meganetaaan/microduck-stackchan/design/arms/Chunky_Flap_Arm_Concepts_v1/MODEL-LICENSE.md

# MicroDuck model license and attribution

Source author: Pollen Robotics

Source: https://github.com/pollen-robotics/microduck_rl

Pinned source revision: `8d0db74916a4f833d1d9b95d6a1d7f4d13b9d5ec`

The source README states:

> 3D model files are licensed under Creative Commons BY-SA-NC.

Exact source declaration:
https://github.com/pollen-robotics/microduck_rl/blob/8d0db74916a4f833d1d9b95d6a1d7f4d13b9d5ec/README.md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

The declaration identifies attribution, noncommercial use, and share-alike conditions. It does not specify a Creative Commons version or link a separate legal-code text. This release preserves that declaration rather than inventing a version such as 4.0. Please obtain clarification from the upstream rights holder if your use depends on a particular version, commercial permission, or another unresolved legal detail. Nothing here expands the rights the original author granted.

## Scope and modifications

This attribution applies to the retained MicroDuck leg/pelvis/battery and other inherited model content, and to derivative geometric content incorporated into the Tab5/Stack-chan prototype generations and arm concepts. It remains relevant after conversion, combining parts, mesh processing, MuJoCo compilation, compression, or rendering.

Project modifications include removal of the articulated head/neck, addition of fixed Tab5 body and enclosure variants, rounded and portrait printable concepts, UART/electronics/wiring proxies, arm-design concepts, collision decomposition, and browser visualization/compiled model packaging. Per-variant README files and generation/validation records describe the changes. These are independent experimental adaptations, not original manufacturer CAD or endorsed products.

When sharing original or modified geometry-bearing material, retain Pollen Robotics attribution, the source link, this license declaration, and a description of changes. Preserve the upstream noncommercial and share-alike conditions. Do not add a blanket Apache or MIT label to these assets. This file is a record of the upstream declaration, not a replacement license or a legal assurance.

## Other mechanical references

Tab5, Radxa ZERO 3W, screws, connectors, and controller/electronics objects modeled by this project are simplified dimensional or keepout proxies unless expressly documented otherwise. Manufacturer documents and CAD were consulted for dimensions; that does not grant rights to redistribute manufacturer source files. The release does not include the original Radxa STEP/DXF, the direct coarse conversion of that STEP, or M5Stack reference photographs/drawings. If such files are added later, check their own redistribution terms separately.
