meganetaaan/microduck-stackchan/design/arms/Chunky_Flap_Arm_Concepts_v1/assets/base_1687_stackchan_microduck_screen_720x1280.png

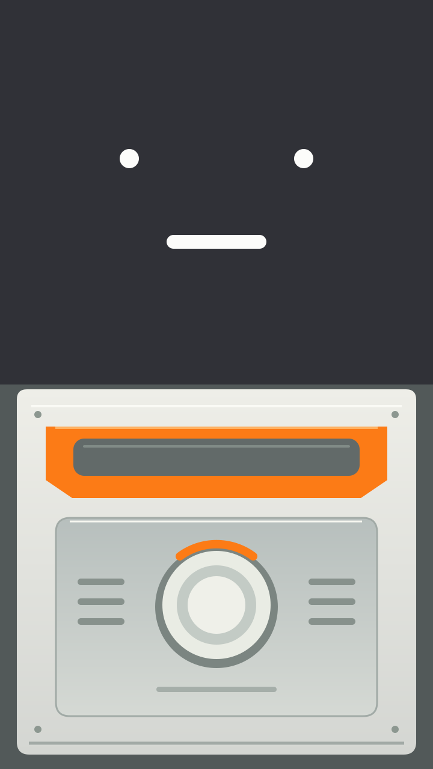
design/arms/Chunky_Flap_Arm_Concepts_v1/assets/base_1687_stackchan_microduck_screen_720x1280.png
