meganetaaan/microduck-stackchan/design/arms/Chunky_Flap_Arm_Concepts_v1/chunky_flaps_front.png

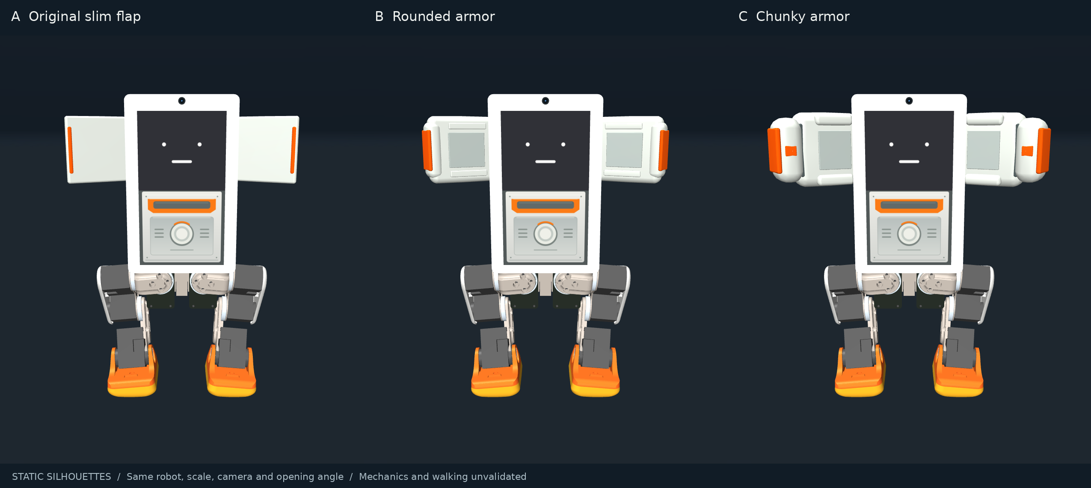
design/arms/Chunky_Flap_Arm_Concepts_v1/chunky_flaps_front.png
