meganetaaan/microduck-stackchan/design/arms/MicroDuck_Stackchan_Arm_Concepts_v1/arm_concepts_comparison.png

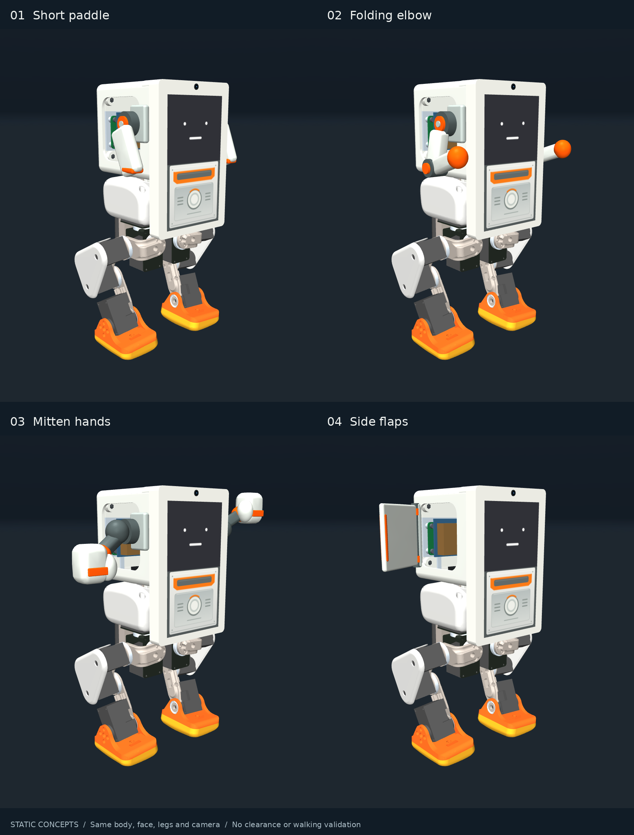
design/arms/MicroDuck_Stackchan_Arm_Concepts_v1/arm_concepts_comparison.png
