meganetaaan/microduck-stackchan/prototype/diagnostics/cutout_candidate_comparison.png

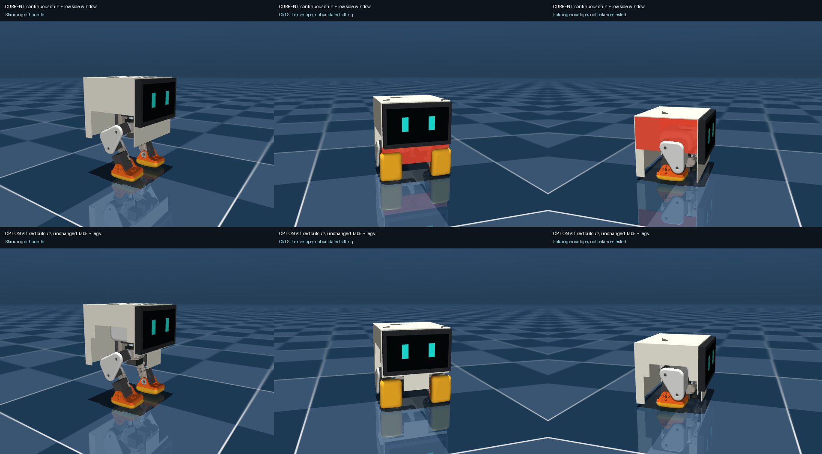
prototype/diagnostics/cutout_candidate_comparison.png
