meganetaaan/microduck-stackchan/prototype/diagnostics/feet_flat_crouch_comparison.png

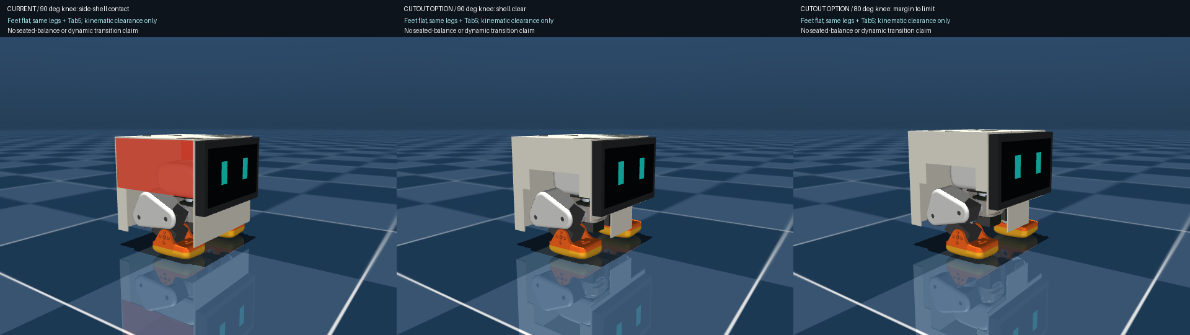
prototype/diagnostics/feet_flat_crouch_comparison.png
