meganetaaan/microduck-stackchan/prototype/portrait/front.png

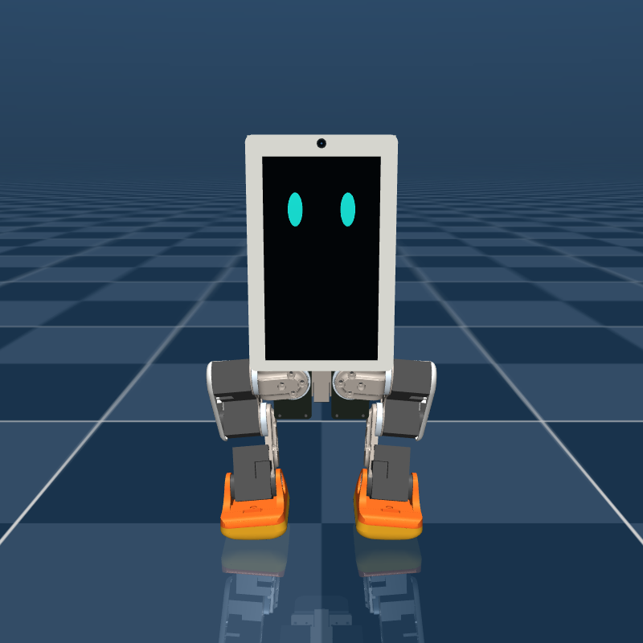
prototype/portrait/front.png
