meganetaaan/microduck-stackchan/prototype/portrait/portrait_clearance_poses.png

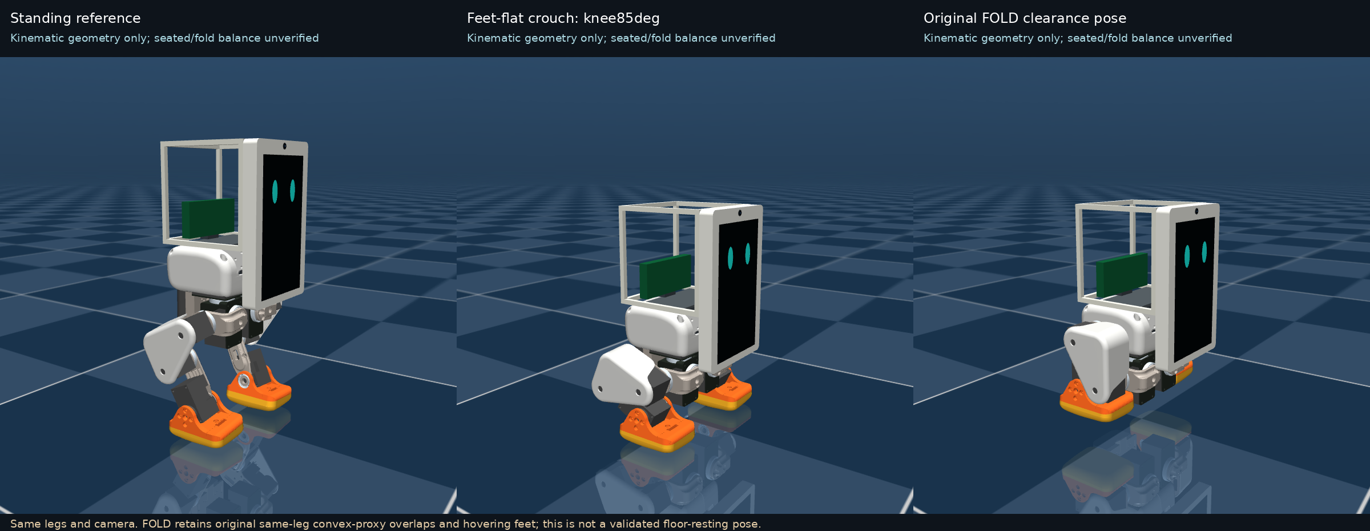
prototype/portrait/portrait_clearance_poses.png
