meganetaaan/microduck-stackchan/prototype/portrait/portrait_comparison.png

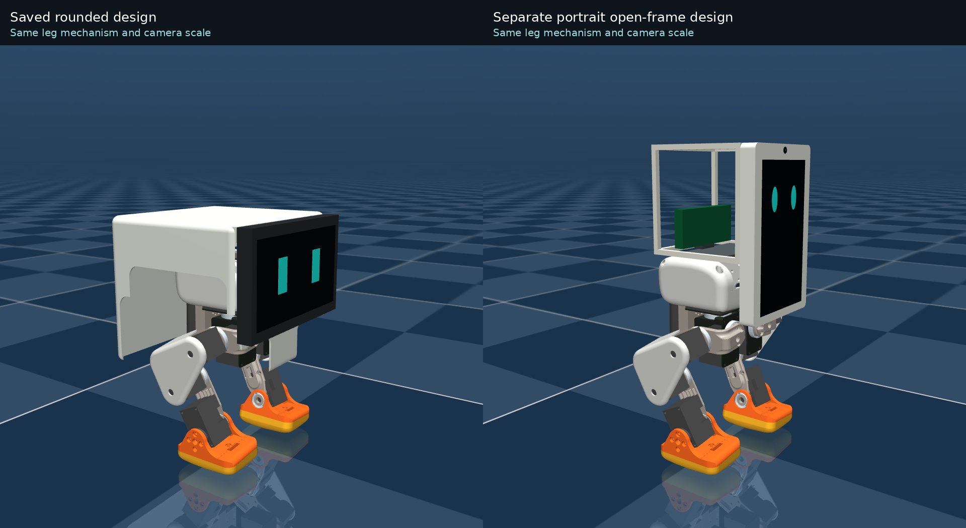
prototype/portrait/portrait_comparison.png
