meganetaaan/microduck-stackchan/prototype/portrait/portrait_face_closeup.png

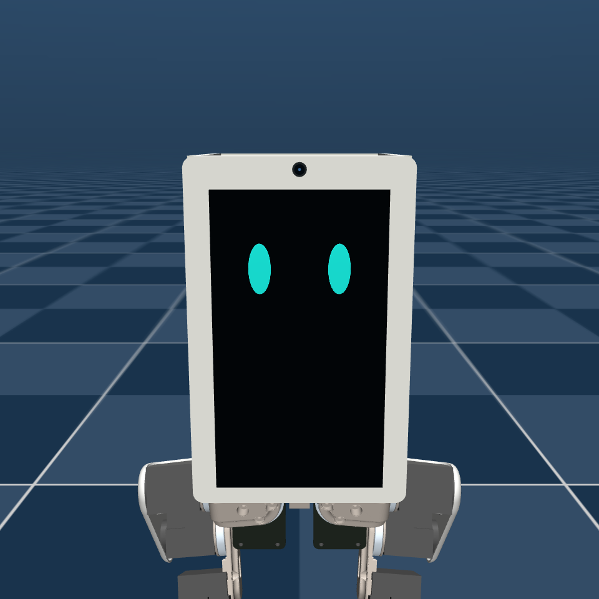
prototype/portrait/portrait_face_closeup.png
