meganetaaan/microduck-stackchan/prototype/portrait/portrait_views.png

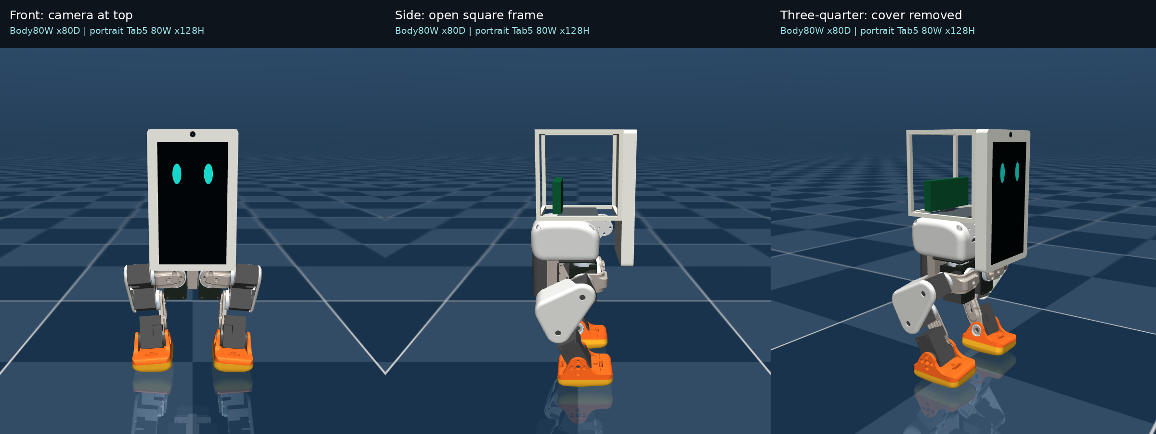
prototype/portrait/portrait_views.png
