meganetaaan/microduck-stackchan/prototype/portrait/side.png

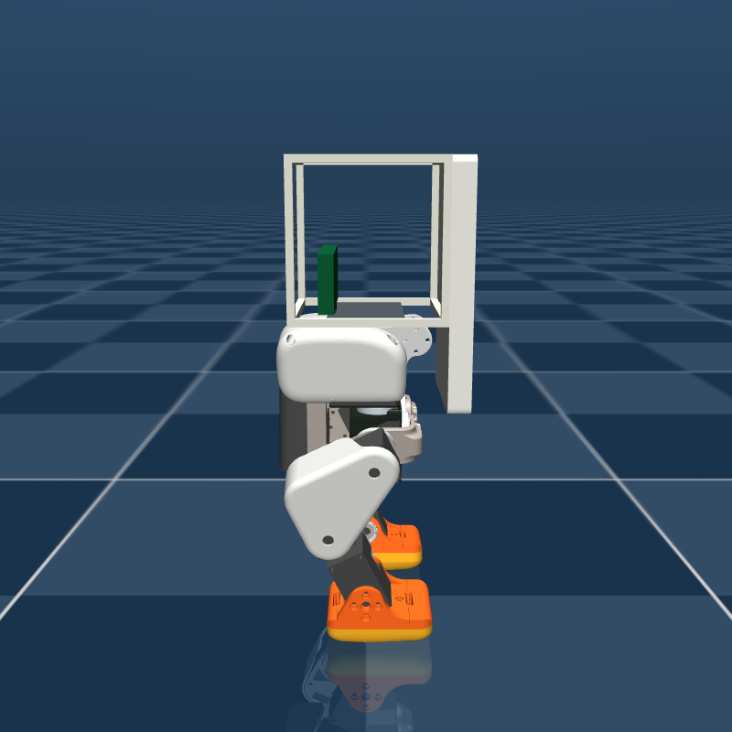
prototype/portrait/side.png
