meganetaaan/microduck-stackchan/prototype/portrait/three-quarter.png

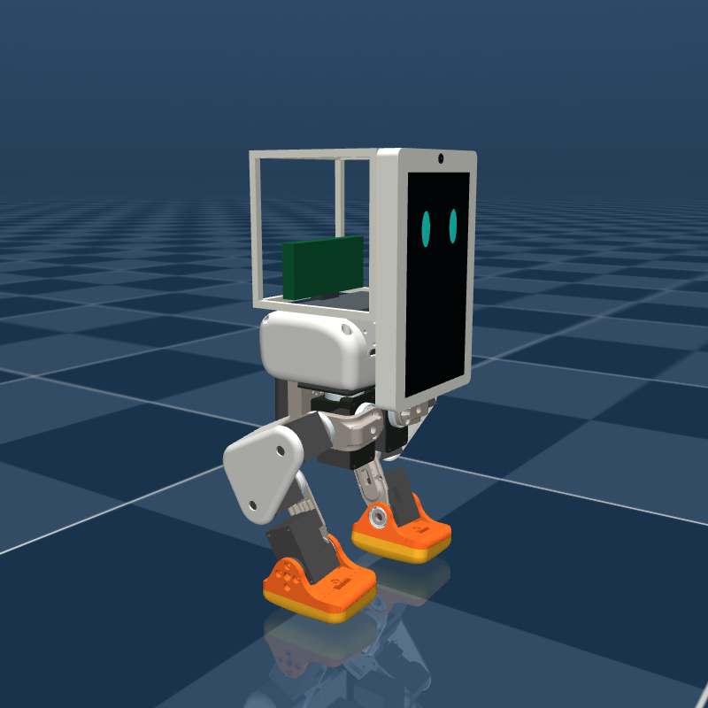
prototype/portrait/three-quarter.png
