meganetaaan/microduck-stackchan/prototype/portrait/walking_demo_initial.png

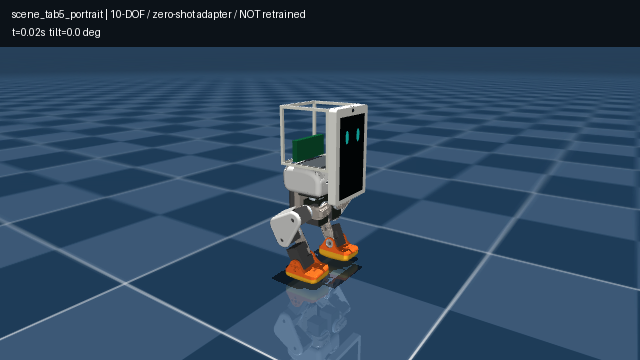
prototype/portrait/walking_demo_initial.png
