meganetaaan/microduck-stackchan/prototype/portrait/walking_frame3s.png

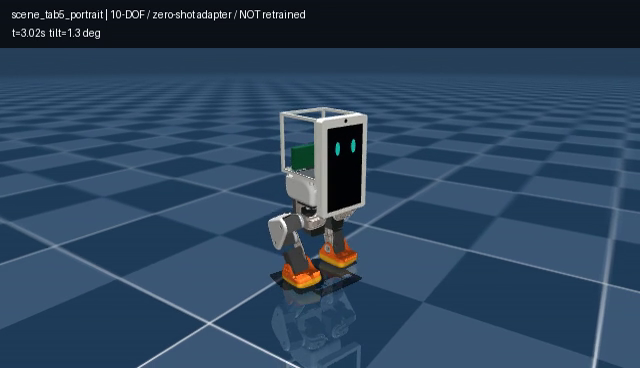
prototype/portrait/walking_frame3s.png
