meganetaaan/microduck-stackchan/prototype/rounded/0_front.png

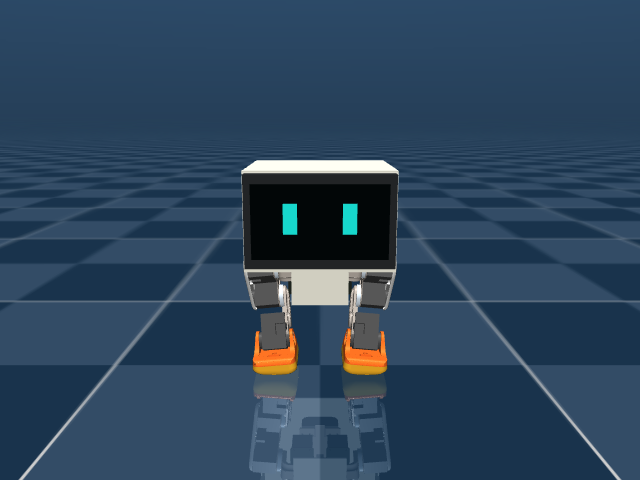
prototype/rounded/0_front.png
