meganetaaan/microduck-stackchan/prototype/rounded/0_side.png

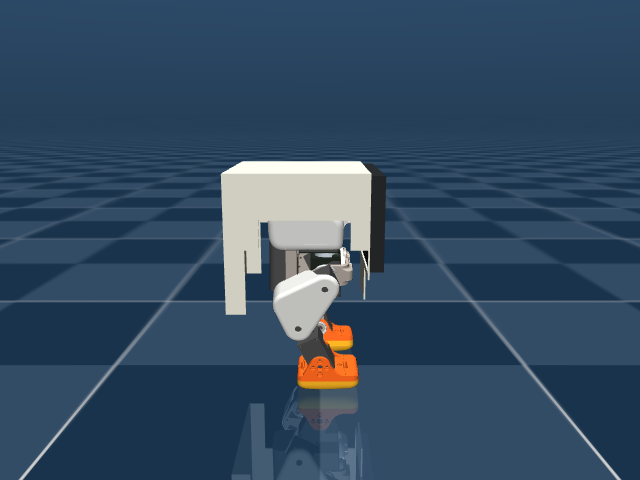
prototype/rounded/0_side.png
