meganetaaan/microduck-stackchan/prototype/rounded/0_three-quarter.png

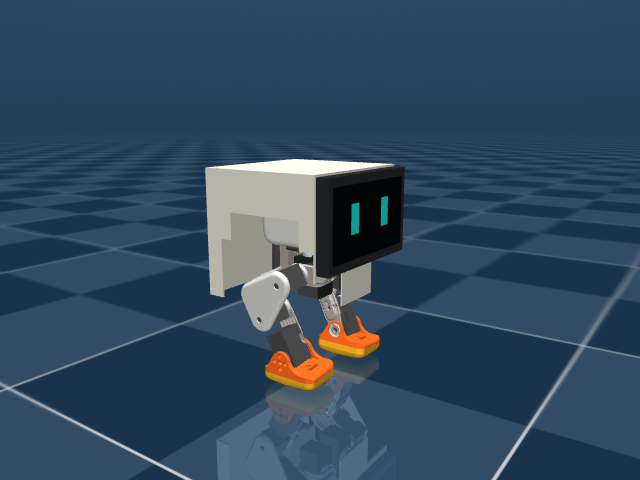
prototype/rounded/0_three-quarter.png
