meganetaaan/microduck-stackchan/prototype/rounded/preview_threequarter.png

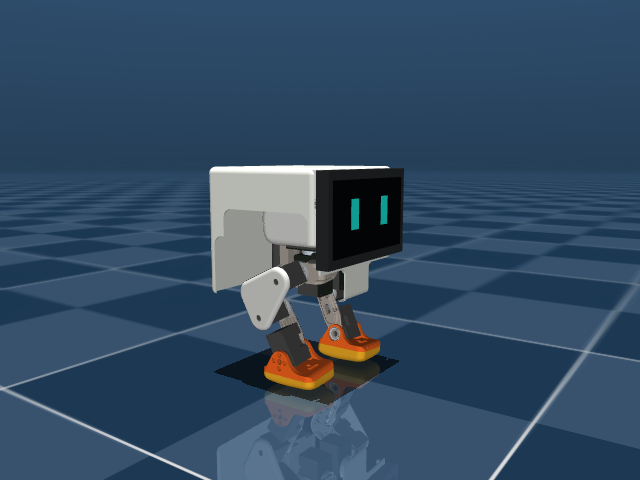
prototype/rounded/preview_threequarter.png
