meganetaaan/microduck-stackchan/prototype/rounded/rounded_before_after.png

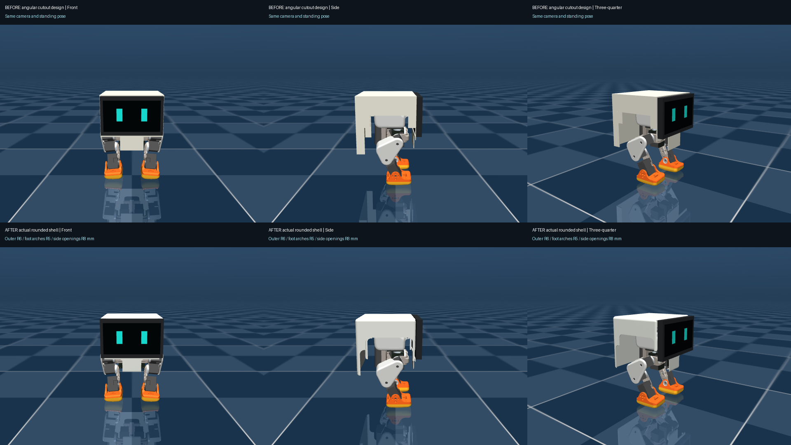
prototype/rounded/rounded_before_after.png
