meganetaaan/microduck-stackchan/prototype/rounded/rounded_closeup.png

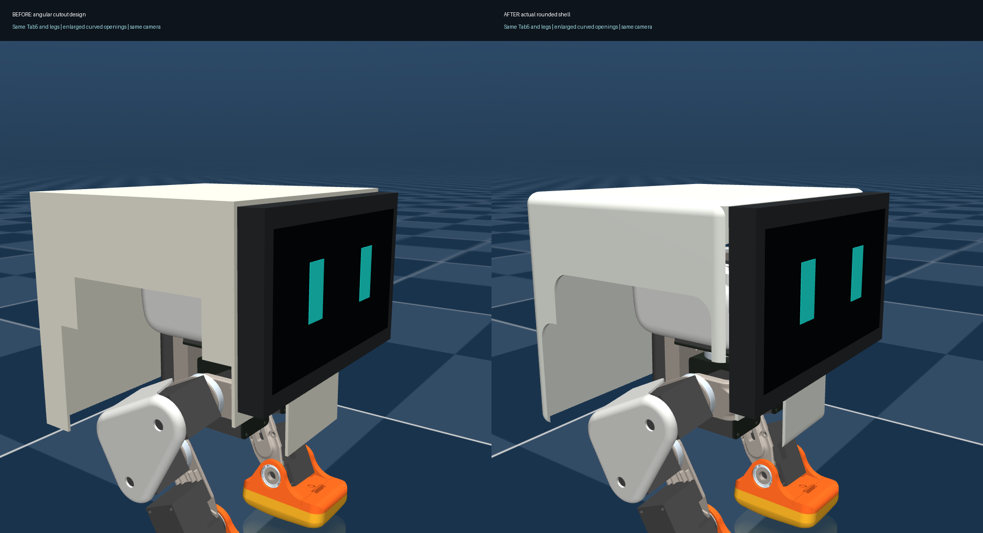
prototype/rounded/rounded_closeup.png
