meganetaaan/microduck-stackchan/prototype/rounded/walking_demo_initial.png

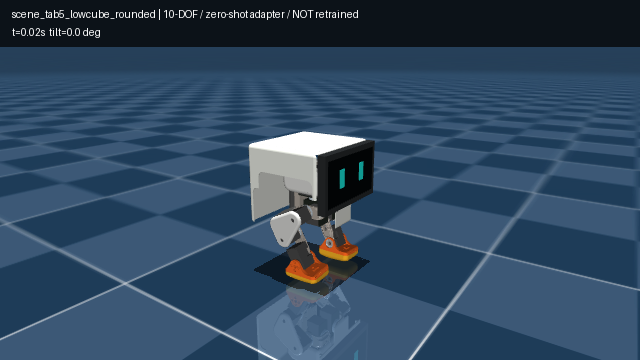
prototype/rounded/walking_demo_initial.png
