meganetaaan/microduck-stackchan/prototype/rounded/walking_frame3s.png

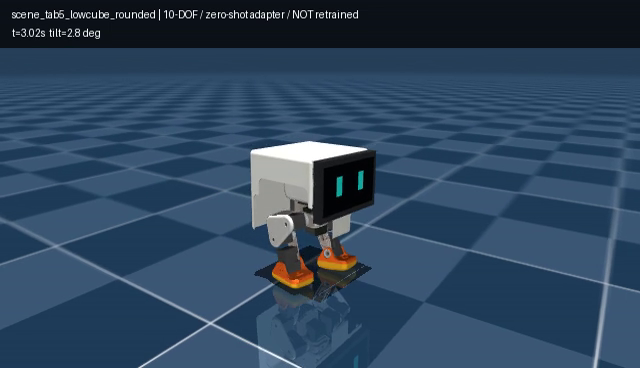
prototype/rounded/walking_frame3s.png
