meganetaaan/microduck-stackchan/docs/BOM-ja.md

# MicroDuck Stack chan UARTアセンブリの暫定部品表

更新日 2026年10月2日

主案は、Tab5をUIとして使い、MicroDuckのSoCへ3.3 V UARTで指示を送る構成です。Tab5は機体の保護・主スイッチ後の2S系統からHVINへ給電します。USB-UARTは直結できない場合の代替案であり、両方を常設する部品表ではありません。

実機がないため、購入・配線仕様を確定していない部品は明記しています。以下の形状・重量は`prototype/assembly_uart/`のモデルに対応します。

## 主な機器と電装

| ID | 部品 | 数量 | モデルでの扱い | 残る確認 |
| --- | --- | ---: | --- | --- |
| E01 | MicroDuckの脚・サーボ・元の胴体・2S系統 | 1式 | 既存機構を維持 | 入手する機体の版、主スイッチ・保護回路・電源取出口 |
| E02 | Tab5本体 | 1 | 80 ×128 ×12 mm、118.4 g、縦向き、カメラ上 | 実機版、裏面細部、HVIN起動・停止、ピーク電流 |
| E03 | Radxa ZERO 3W | 1 | PCB 65 ×30 ×1.6 mm、4穴直径2.8 mmは公式CAD由来。部品群込み12 gを仮定 | 実重量、端子の版差、実際の装着基板 |
| E04 | MicroDuck Robot HAT／制御部 | 1式 | 維持する前提で66 ×34 mmの仮基板と部品空間、計19 g | 実寸・積層高さ・接続方式・重量。公式CADの正確な形状ではない |
| E05 | Radxa GPIO引出し／中継部 | 1式 | 物理pin 16/18とGNDを取り出す仮の空間を確保 | HATで塞がれた端子へのアクセス、必要な中継基板やハーネス |
| E06 | Tab5 M5-Bus差込・引出し部 | 1 | 2×15ピン側の仮差込外形。GPIO6/7とGNDを使用 | 嵌合部、差込深さ、端子・ピン向き |
| E07 | 3.3 V UART線 | 3芯1組 | TX、RX、GND。青い直径約2 mmの束で配置 | 線径、端子、長さ、引張保持、ノイズ・通信確認 |
| E08 | Tab5付属1.25 mmピッチ6Pケーブル | 1 | J7 pin 1 GND、pin 2 HVIN。赤い電源線として配置 | 実物の極性・向き・許容電流。未使用4線は個別絶縁 |
| E09 | 交換可能なロボット側ピッグテール | 1式 | 機体側終端と内側の着脱部、分岐入力線を仮配置 | 取出口とコネクタ系列、極性、線径、長さ、接点容量 |
| E10 | 分岐保護モジュール | 1系統 | 20 ×30 mmの仮基板、保護素子・入出力コネクタの空間を配置 | ヒューズ等の方式、電流定格、回路、コネクタ、固定方法 |
| E11 | 保護部用絶縁・接着支持材 | 1式 | 仮の0.5 mmパッドとプリントトレー | 材質、保持力、温度、実モジュールの取付 |
| E12 | 電源貫通部グロメット | 1 | 名目直径7 mm穴、直径4 mm内側通路の仮形状 | 実品または材質・印刷方法、パネル厚と保持力 |
| E13 | 未使用線絶縁・追加配線固定材 | 1式 | 4線の個別絶縁と、ガイドに沿う固定を見込む | 現物に合う径・数量。ガイドだけで引張保持を保証しない |
| E14 | 外付け降圧器 | 0 | 主案はTab5内蔵降圧回路を使う | 入力・ノイズ・負荷測定で必要なら見直す |
| E15 | Tab5用追加バッテリー | 0 | 主案に含めない | 停止・瞬停・再起動要件を実機で確認 |
| E16 | USB-UART変換器とRadxa側USB接続部 | 0、代替時のみ1式 | 直結不可の場合の3.3 Vロジック用代替。現在のモデルに重ねて常設していない | USBホスト接続、ドライバー、論理レベル、配線。Tab5の主電源にはしない |

Radxaの総重量の公式値は見つかっておらず、12 gは設計上の仮定です。HAT、コネクタ、保護部、配線の重量も計測値ではありません。標準モデル736.537 gに対し、未確定部品の軽量・重量仮定は717.815〜767.712 gです。

## UART接続の選択

| Tab5側 | 接続 | MicroDuck SoC側 |
| --- | --- | --- |
| M5-Bus物理pin 16、GPIO6、UART TXとして設定 | → | Radxa 40ピン物理pin 16、UART4 RX_M1 |
| M5-Bus物理pin 15、GPIO7、UART RXとして設定 | ← | Radxa 40ピン物理pin 18、UART4 TX_M1 |
| GND | 共通 | GND |

物理ピン番号とGPIO番号を混同しません。使用するRadxaのGND端子は実物の接続しやすさと既存HATを確認して決めます。5 Vや3.3 Vの給電線を、この信号3本の代わりに接続しません。OSのUART有効化、Tab5のピン設定、HATとのピン共用は未確認です。

## 印刷部品

各1個。現在の5部品は`prototype/assembly_uart/stl/`にあり、単位はmmです。

| ID | 部品 | ファイル | 計算上の樹脂質量 |
| --- | --- | --- | ---: |
| P01 | ボディケージ、M5-Bus逃げ・電源貫通穴・M3頭逃げ付き | `body_cage_mm.stl` | 約64.58 g |
| P02 | 中央マウント、M2ナット逃げ付き | `central_mount_mm.stl` | 約7.04 g |
| P03 | 電子部品キャリア、基板支持・配線ガイド付き | `electronics_carrier_mm.stl` | 約17.40 g |
| P04 | 電源保護部の仮トレー | `protection_tray_mm.stl` | 約2.35 g |
| P05 | 背面カバー、前版と同一 | `rear_cover_mm.stl` | 約10.99 g |

合計約102.36 gはPLA密度1,240 kg/m³と実体積からの計算値です。実際の材料、スライス設定、支持材、実測重量ではありません。グロメットや基板をこれらと同じ樹脂で印刷する想定ではありません。

## ねじと取付部

| ID | 用途 | 数量 | 現モデルの名目形状 | 取扱い |
| --- | --- | ---: | --- | --- |
| F01 | 背面カバー用M2ねじ | 4 | 軸長8 mm、頭径3.9 × 厚さ0.7 mm | 薄頭の仮形状。通常のM2なべねじの適合は未確認 |
| F02 | 同M2六角ナット | 4 | 二面幅4 × 厚さ1.6 mm | 印刷公差と実物寸法を確認 |
| F03 | 元の胴体スロット用M2クランプねじ | 1 | 軸長6.8 mm、頭径3.8 × 厚さ1.5 mm | 購入する長さ・形状、締付力、元プレートの変形は未確定 |
| F04 | 同M2六角ナット | 1 | 二面幅4 × 厚さ1.6 mm | 回り止め・ねじかかりを確認 |
| F05 | 金属製大径ワッシャー | 1 | 外径8、内径2.7、厚さ0.8 mm | M2.5用相当をM2クランプで使う仮案 |
| F06 | 中央マウント・ボディ・キャリア用M2ねじ | 2 | 軸長10 mm、頭径3.8 × 厚さ1.6 mm | 対応する穴とナット逃げをモデル化。実品・印刷強度は未検証 |
| F07 | 同M2六角ナット | 2 | 二面幅4 × 厚さ1.6 mm | 中央マウントの側面から入れる仮構造 |
| F08 | Radxa固定用M2.5ねじ | 4 | 軸長12 mm、頭径4.5 × 厚さ2.5 mm | 通し穴・支持部に対応。実基板の部品干渉と実品寸法を確認 |
| F09 | 同M2.5六角ナット | 4 | 二面幅5 × 厚さ2 mm | キャリア裏側に配置。締付トルクは未規定 |
| F10 | Tab5背面M3ねじ | 4 | モデルは頭径5.5 × 厚さ3 mmと外側9 mmの軸だけ | 内部へ入る長さを未確定のまま残す。完成ねじの全長を9 mmとは扱わない |
| F11 | 未確定のM3内部部分・小固定具 | 1式 | 質量1 gの追加見込み | 実物に合わせて置換。0〜2 gの感度条件も用意 |
| F12 | 熱圧入インサート | 0 | 現モデルでは使用しない | 将来方式を変える場合のみ追加 |

したがってモデル上の本数はM2ねじ7本とナット7個、M2.5ねじ4本とナット4個、M3の外側部分4本、大径ワッシャー1枚です。コネクタ、HAT、保護モジュール等の実製品に付属する固定具までは確定していません。

Tab5の図面表記`M3*10`を10 mmの挿入許容深さと読み替えません。M3の頭逃げや各プリント部の局所的な薄肉について、試し刷りと強度確認が必要です。

## 出典と追跡

- [Tab5公式資料](https://docs.m5stack.com/en/core/Tab5)、[ピン図](https://m5stack-doc.oss-cn-shenzhen.aliyuncs.com/1132/C145_Pinmap_Overview.png)、[回路図](https://m5stack-doc.oss-cn-shenzhen.aliyuncs.com/1132/Tab5_Schematics_PDF.pdf)
- [Radxa ZERO 3W公式ハードウェア資料](https://docs.radxa.com/en/zero/zero3/download)、[GPIO表](https://docs.radxa.com/en/zero/zero3/hardware-design/hardware-interface)
- [MicroDuckのHAT構成](https://github.com/pollen-robotics/microduck/blob/main/deploy/audio/i2c3-pihat.dts)
- [モデルの部品一覧と質量](../prototype/assembly_uart/assembly_report.json)、[公式寸法と仮定を分けた根拠](../prototype/assembly_uart/sources/component_envelopes_report.json)、[設計前提と確認表](DESIGN-ASSUMPTIONS-ja.md)
