meganetaaan/microduck-stackchan/docs/history/v3-wifi-plan/BOM-ja.md

# MicroDuck Stack chan 縦型Tab5案の暫定部品表

更新日 2026年10月2日

実機が手元にない段階で、選定済みの縦型Tab5・前面フラット接触部の設計を進めるための部品表です。外装形状は現在のモデルを維持し、電源・通信・取付部品は確認できた範囲と仮置きを分けています。この表だけで発注や実機への配線を確定しません。

## 今回の仮置き

- Tab5は画面・顔・操作UIを担当し、MicroDuckのSoCが歩行制御を担当する
- 電源はMicroDuckの保護・主電源スイッチ後の2S系統から分岐し、Tab5のExtPort2 J7へ供給する構成を第一案とする
- Tab5の内蔵降圧回路を使い、外付け降圧器とTab5用の別バッテリーは第一案に含めない
- 通信はWi-Fiで指示と状態を交換する。本試作のTab5連携API、接続方式、通信断時の挙動は未実装・未確定
- ロボット側の電源接続は交換可能な短い変換ハーネスにし、コネクタが判明するまで専用の外装穴を固定しない

詳細は[設計前提と確認項目](DESIGN-ASSUMPTIONS-ja.md)を参照してください。

## 機器と電装

| ID | 部品 | 暫定数量 | 現時点の扱い | 確定に必要なこと |
| --- | --- | ---: | --- | --- |
| E01 | MicroDuck本体、SoC、2S電源系 | 1式 | 元の脚・サーボ・制御基板・バッテリー系を使う設計前提 | 入手する機体の版、SoC、保護回路、主スイッチ、電源コネクタの確認 |
| E02 | M5Stack Tab5本体 | 1 | 縦向き、カメラ上、顔は画面上半分。別バッテリーなし | 実機版、背面形状、HVIN起動動作、最大消費電流の確認 |
| E03 | Tab5付属1.25 mmピッチ6ピンケーブル | 1 | ExtPort2 J7の電源入力用。正式なコネクタシリーズや線色は推定しない | ピン番号と向き、付属ケーブル実物、接点・線材の許容電流 |
| E04 | ロボット側交換用電源ピッグテール | 1式 | 保護・主スイッチ後の分岐とTab5側ケーブルを接続する短い交換部品 | ロボット側コネクタ、極性、線径、長さ、ロック方式、許容電流 |
| E05 | 分岐側ヒューズ等の保護部品 | 1系統分を仮置き | 定格・方式・取付場所はTBD。現時点で電流値を指定しない | Tab5の突入・ピーク電流、線材・接点定格、故障時の遮断条件 |
| E06 | 未使用線の端末絶縁材 | 4本分 | J7の未使用4線を1本ずつ絶縁する。まとめて導体同士を接触させない | 線径に合う絶縁材と処理方法 |
| E07 | ハーネス固定・ストレインリリーフ部材 | 1式 | 仮置き。外装への専用穴・固定座の寸法はまだ決めない | ケーブル径、コネクタ寸法、曲げ半径、着脱方向、脚との干渉 |
| E08 | 外付け降圧器 | 0 | 第一案ではTab5の6–24 V入力と内蔵降圧回路を使う | 実機の供給範囲・ノイズ・電流測定で必要なら再検討 |
| E09 | Tab5用追加バッテリー | 0 | 第一案には含めない | 終了処理・瞬停対策の要件が変わる場合だけ再検討 |
| E10 | USB接続ケーブル | 常設分は0 | 第一案の主電源・常時通信には使わない | 開発・保守で使う場合は給電経路と逆流を別途確認 |

J7はpin 1がGND、pin 2がSYS_VIN（製品表記HVIN、6–24 V）です。pin 3/4のRS485 A/B、pin 5/6のSDA/SCLは第一案では使用しません。配線の向きは公式ピン図と実物を照合し、ケーブルの色だけで判断しません。これは結線方針であり、実機に適用する確定配線図や通電手順ではありません。[S1][S2][S3]

Radxa ZERO 3WのUSBホスト出力は資料上500 mAです。Tab5を十分に給電できるとは仮定しません。また、普通のUSBケーブルを「データ専用」とは扱いません。外部電源とUSBを併用する場合は、双方の電源経路を確認する必要があります。[S4]

## 3Dプリント部品

以下は各1個です。STLは`prototype/portrait_print/stl/`、推奨向きのSTLは`stl_print_oriented/`にあります。座標単位はmmです。

| ID | 部品 | ファイル | 外形の最大寸法 | モデル上の樹脂質量 |
| --- | --- | --- | --- | ---: |
| P01 | ボディケージ | `body_cage_mm.stl` | 奥行80 × 幅80 × 高さ80 mm | 約65.49 g |
| P02 | 背面カバー | `rear_cover_mm.stl` | 幅59.5 × 高さ63.5 × 厚さ2.4 mm | 約10.99 g |
| P03 | 中央マウント | `central_mount_mm.stl` | 奥行24 × 幅12 × 高さ46 mm | 約7.18 g |
| P04 | SoC仮置き用支持台 | `compute_pedestal_mm.stl` | 奥行8 × 幅16 × 高さ5.6 mm | 約0.86 g |

計約84.52 gはPLA密度1,240 kg/m³による実体積からの計算値です。実際のスライス設定、支持材、材料や実測重量ではありません。P04は実基板の取付穴を備えた確定マウントではありません。

## ねじ類と取付部

「モデルにある寸法」と「購入できる確定仕様」を区別します。ねじの長さ・頭形状・かかり代は、印刷部品と機器の実測後に選びます。

| ID | 用途 | 数量 | 現モデルの寸法・構成 | 未確定事項 |
| --- | --- | ---: | --- | --- |
| F01 | 背面カバー用M2ねじ | 4 | 軸長8 mm、頭径3.9 mm、頭厚0.7 mmの仮形状 | 市販品の規格・頭形状。通常のM2なべねじが適合するとは限らない |
| F02 | 背面カバー用M2六角ナット | 4 | 二面幅4 mm、厚さ1.6 mmの仮形状 | 実ナット公差と印刷収縮。ナット穴は二面幅4.3 mm、生成形状の深さ2.0 mm |
| F03 | 元の胴体スロットを挟むM2ねじ | 1 | 軸長6.8 mm、頭径3.8 mm、頭厚1.5 mmの仮形状 | 市販のねじ長さ、締付力、約1 mmの元プレートの変形、緩み止め |
| F04 | 上記クランプ用M2六角ナット | 1 | 二面幅4 mm、厚さ1.6 mm | 接触・かかり代・回り止め |
| F05 | 金属製大径ワッシャー | 1 | 外径8、内径2.7、厚さ0.8 mm。M2.5用相当をM2クランプで使う仮案 | 実品の寸法・材質・当たり。樹脂ワッシャーには置換しない前提 |
| F06 | Tab5背面用M3ねじ | 4か所分を想定 | 外装側は直径3.4 mmの通し穴、名目9 mmの取付ランド | ねじ自体は未モデル化。Tab5の許容かかり代と適切な全長を実測する |
| F07 | ボディと中央マウントの上側固定具 | 2か所分、部品数TBD | 直径2.2 mmのパイロット／通し穴 | ねじ、ナット、インサート等の方式そのものが未選定 |
| F08 | SoC基板の固定具 | TBD | 基板固有の穴、ねじ、スペーサーは未設計 | 実基板の寸法・穴・端子・絶縁・放熱を確認 |
| F09 | 熱圧入インサート | 0（現モデル） | 現モデルにインサート座はない | 今後方式を選ぶ場合にのみ追加検討 |

明示的な金属形状はM2ねじ5本、M2ナット5個、ワッシャー1枚です。F06〜F08を含む完成品の総ねじ数ではありません。Tab5の図面表記`M3*10`を、ねじを10 mm挿入できるという意味には読み替えません。[S3]

背面カバーの頭逃げは直径4.2 × 深さ1.0 mmです。F01の薄い仮頭形状を理由に、未確認の標準ねじを発注しません。ソースの`rear_nut_pocket_depth_mm=1.9`は現生成処理で使われておらず、実際のナット穴深さは2.0 mmです。今回は形状を変更していません。

## 出典

- [S1 Tab5公式製品資料](https://docs.m5stack.com/en/core/Tab5)
- [S2 Tab5公式回路図](https://m5stack-doc.oss-cn-shenzhen.aliyuncs.com/1132/Tab5_Schematics_PDF.pdf) J7と電源経路、4〜5ページ
- [S3 Tab5公式ピン図](https://m5stack-doc.oss-cn-shenzhen.aliyuncs.com/1132/C145_Pinmap_Overview.png)／[公式寸法図](https://m5stack-doc.oss-cn-shenzhen.aliyuncs.com/1132/C145_Model_Size_page_01.png)
- [S4 Radxa ZERO 3W製品資料](https://dl.radxa.com/zero3/docs/hw/3w/radxa_zero_3w_product_brief.pdf) 第6.2節
- [現在のパラメータ](../prototype/portrait_print/parameters.json)、[形状生成ソース](../prototype/portrait_print/build_print_design.py)、[形状と質量の報告](../prototype/portrait_print/geometry_report.json)
