meganetaaan/microduck-stackchan/prototype/portrait_print/print_parts_orientation.png

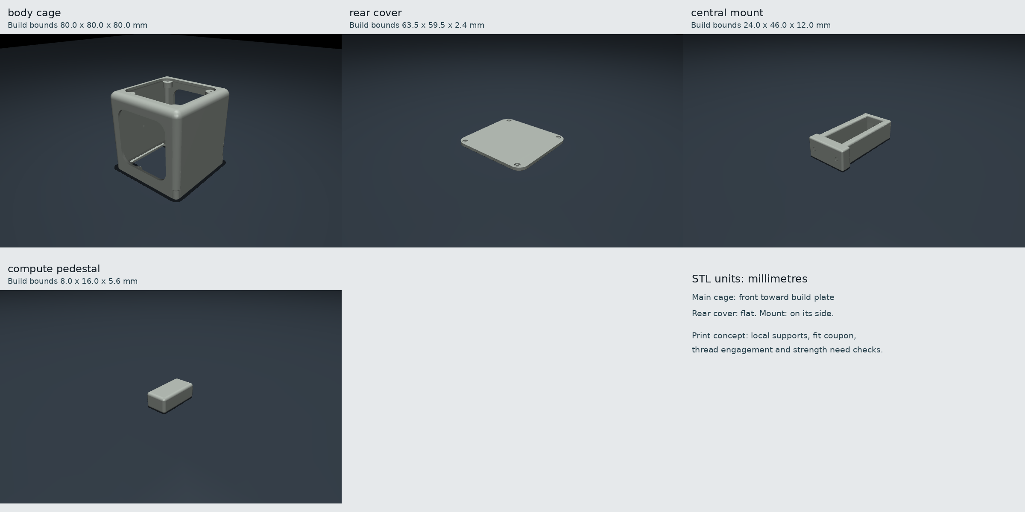
prototype/portrait_print/print_parts_orientation.png
