meganetaaan/microduck-stackchan/design/arms/Chunky_Flap_Arm_Concepts_v1/assets/C_chunky_armor_stowed_R_main_armor.obj

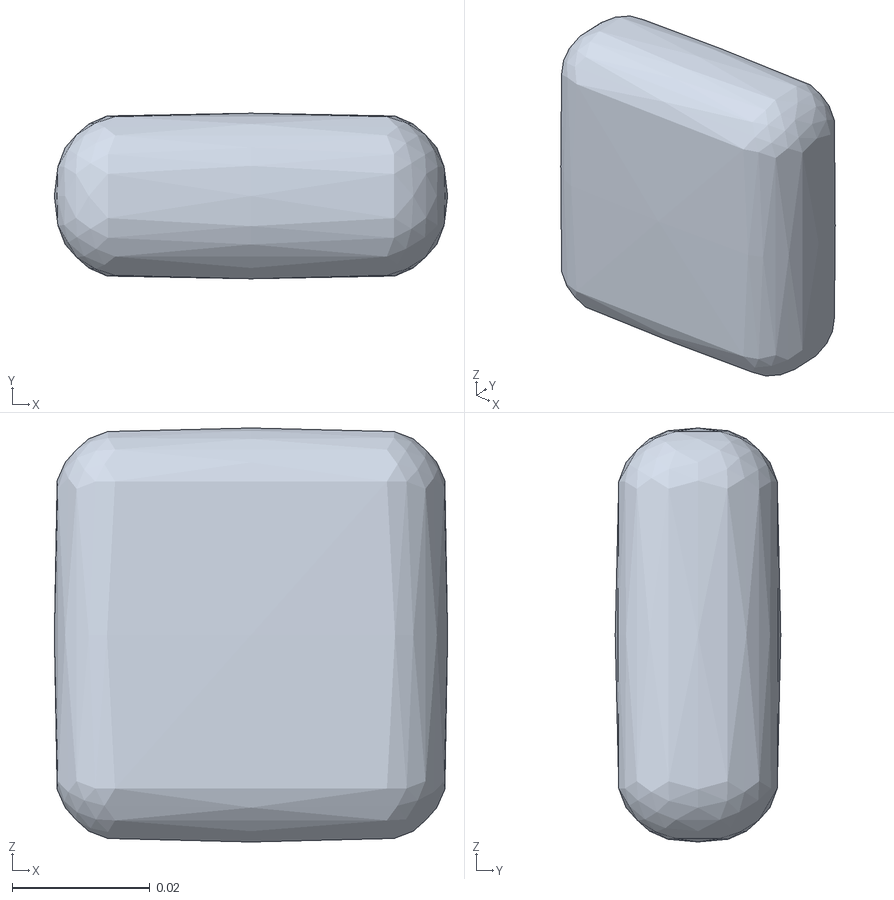
[picture p29: CAD file, 2026-10-03]
design/arms/Chunky_Flap_Arm_Concepts_v1/assets/C_chunky_armor_stowed_R_main_armor.obj
0.057 x 0.024 x 0.06
