meganetaaan/microduck-stackchan/design/arms/Chunky_Flap_Arm_Concepts_v1/assets/C_chunky_armor_display_R_main_armor.obj

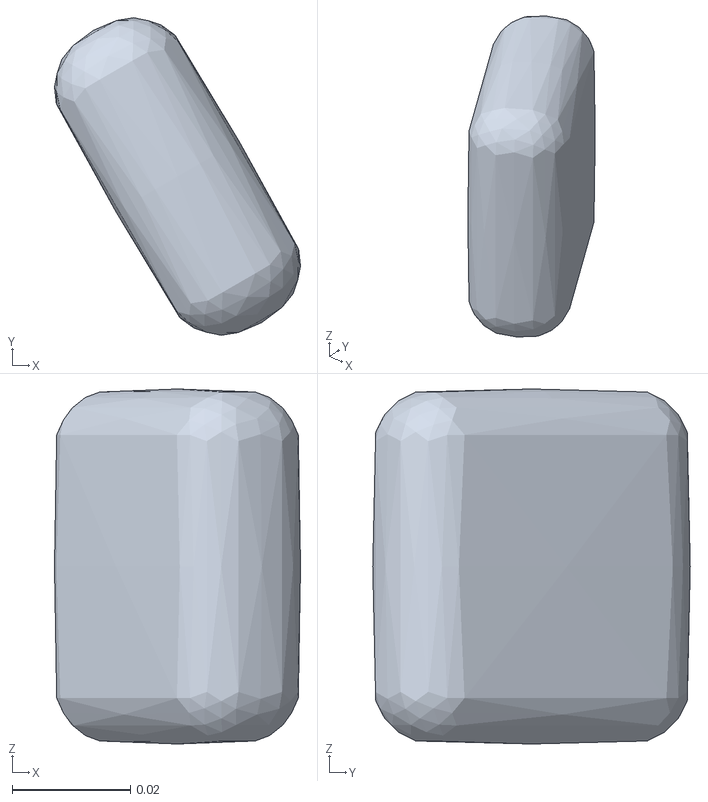
[picture p30: CAD file, 2026-10-03]
design/arms/Chunky_Flap_Arm_Concepts_v1/assets/C_chunky_armor_display_R_main_armor.obj
0.0416 x 0.0537 x 0.06
