meganetaaan/microduck-stackchan/design/arms/Chunky_Flap_Arm_Concepts_v1/assets/B_rounded_armor_stowed_R_lower_rib_-1.obj

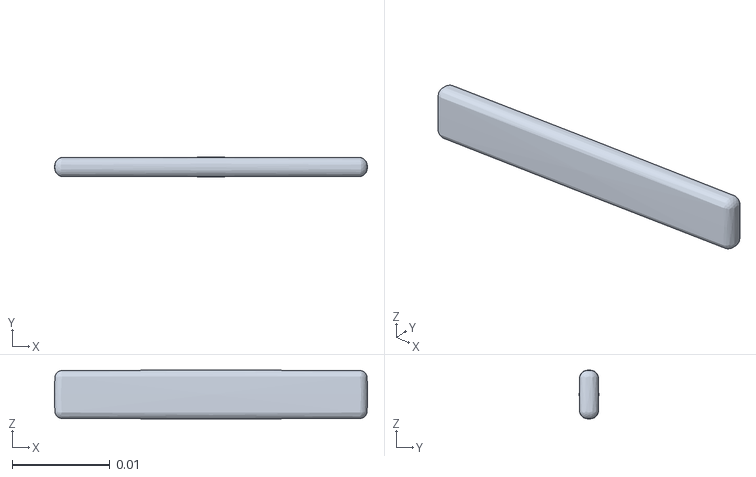
[picture p31: CAD file, 2026-10-03]
design/arms/Chunky_Flap_Arm_Concepts_v1/assets/B_rounded_armor_stowed_R_lower_rib_-1.obj
0.032 x 0.002 x 0.005
