meganetaaan/microduck-stackchan/design/arms/MicroDuck_Stackchan_Arm_Concepts_v1/assets/02_elbow_display_L_orange_cap.obj

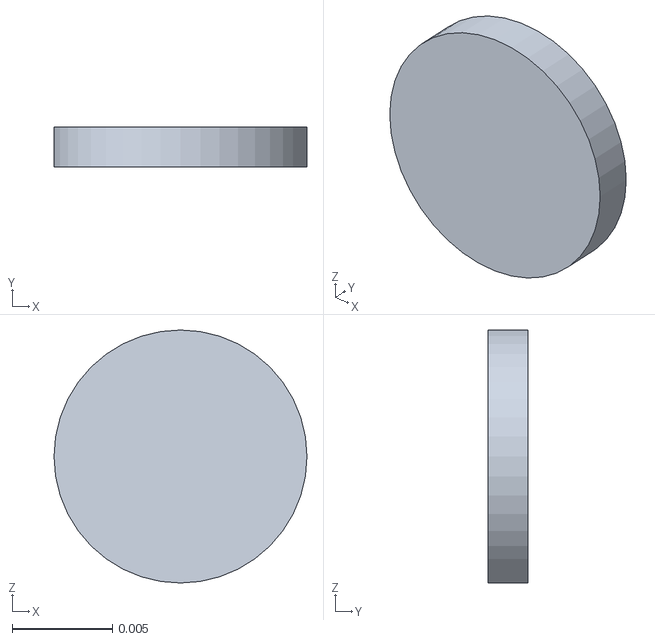
[picture p32: CAD file, 2026-10-03]
design/arms/MicroDuck_Stackchan_Arm_Concepts_v1/assets/02_elbow_display_L_orange_cap.obj
0.0126 x 0.002 x 0.0126
