meganetaaan/microduck-stackchan/prototype/assembly_uart/assets/cube_uart_body_cage_0397.obj

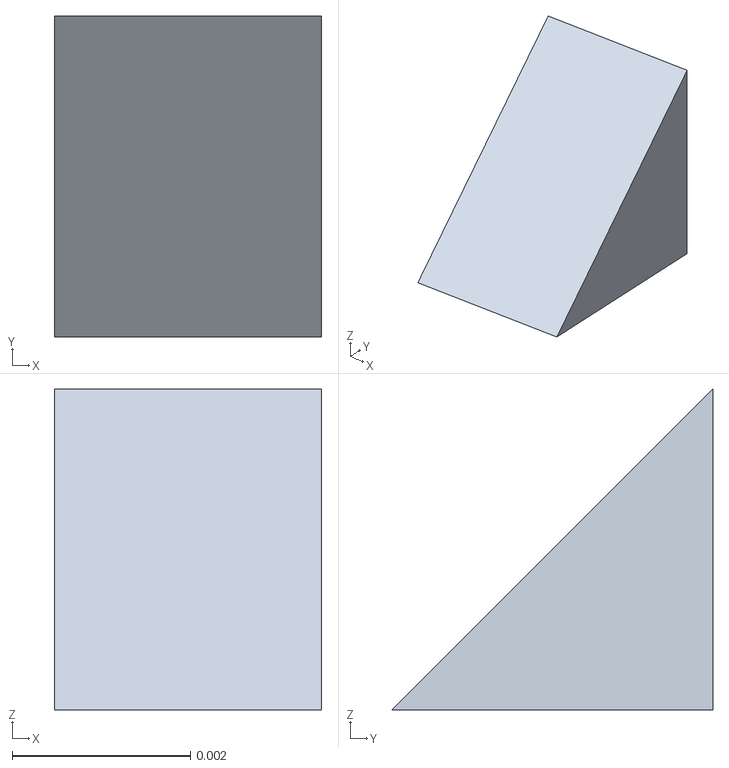
[picture p33: CAD file, 2026-10-03]
prototype/assembly_uart/assets/cube_uart_body_cage_0397.obj
0.003 x 0.0036 x 0.0036
