meganetaaan/microduck-stackchan/prototype/assembly_uart/screen_visual/assets/screen_surface.obj

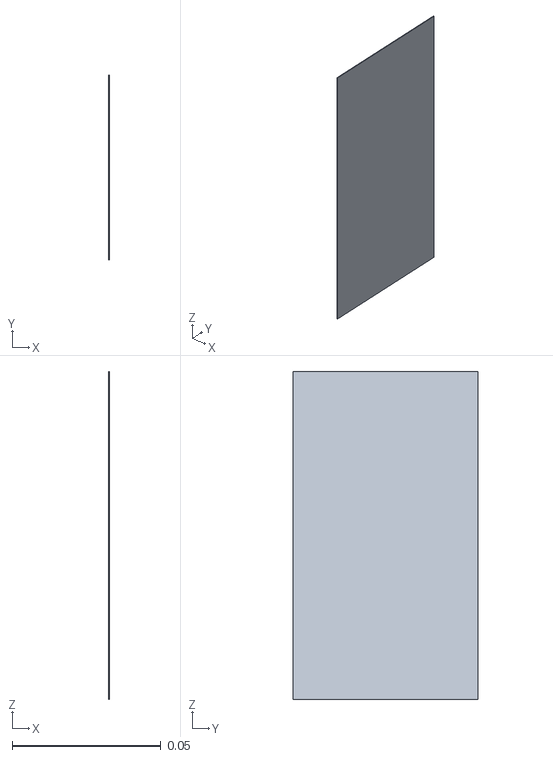
[picture p34: CAD file, 2026-10-03]
prototype/assembly_uart/screen_visual/assets/screen_surface.obj
0.0003 x 0.0622 x 0.11
