meganetaaan/microduck-stackchan/prototype/assembly_uart/stl/protection_tray_mm.stl

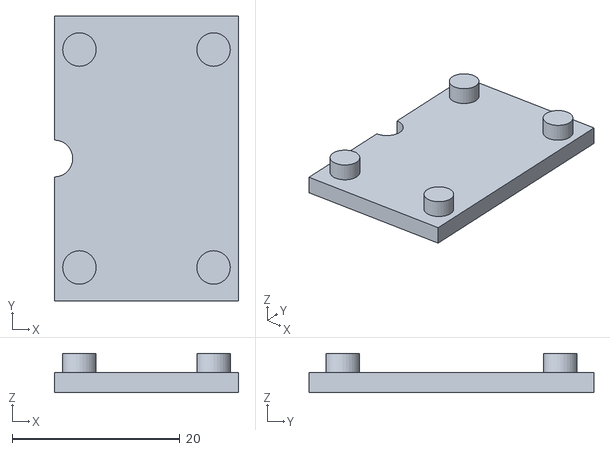
[picture p35: CAD file, 2026-10-03]
prototype/assembly_uart/stl/protection_tray_mm.stl
22.0 x 34.0 x 4.70
