meganetaaan/microduck-stackchan/prototype/portrait/assets/tab5_rounded.obj

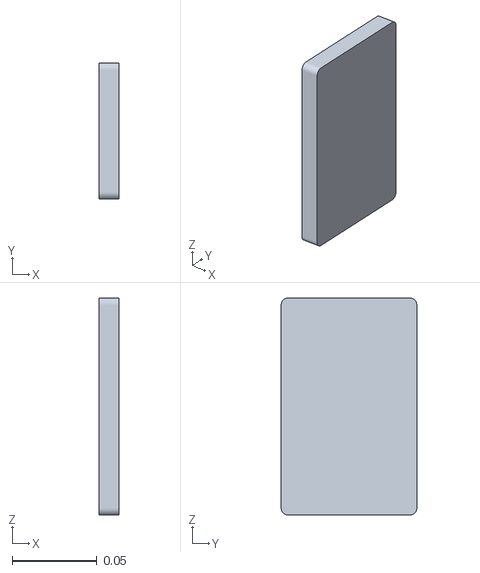
[picture p36: CAD file, 2026-10-03]
prototype/portrait/assets/tab5_rounded.obj
0.012 x 0.08 x 0.128
