meganetaaan/microduck-stackchan/prototype/portrait_print/assets/collision_0998.obj

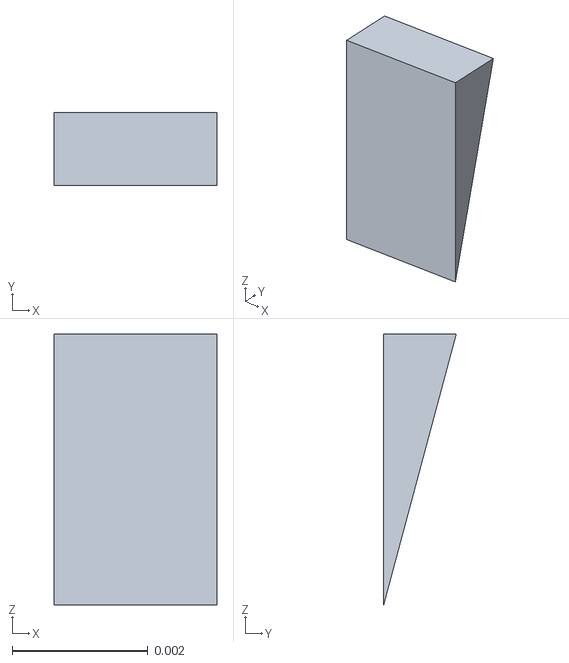
[picture p37: CAD file, 2026-10-03]
prototype/portrait_print/assets/collision_0998.obj
0.0024 x 0.00107 x 0.004
