meganetaaan/microduck-stackchan/prototype/portrait_print/stl/rear_cover_mm.stl

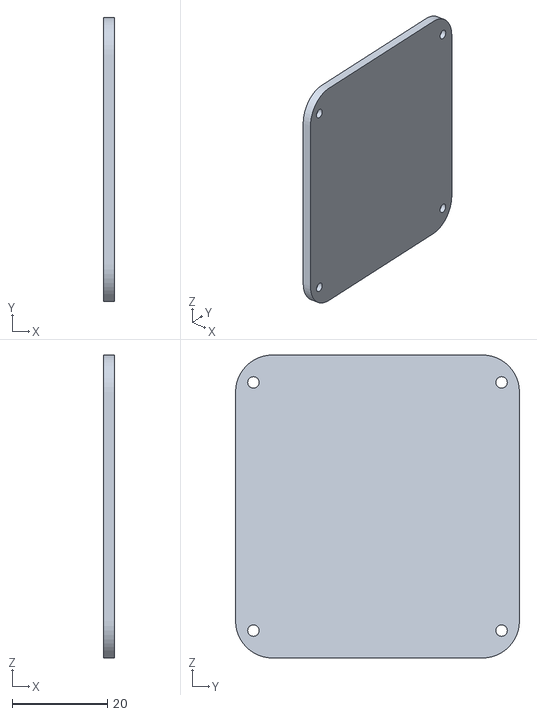
[picture p38: CAD file, 2026-10-03]
prototype/portrait_print/stl/rear_cover_mm.stl
2.40 x 59.5 x 63.5
