meganetaaan/microduck-stackchan/prototype/portrait_print/stl_print_oriented/compute_pedestal_print_mm.stl

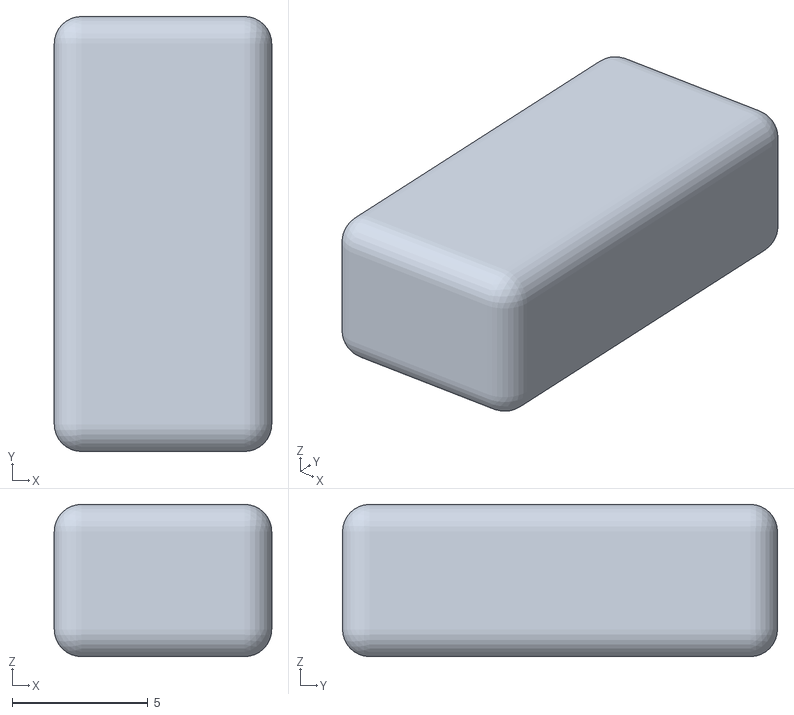
[picture p39: CAD file, 2026-10-03]
prototype/portrait_print/stl_print_oriented/compute_pedestal_print_mm.stl
8.00 x 16.0 x 5.60
