meganetaaan/microduck-stackchan/prototype/portrait_print_v1/assets/collision_0971.obj

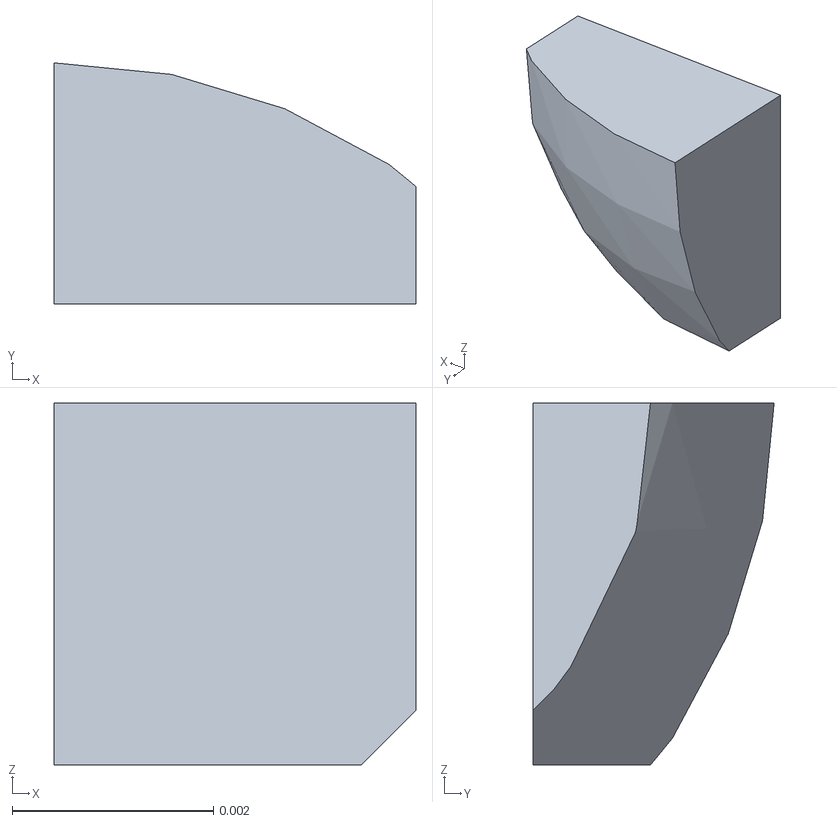
[picture p40: CAD file, 2026-10-03]
prototype/portrait_print_v1/assets/collision_0971.obj
0.0036 x 0.0024 x 0.0036
