meganetaaan/microduck-stackchan/prototype/portrait_print_v1/stl/body_cage_mm.stl

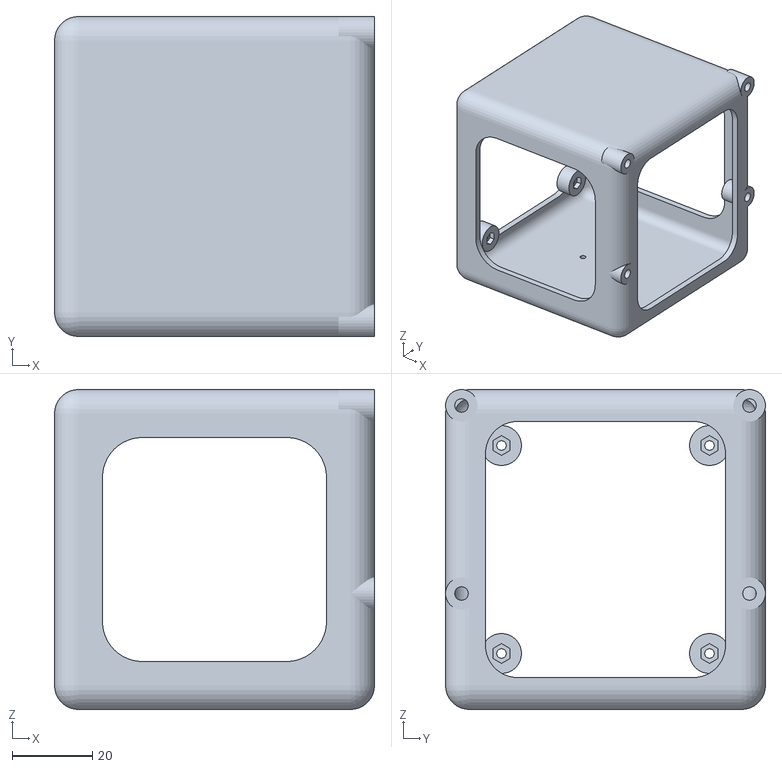
[picture p41: CAD file, 2026-10-03]
prototype/portrait_print_v1/stl/body_cage_mm.stl
80.0 x 80.0 x 80.0
