meganetaaan/microduck-stackchan/prototype/portrait_print_v1/stl_print_oriented/central_mount_print_mm.stl

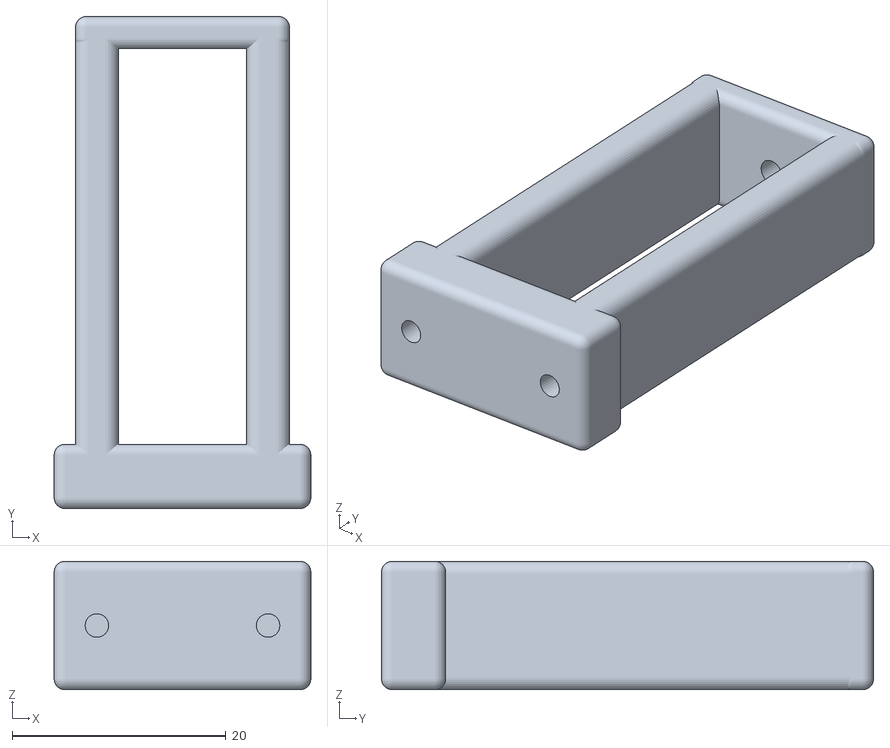
[picture p42: CAD file, 2026-10-03]
prototype/portrait_print_v1/stl_print_oriented/central_mount_print_mm.stl
24.0 x 46.0 x 12.0
