meganetaaan/microduck-stackchan/prototype/rounded/assets/collision_321.obj

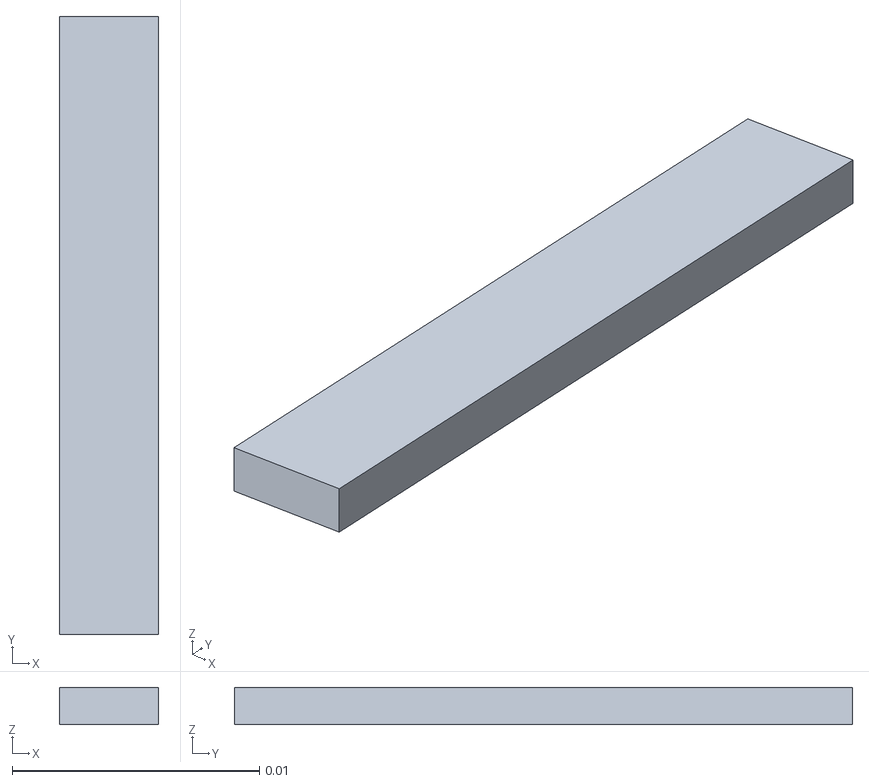
[picture p43: CAD file, 2026-10-03]
prototype/rounded/assets/collision_321.obj
0.004 x 0.025 x 0.0015
