meganetaaan/microduck-stackchan/design/arms/Chunky_Flap_Arm_Concepts_v1/assets/A_slim_flap_stowed_R_vertical_hinge.obj

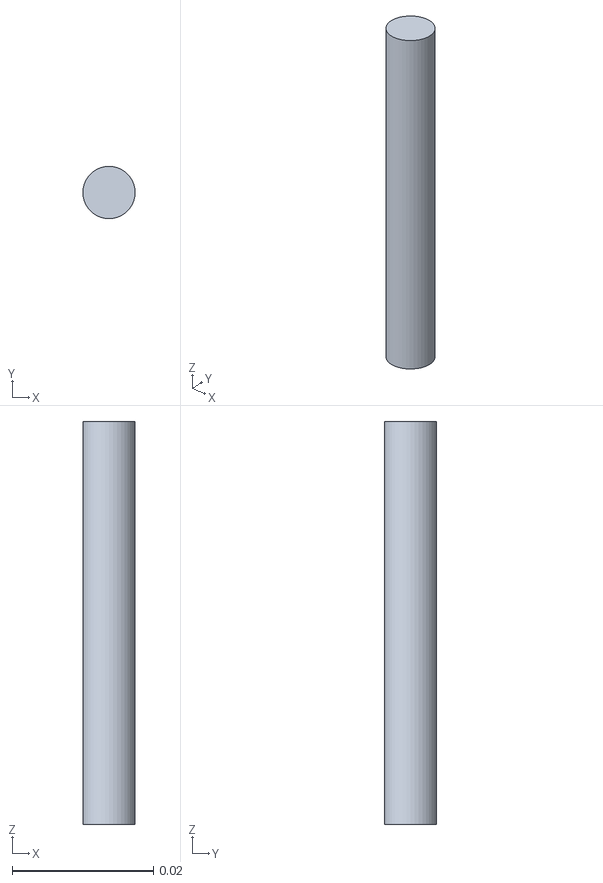
[picture p44: CAD file, 2026-10-03]
design/arms/Chunky_Flap_Arm_Concepts_v1/assets/A_slim_flap_stowed_R_vertical_hinge.obj
0.0074 x 0.0074 x 0.057
