meganetaaan/microduck-stackchan/design/arms/MicroDuck_Stackchan_Arm_Concepts_v1/assets/04_flap_display_R_orange_edge.obj

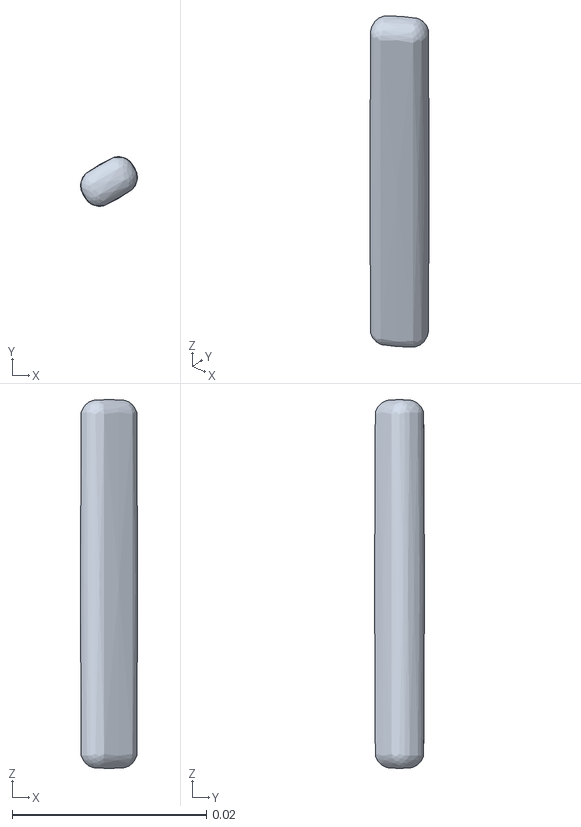
[picture p45: CAD file, 2026-10-03]
design/arms/MicroDuck_Stackchan_Arm_Concepts_v1/assets/04_flap_display_R_orange_edge.obj
0.00588 x 0.00514 x 0.038
