meganetaaan/microduck-stackchan/prototype/assembly_uart/assets/cube_uart_body_cage_0394.obj

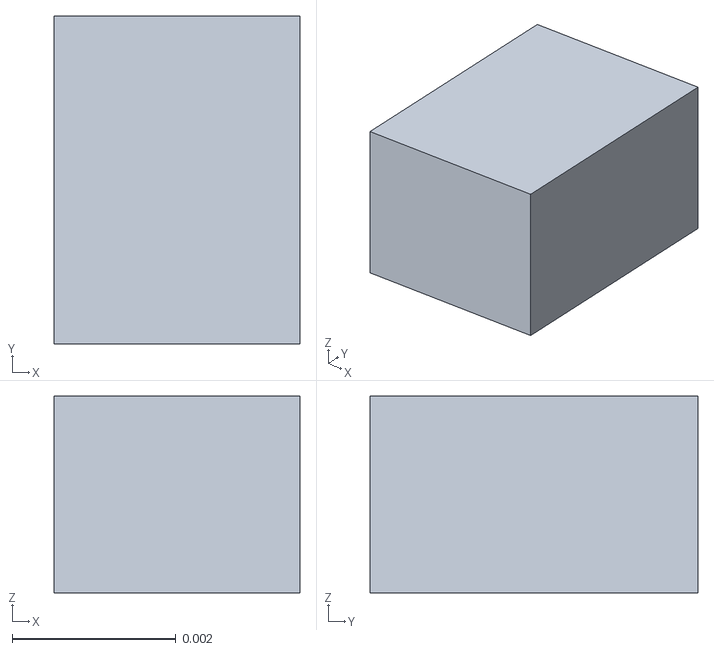
[picture p46: CAD file, 2026-10-03]
prototype/assembly_uart/assets/cube_uart_body_cage_0394.obj
0.003 x 0.004 x 0.0024
