meganetaaan/microduck-stackchan/prototype/assembly_uart/stl/central_mount_mm.stl

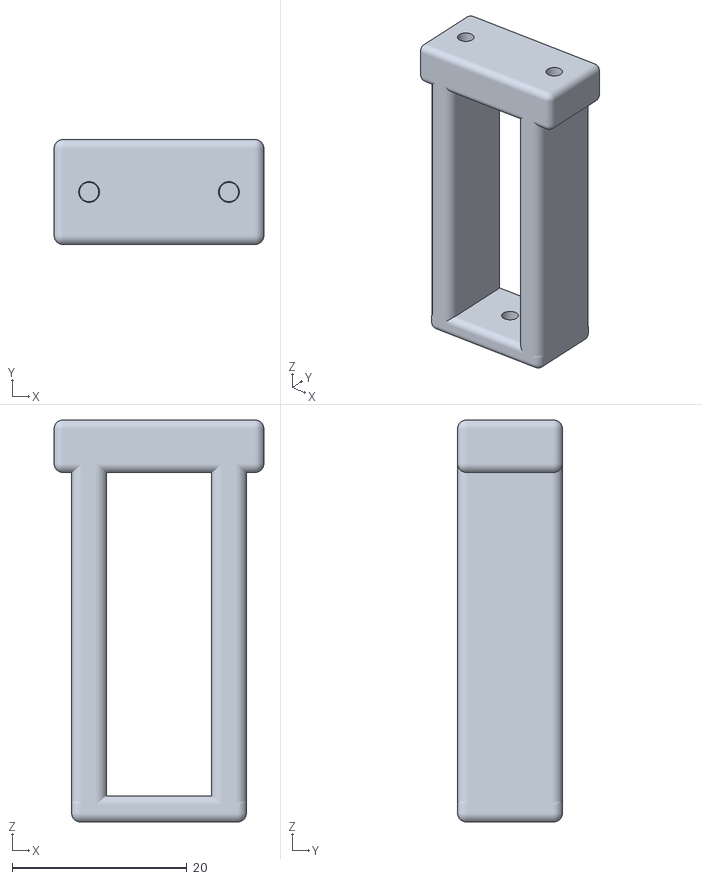
[picture p47: CAD file, 2026-10-03]
prototype/assembly_uart/stl/central_mount_mm.stl
24.0 x 12.0 x 46.0
