meganetaaan/microduck-stackchan/prototype/assembly_uart/stl_print_oriented/body_cage_print_mm.stl

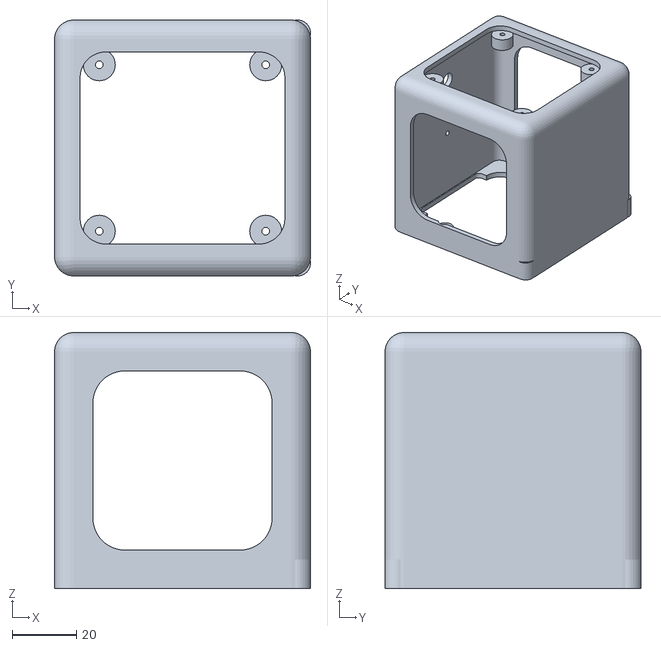
[picture p48: CAD file, 2026-10-03]
prototype/assembly_uart/stl_print_oriented/body_cage_print_mm.stl
80.0 x 80.0 x 80.0
