meganetaaan/microduck-stackchan/prototype/rounded/assets/collision_135.obj

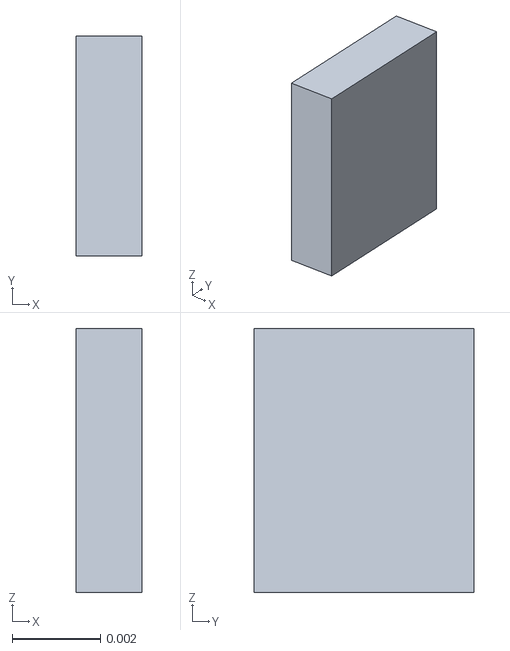
[picture p50: CAD file, 2026-10-03]
prototype/rounded/assets/collision_135.obj
0.0015 x 0.005 x 0.006
