meganetaaan/microduck-stackchan/design/arms/Chunky_Flap_Arm_Concepts_v1/assets/B_rounded_armor_display_L_orange_tip.obj

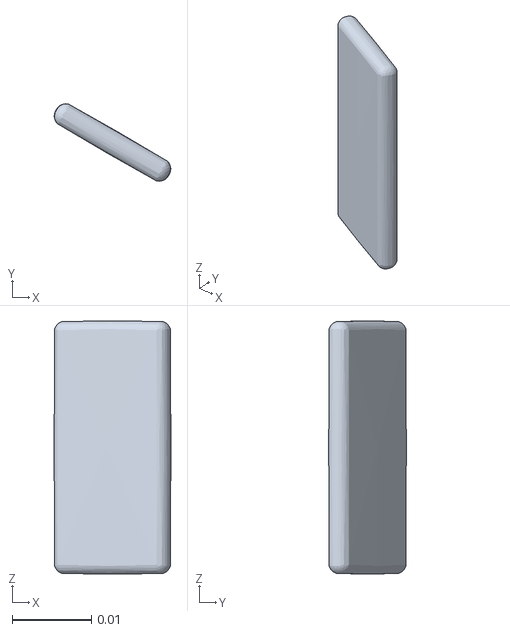
[picture p51: CAD file, 2026-10-03]
design/arms/Chunky_Flap_Arm_Concepts_v1/assets/B_rounded_armor_display_L_orange_tip.obj
0.0148 x 0.00982 x 0.032
