meganetaaan/microduck-stackchan/design/arms/MicroDuck_Stackchan_Arm_Concepts_v1/assets/base_013_ankle_right.stl

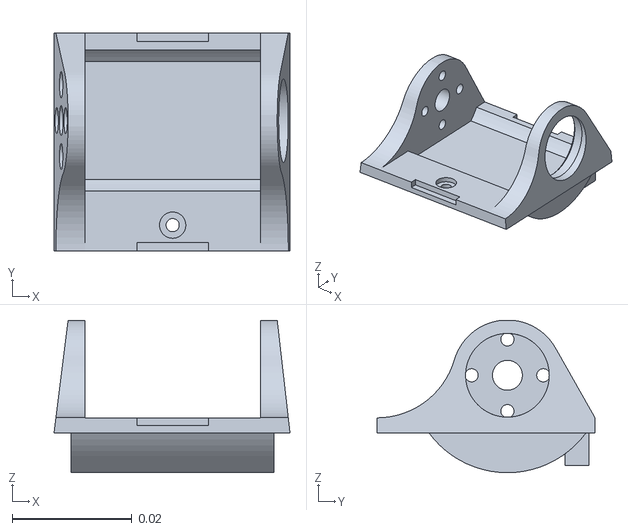
[picture p52: CAD file, 2026-10-03]
design/arms/MicroDuck_Stackchan_Arm_Concepts_v1/assets/base_013_ankle_right.stl
0.0395 x 0.0365 x 0.0255
