meganetaaan/microduck-stackchan/prototype/assembly_uart/assets/cube_uart_electronics_carrier_0073.obj

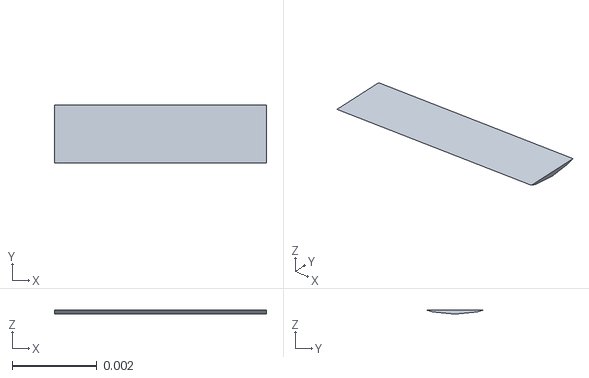
[picture p53: CAD file, 2026-10-03]
prototype/assembly_uart/assets/cube_uart_electronics_carrier_0073.obj
0.005 x 0.00137 x 0.0001
