meganetaaan/microduck-stackchan/prototype/portrait_print/assets/collision_0648.obj

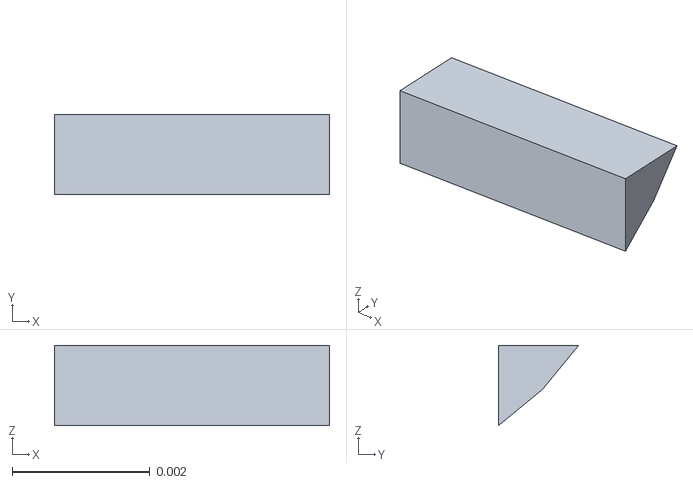
[picture p54: CAD file, 2026-10-03]
prototype/portrait_print/assets/collision_0648.obj
0.004 x 0.00117 x 0.00117
