meganetaaan/microduck-stackchan/prototype/portrait_print_v1/assets/collision_0412.obj

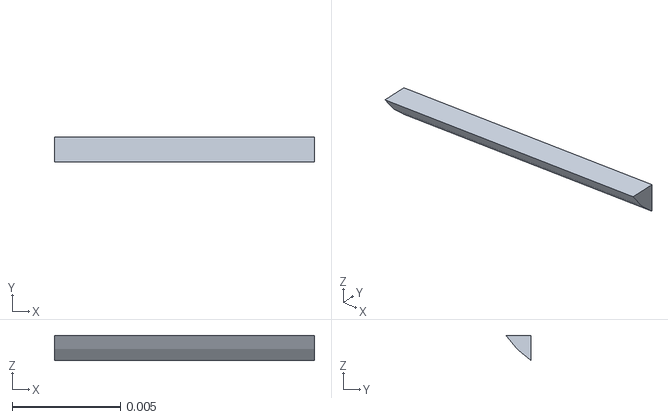
[picture p55: CAD file, 2026-10-03]
prototype/portrait_print_v1/assets/collision_0412.obj
0.012 x 0.00117 x 0.00117
