meganetaaan/microduck-stackchan/prototype/rounded/assets/collision_611.obj

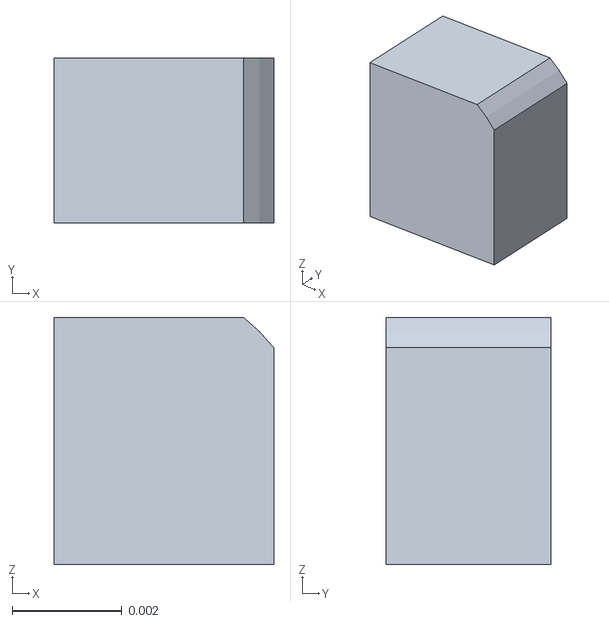
[picture p56: CAD file, 2026-10-03]
prototype/rounded/assets/collision_611.obj
0.004 x 0.003 x 0.0045
