meganetaaan/microduck-stackchan/design/arms/Chunky_Flap_Arm_Concepts_v1/assets/C_chunky_armor_stowed_L_orange_end_cap.obj

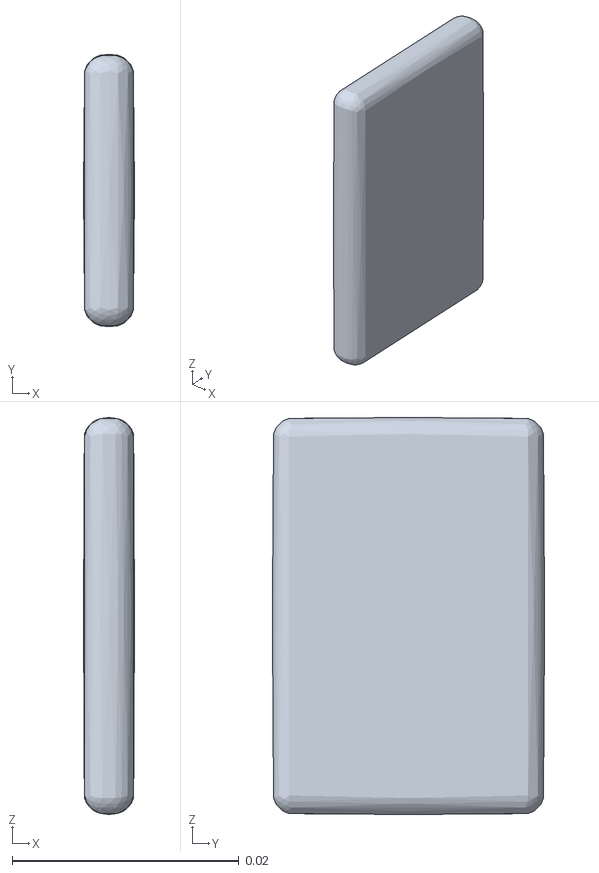
[picture p57: CAD file, 2026-10-03]
design/arms/Chunky_Flap_Arm_Concepts_v1/assets/C_chunky_armor_stowed_L_orange_end_cap.obj
0.0045 x 0.024 x 0.035
