meganetaaan/microduck-stackchan/design/arms/MicroDuck_Stackchan_Arm_Concepts_v1/assets/base_003_foot_right.stl

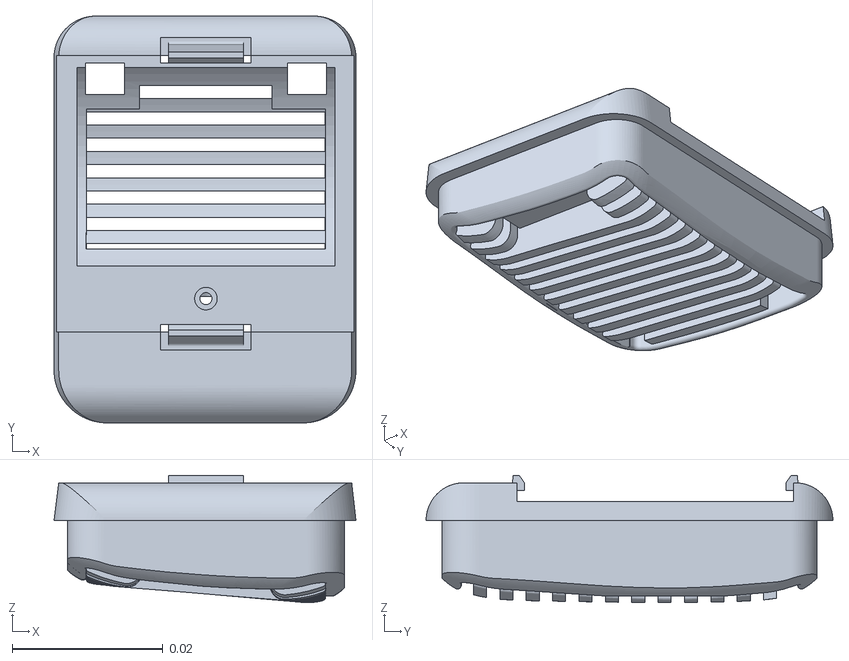
[picture p58: CAD file, 2026-10-03]
design/arms/MicroDuck_Stackchan_Arm_Concepts_v1/assets/base_003_foot_right.stl
0.0401 x 0.054 x 0.0169
