meganetaaan/microduck-stackchan/prototype/assembly_uart/assets/cube_uart_electronics_carrier_0219.obj

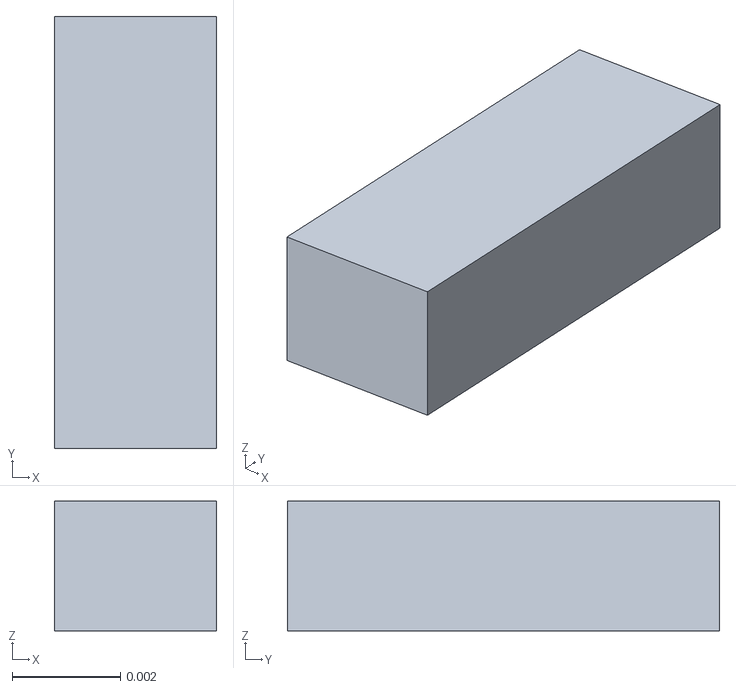
[picture p59: CAD file, 2026-10-03]
prototype/assembly_uart/assets/cube_uart_electronics_carrier_0219.obj
0.003 x 0.008 x 0.0024
