meganetaaan/microduck-stackchan/prototype/portrait_print/assets/collision_0727.obj

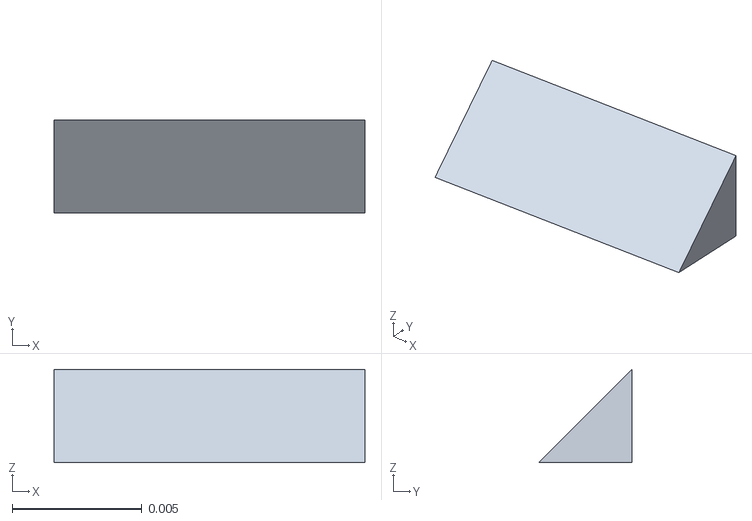
[picture p60: CAD file, 2026-10-03]
prototype/portrait_print/assets/collision_0727.obj
0.012 x 0.0036 x 0.0036
