meganetaaan/microduck-stackchan/prototype/portrait_print_v1/assets/collision_0460.obj

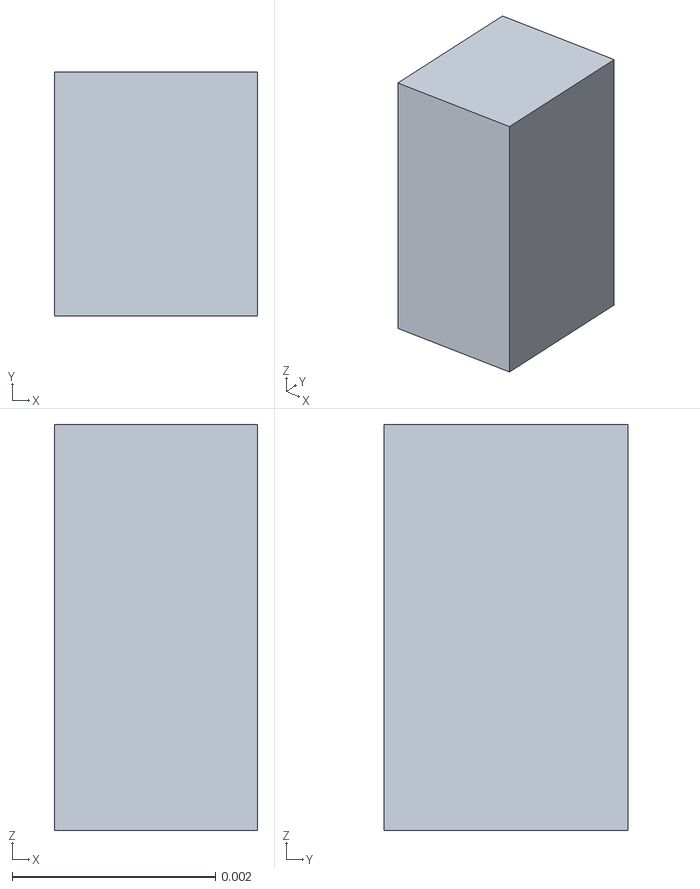
[picture p61: CAD file, 2026-10-03]
prototype/portrait_print_v1/assets/collision_0460.obj
0.002 x 0.0024 x 0.004
