meganetaaan/microduck-stackchan/prototype/rounded/assets/collision_302.obj

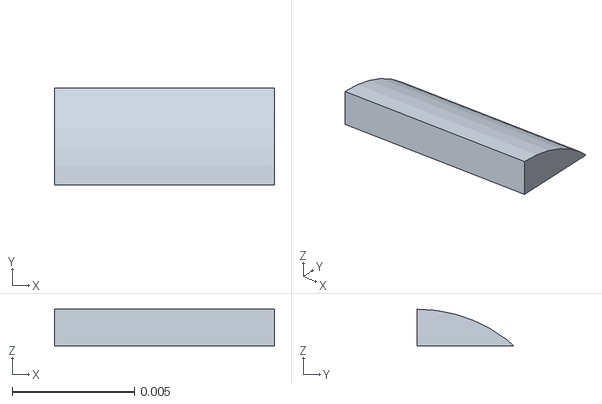
[picture p62: CAD file, 2026-10-03]
prototype/rounded/assets/collision_302.obj
0.009 x 0.00395 x 0.0015
