meganetaaan/microduck-stackchan/design/arms/Chunky_Flap_Arm_Concepts_v1/assets/base_1655_robot_power_pigtail.obj

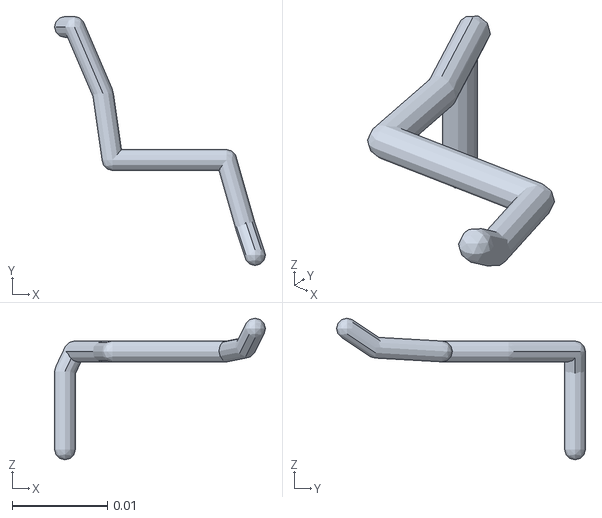
[picture p63: CAD file, 2026-10-03]
design/arms/Chunky_Flap_Arm_Concepts_v1/assets/base_1655_robot_power_pigtail.obj
0.0222 x 0.0262 x 0.0149
