meganetaaan/microduck-stackchan/prototype/assembly_uart/assets/cube_uart_central_mount_0034.obj

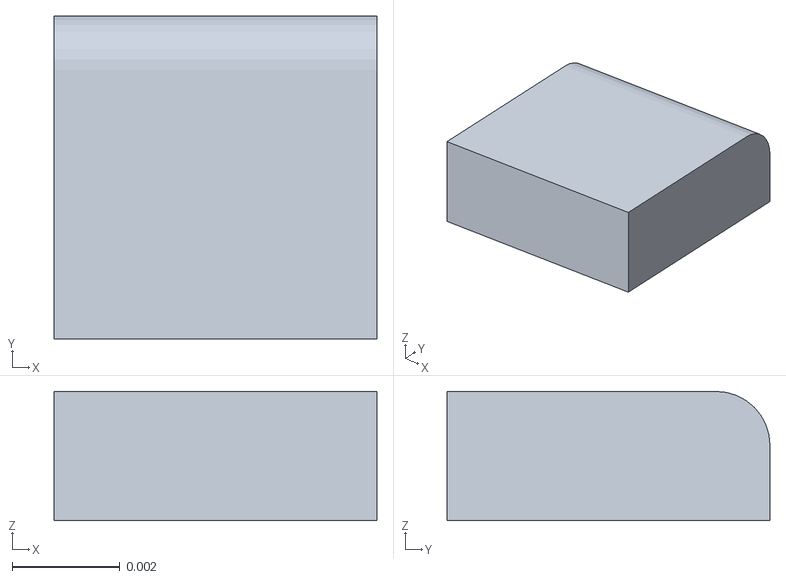
[picture p64: CAD file, 2026-10-03]
prototype/assembly_uart/assets/cube_uart_central_mount_0034.obj
0.006 x 0.006 x 0.0024
