meganetaaan/microduck-stackchan/prototype/assembly_uart/stl/electronics_carrier_mm.stl

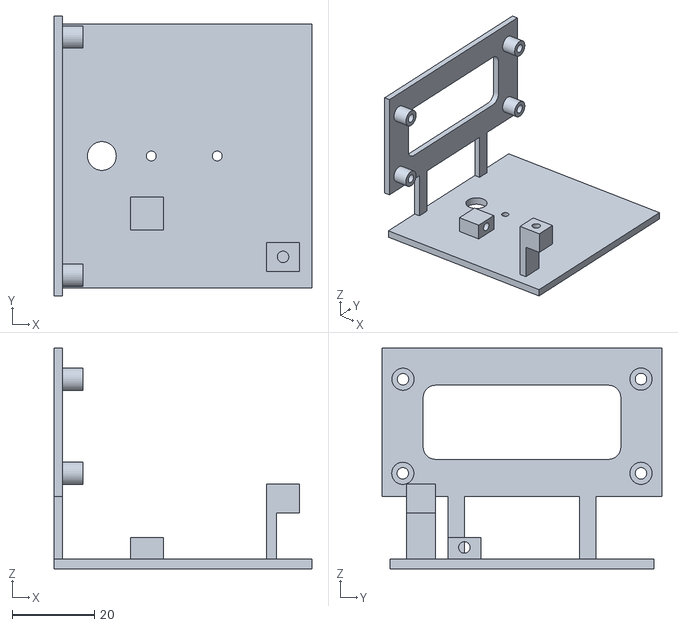
[picture p65: CAD file, 2026-10-03]
prototype/assembly_uart/stl/electronics_carrier_mm.stl
62.6 x 68.0 x 53.6
