meganetaaan/microduck-stackchan/prototype/portrait_print/assets/collision_0710.obj

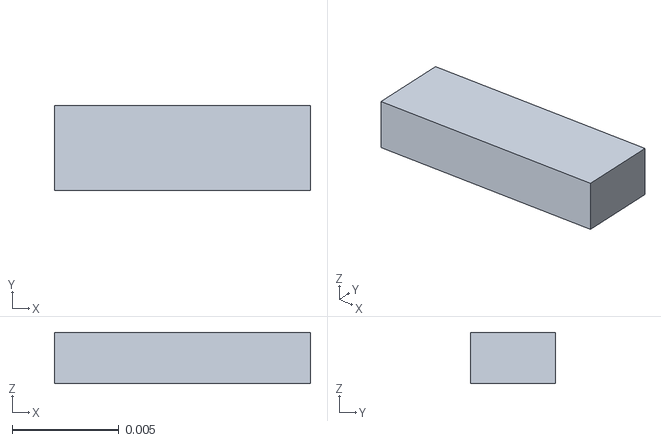
[picture p66: CAD file, 2026-10-03]
prototype/portrait_print/assets/collision_0710.obj
0.012 x 0.004 x 0.0024
