meganetaaan/microduck-stackchan/prototype/portrait_print_v1/assets/collision_0088.obj

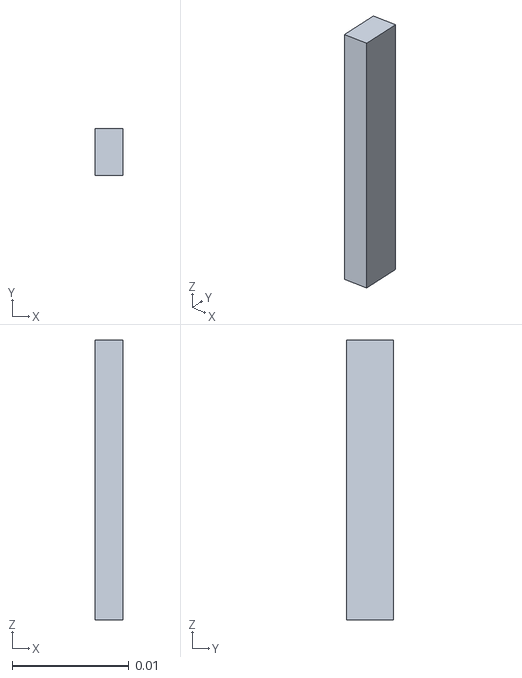
[picture p67: CAD file, 2026-10-03]
prototype/portrait_print_v1/assets/collision_0088.obj
0.0024 x 0.004 x 0.024
