meganetaaan/microduck-stackchan/prototype/rounded/assets/collision_149.obj

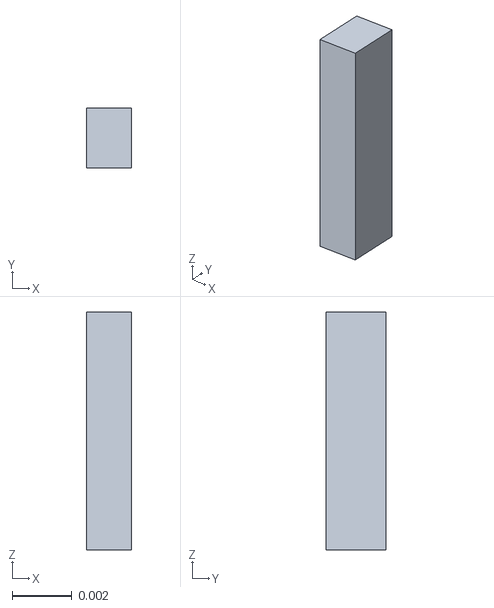
[picture p68: CAD file, 2026-10-03]
prototype/rounded/assets/collision_149.obj
0.0015 x 0.002 x 0.008
