meganetaaan/microduck-stackchan/design/arms/Chunky_Flap_Arm_Concepts_v1/assets/B_rounded_armor_stowed_R_orange_tip.obj

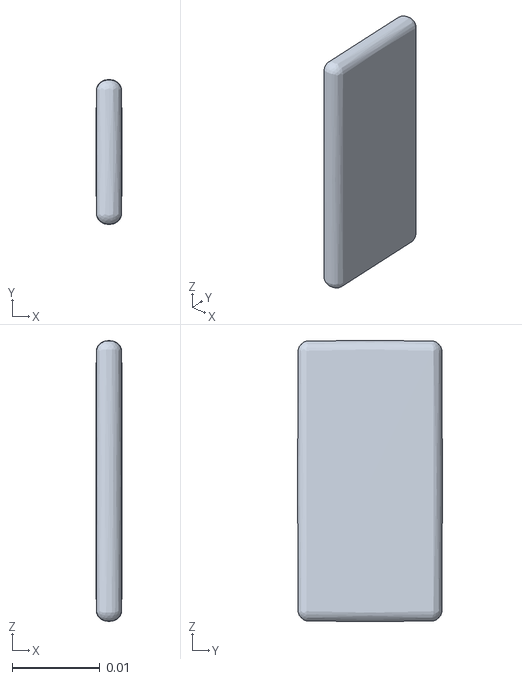
[picture p69: CAD file, 2026-10-03]
design/arms/Chunky_Flap_Arm_Concepts_v1/assets/B_rounded_armor_stowed_R_orange_tip.obj
0.003 x 0.0165 x 0.032
