meganetaaan/microduck-stackchan/design/arms/MicroDuck_Stackchan_Arm_Concepts_v1/assets/04_flap_stowed_R_side_flap.obj

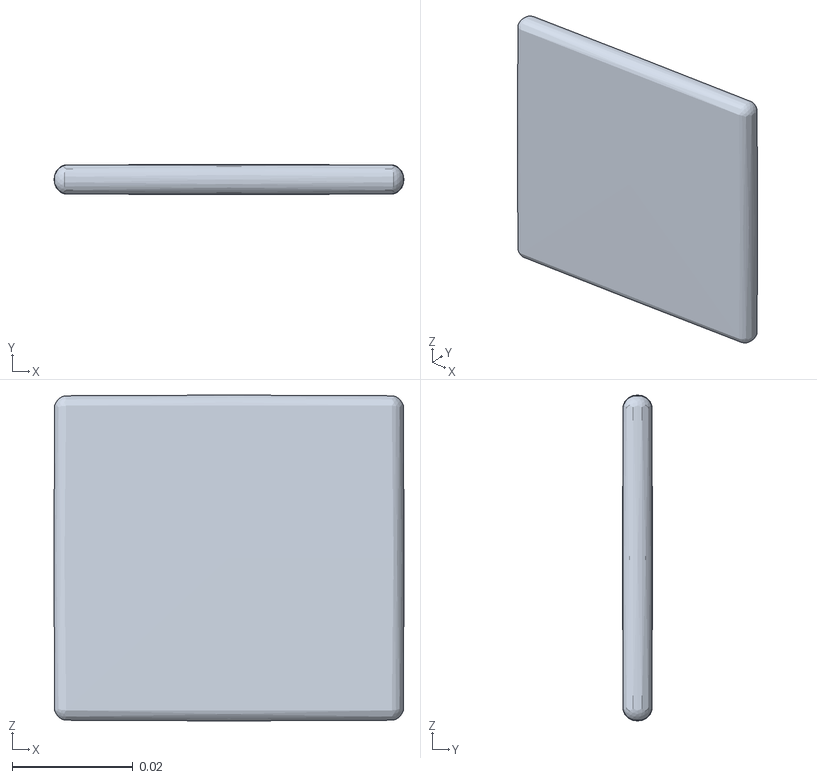
[picture p70: CAD file, 2026-10-03]
design/arms/MicroDuck_Stackchan_Arm_Concepts_v1/assets/04_flap_stowed_R_side_flap.obj
0.058 x 0.005 x 0.054
