meganetaaan/microduck-stackchan/prototype/assembly_uart/assets/cube_uart_body_cage_0690.obj

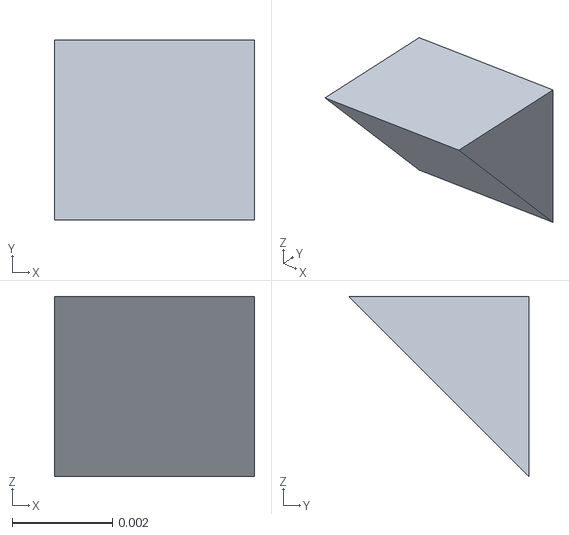
[picture p71: CAD file, 2026-10-03]
prototype/assembly_uart/assets/cube_uart_body_cage_0690.obj
0.004 x 0.0036 x 0.0036
