meganetaaan/microduck-stackchan/prototype/portrait_print/assets/collision_0758.obj

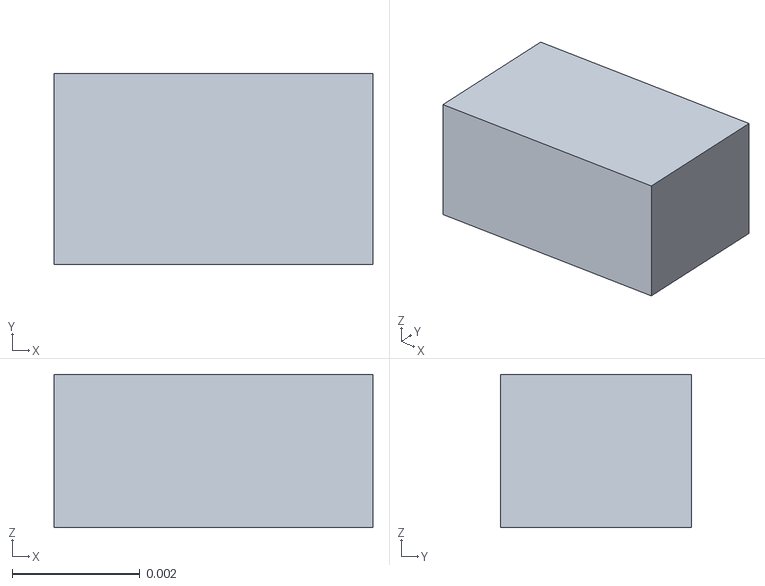
[picture p72: CAD file, 2026-10-03]
prototype/portrait_print/assets/collision_0758.obj
0.005 x 0.003 x 0.0024
