meganetaaan/microduck-stackchan/prototype/portrait_print_v1/assets/collision_0129.obj

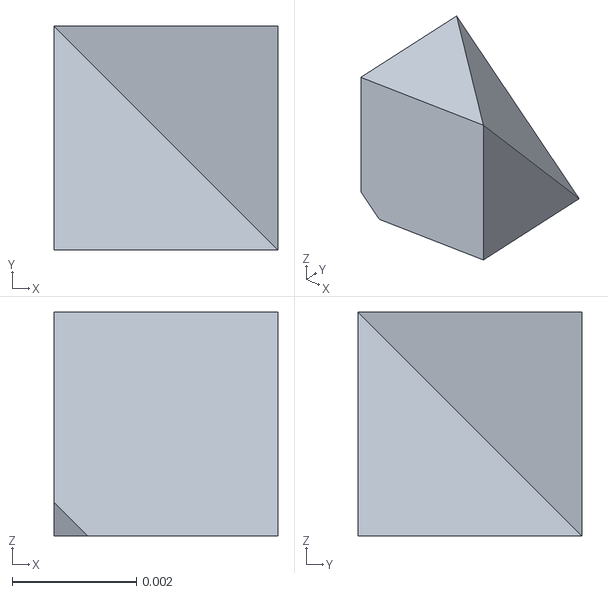
[picture p73: CAD file, 2026-10-03]
prototype/portrait_print_v1/assets/collision_0129.obj
0.0036 x 0.0036 x 0.0036
