meganetaaan/microduck-stackchan/prototype/rounded/assets/collision_561.obj

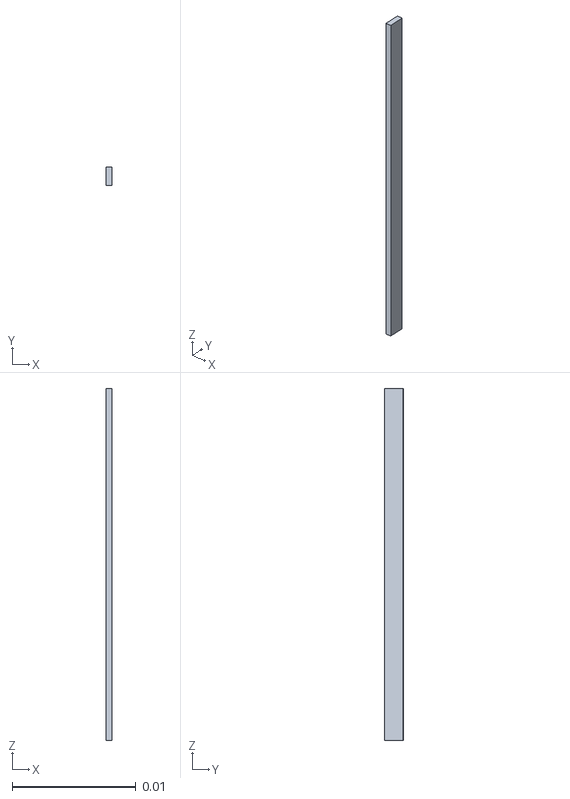
[picture p74: CAD file, 2026-10-03]
prototype/rounded/assets/collision_561.obj
0.0005 x 0.0015 x 0.0285
