meganetaaan/microduck-stackchan/design/arms/Chunky_Flap_Arm_Concepts_v1/assets/base_1651_tab5_J7_plug_proxy.obj

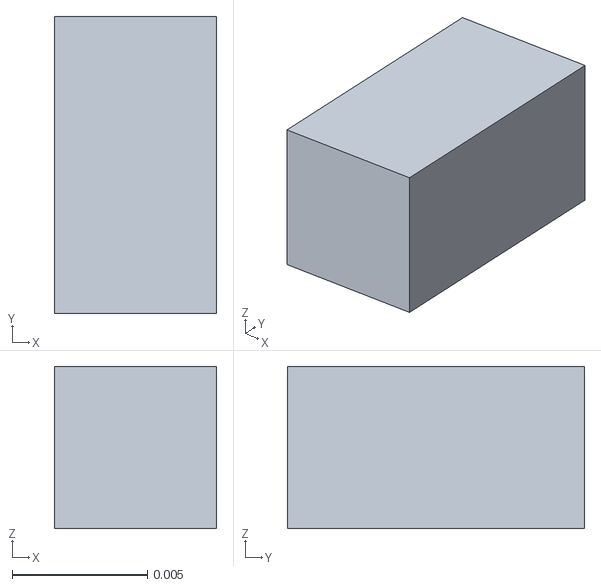
[picture p75: CAD file, 2026-10-03]
design/arms/Chunky_Flap_Arm_Concepts_v1/assets/base_1651_tab5_J7_plug_proxy.obj
0.006 x 0.011 x 0.006
