meganetaaan/microduck-stackchan/prototype/portrait_print/assets/collision_0578.obj

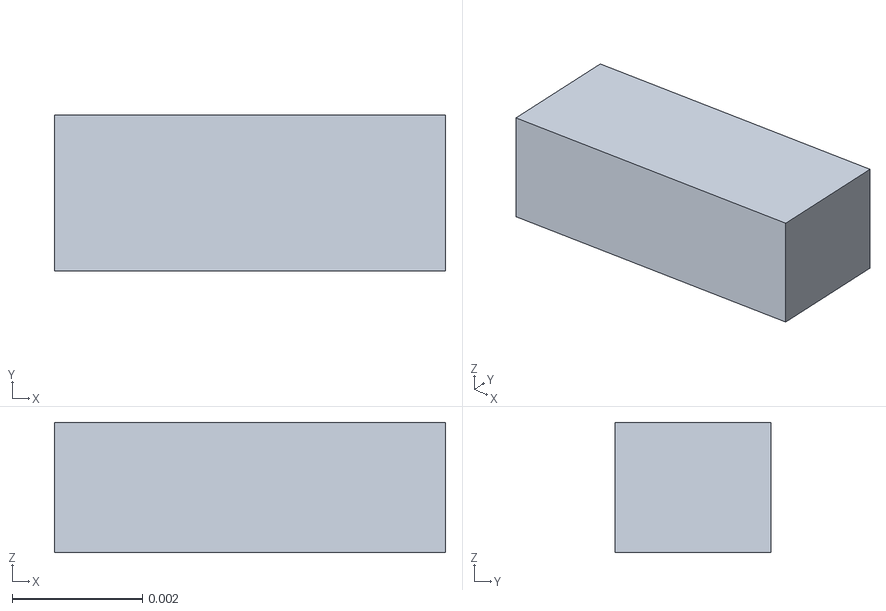
[picture p76: CAD file, 2026-10-03]
prototype/portrait_print/assets/collision_0578.obj
0.006 x 0.0024 x 0.002
