meganetaaan/microduck-stackchan/design/arms/Chunky_Flap_Arm_Concepts_v1/assets/base_1668_tab5_power_loom.obj

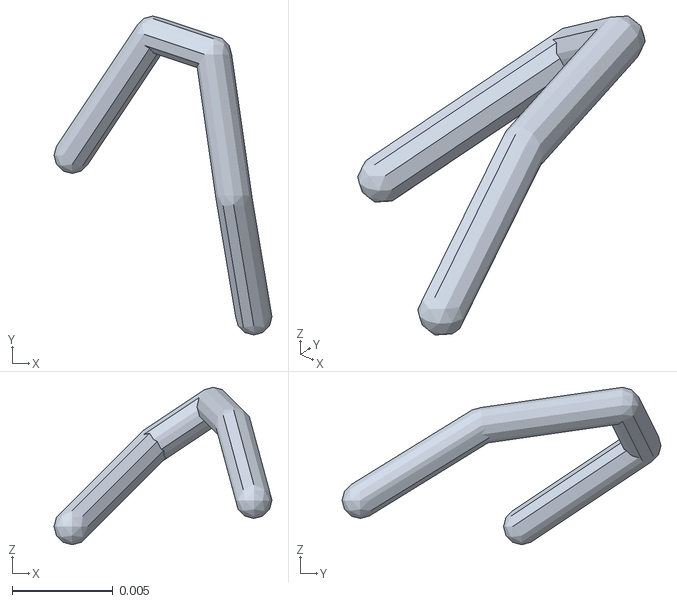
[picture p79: CAD file, 2026-10-03]
design/arms/Chunky_Flap_Arm_Concepts_v1/assets/base_1668_tab5_power_loom.obj
0.0108 x 0.0158 x 0.0078
