meganetaaan/microduck-stackchan/design/arms/MicroDuck_Stackchan_Arm_Concepts_v1/assets/03_mitten_stowed_L_cap_center.obj

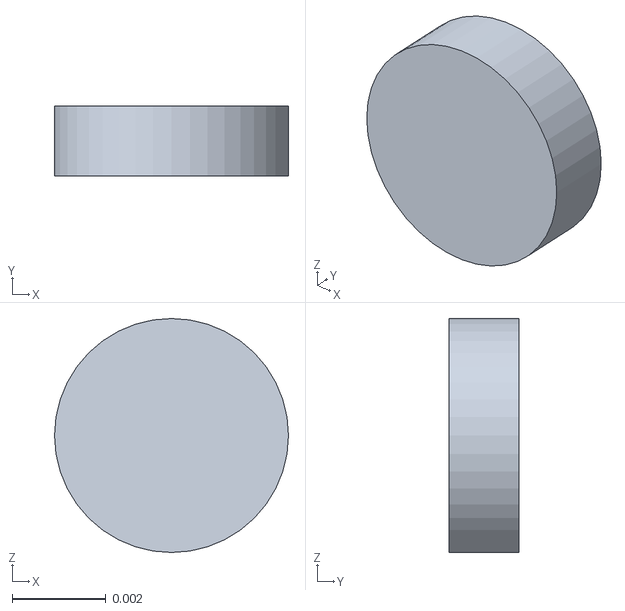
[picture p80: CAD file, 2026-10-03]
design/arms/MicroDuck_Stackchan_Arm_Concepts_v1/assets/03_mitten_stowed_L_cap_center.obj
0.005 x 0.0015 x 0.005
