meganetaaan/microduck-stackchan/prototype/assembly_uart/assets/cube_uart_body_cage_1020.obj

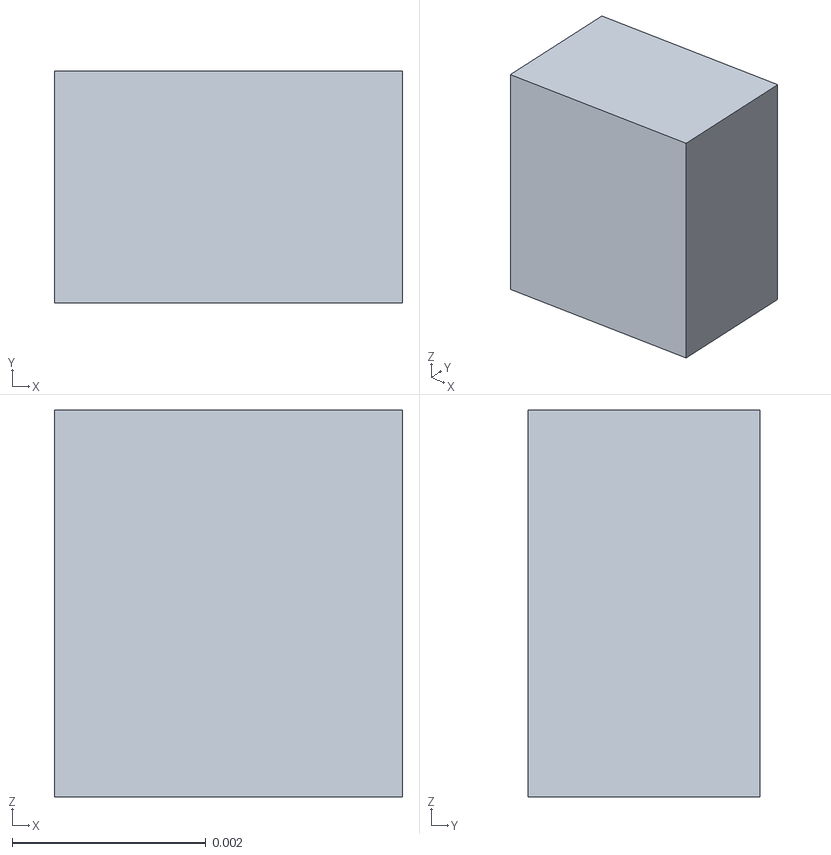
[picture p81: CAD file, 2026-10-03]
prototype/assembly_uart/assets/cube_uart_body_cage_1020.obj
0.0036 x 0.0024 x 0.004
