meganetaaan/microduck-stackchan/prototype/portrait_print/assets/collision_0161.obj

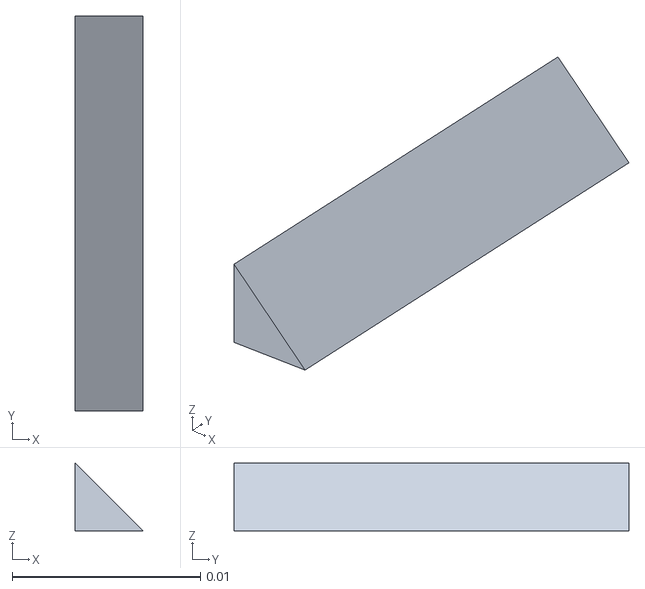
[picture p82: CAD file, 2026-10-03]
prototype/portrait_print/assets/collision_0161.obj
0.0036 x 0.021 x 0.0036
