meganetaaan/microduck-stackchan/prototype/portrait_print_v1/assets/collision_0983.obj

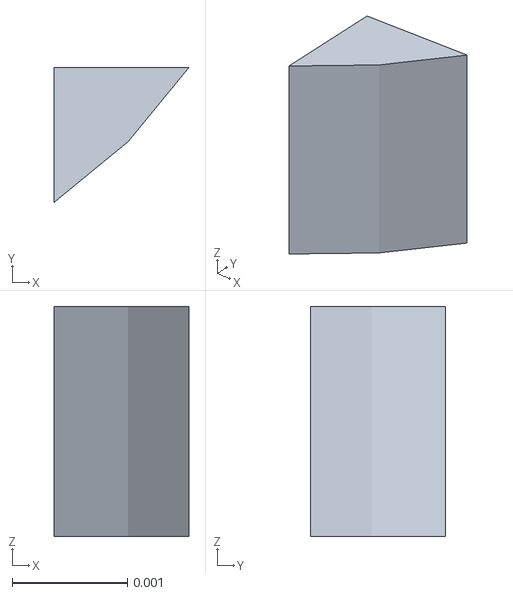
[picture p83: CAD file, 2026-10-03]
prototype/portrait_print_v1/assets/collision_0983.obj
0.00117 x 0.00117 x 0.002
