meganetaaan/microduck-stackchan/design/arms/Chunky_Flap_Arm_Concepts_v1/assets/C_chunky_armor_display_R_upper_armor_rail_-1.obj

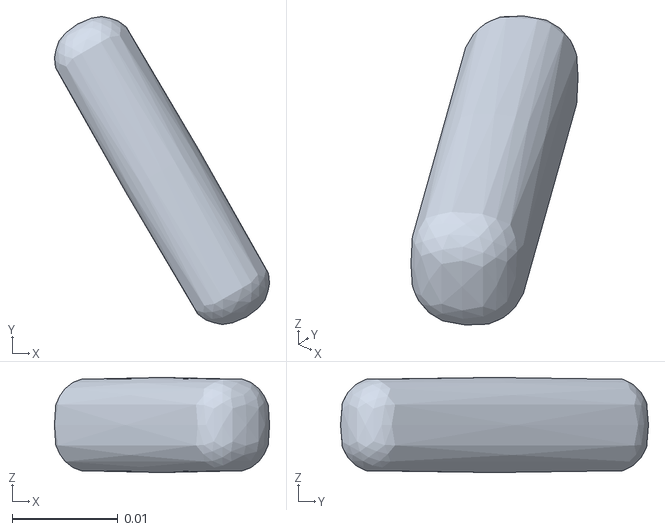
[picture p85: CAD file, 2026-10-03]
design/arms/Chunky_Flap_Arm_Concepts_v1/assets/C_chunky_armor_display_R_upper_armor_rail_-1.obj
0.0204 x 0.0291 x 0.009
