meganetaaan/microduck-stackchan/design/arms/MicroDuck_Stackchan_Arm_Concepts_v1/assets/02_elbow_stowed_L_forearm.obj

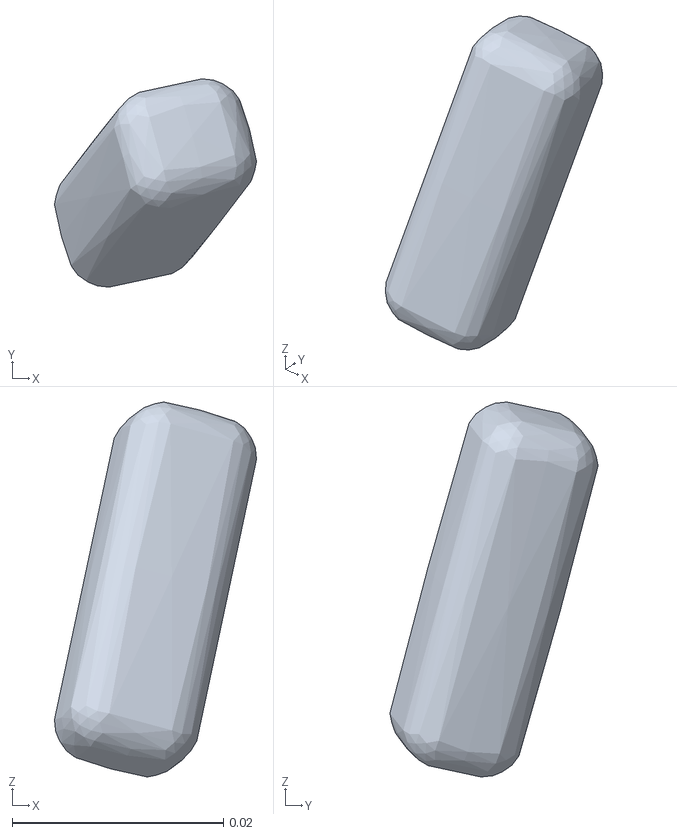
[picture p86: CAD file, 2026-10-03]
design/arms/MicroDuck_Stackchan_Arm_Concepts_v1/assets/02_elbow_stowed_L_forearm.obj
0.0191 x 0.0197 x 0.0355
