meganetaaan/microduck-stackchan/prototype/assembly_uart/assets/cube_uart_body_cage_1041.obj

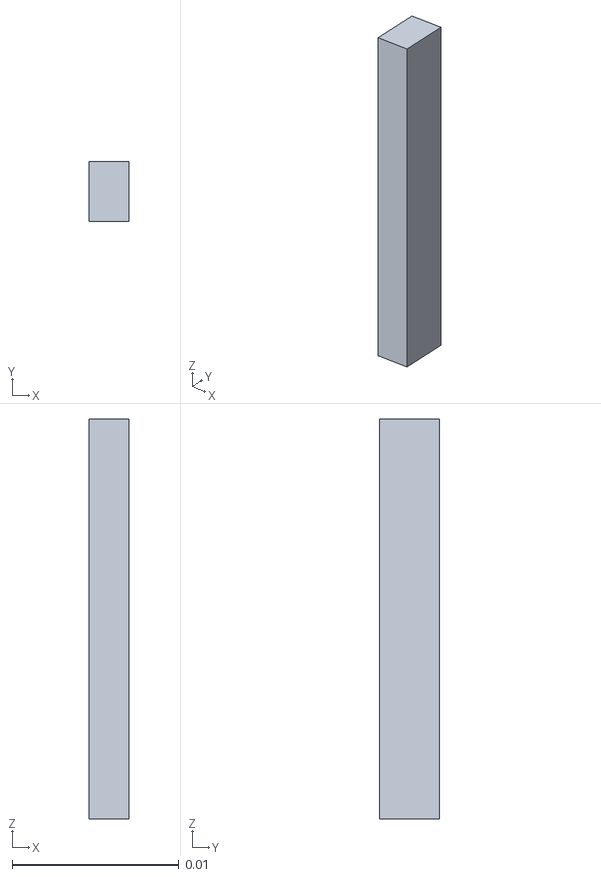
[picture p87: CAD file, 2026-10-03]
prototype/assembly_uart/assets/cube_uart_body_cage_1041.obj
0.0024 x 0.0036 x 0.024
