meganetaaan/microduck-stackchan/prototype/portrait_print_v1/assets/collision_0657.obj

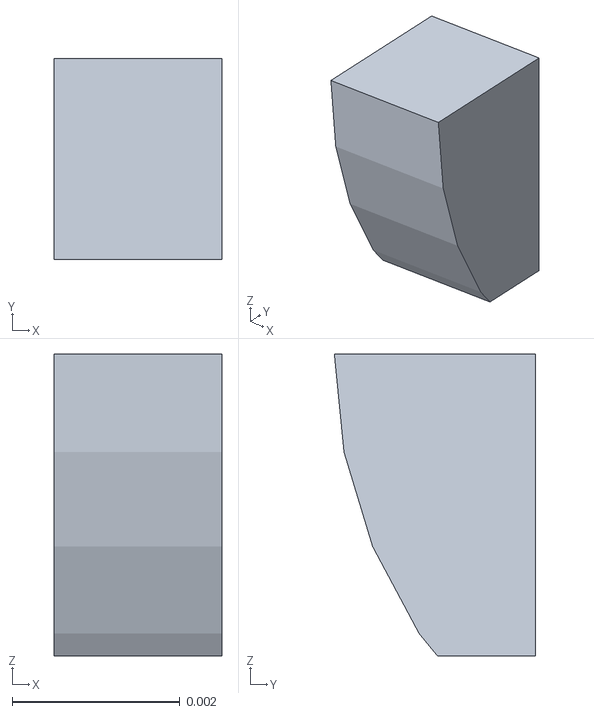
[picture p88: CAD file, 2026-10-03]
prototype/portrait_print_v1/assets/collision_0657.obj
0.002 x 0.0024 x 0.0036
