meganetaaan/microduck-stackchan/prototype/rounded/assets/collision_432.obj

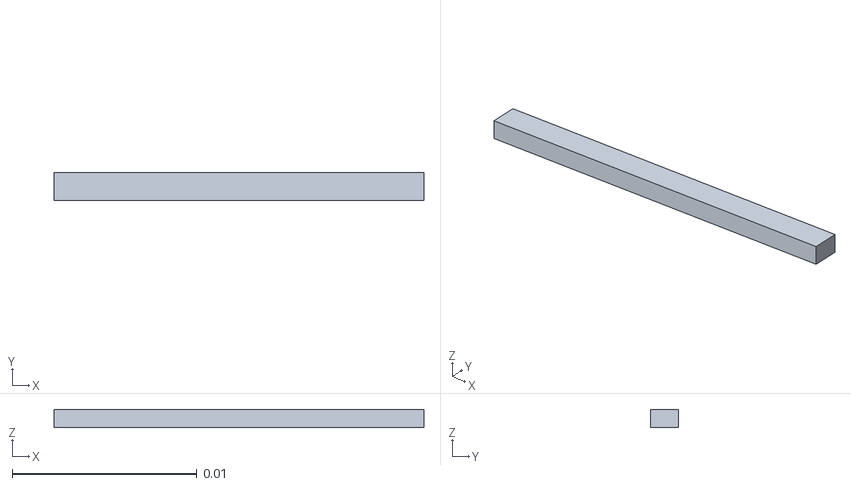
[picture p89: CAD file, 2026-10-03]
prototype/rounded/assets/collision_432.obj
0.02 x 0.0015 x 0.001
