meganetaaan/microduck-stackchan/design/arms/MicroDuck_Stackchan_Arm_Concepts_v1/assets/03_mitten_display_L_orange_cuff.obj

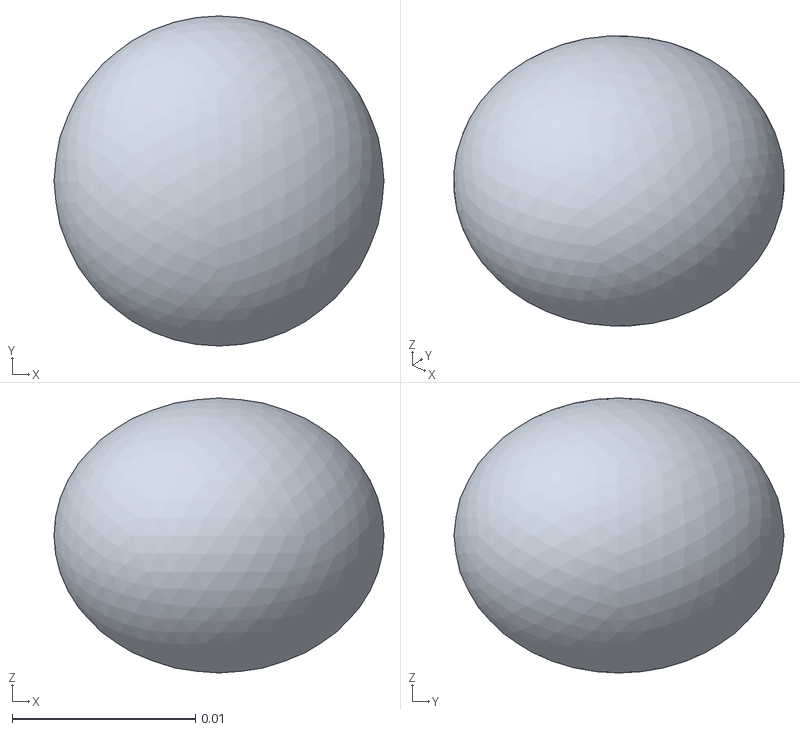
[picture p90: CAD file, 2026-10-03]
design/arms/MicroDuck_Stackchan_Arm_Concepts_v1/assets/03_mitten_display_L_orange_cuff.obj
0.018 x 0.018 x 0.015
