meganetaaan/microduck-stackchan/prototype/assembly_uart/assets/cube_uart_body_cage_0261.obj

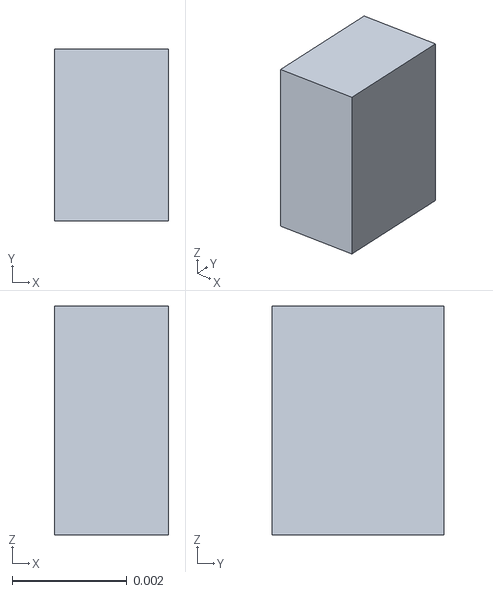
[picture p91: CAD file, 2026-10-03]
prototype/assembly_uart/assets/cube_uart_body_cage_0261.obj
0.002 x 0.003 x 0.004
