meganetaaan/microduck-stackchan/prototype/portrait_print/assets/collision_0712.obj

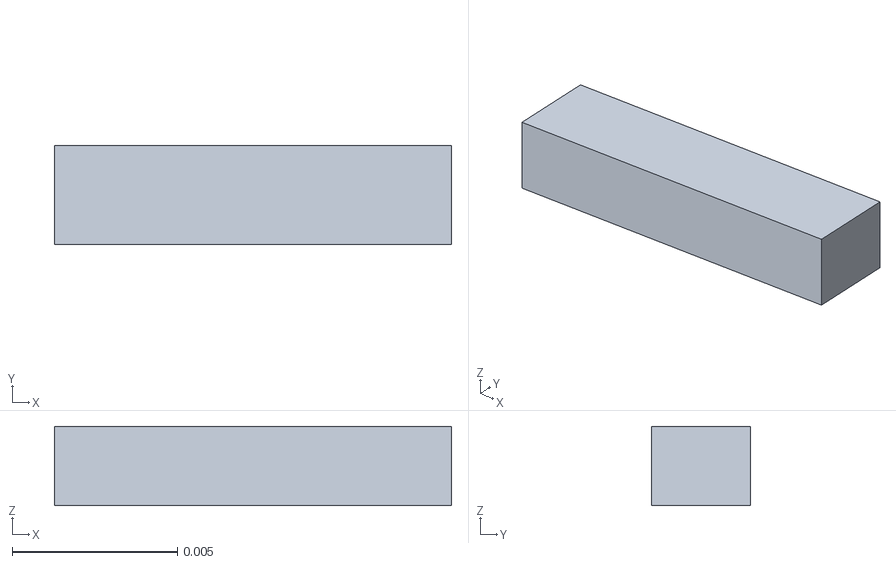
[picture p92: CAD file, 2026-10-03]
prototype/portrait_print/assets/collision_0712.obj
0.012 x 0.003 x 0.0024
