meganetaaan/microduck-stackchan/prototype/portrait_print_v1/assets/collision_1158.obj

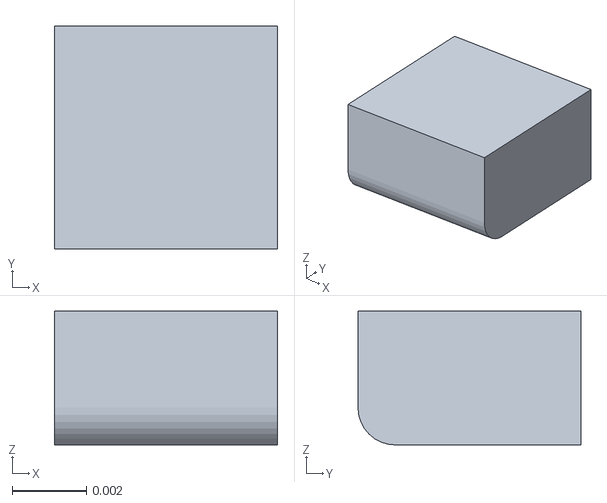
[picture p93: CAD file, 2026-10-03]
prototype/portrait_print_v1/assets/collision_1158.obj
0.006 x 0.006 x 0.0036
