meganetaaan/microduck-stackchan/prototype/rounded/assets/collision_628.obj

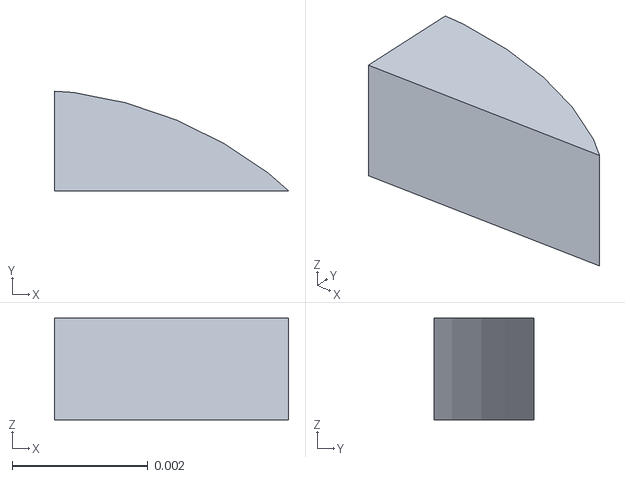
[picture p94: CAD file, 2026-10-03]
prototype/rounded/assets/collision_628.obj
0.00345 x 0.00147 x 0.0015
