meganetaaan/microduck-stackchan/design/arms/Chunky_Flap_Arm_Concepts_v1/assets/C_chunky_armor_display_L_orange_end_cap.obj

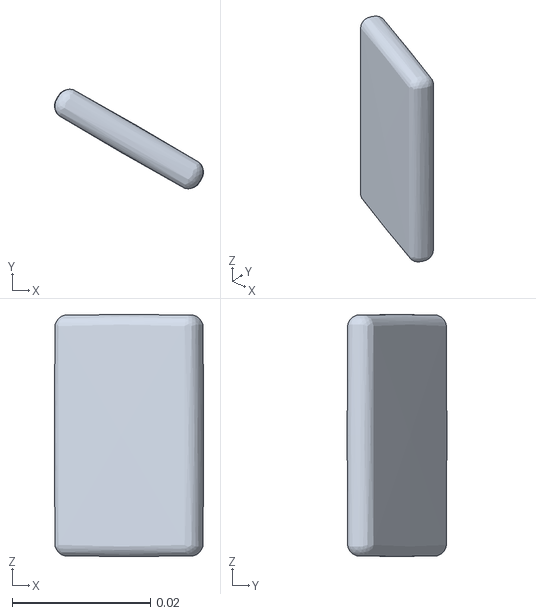
[picture p95: CAD file, 2026-10-03]
design/arms/Chunky_Flap_Arm_Concepts_v1/assets/C_chunky_armor_display_L_orange_end_cap.obj
0.0216 x 0.0144 x 0.035
