meganetaaan/microduck-stackchan/prototype/assembly_uart/assets/cube_uart_electronics_carrier_0112.obj

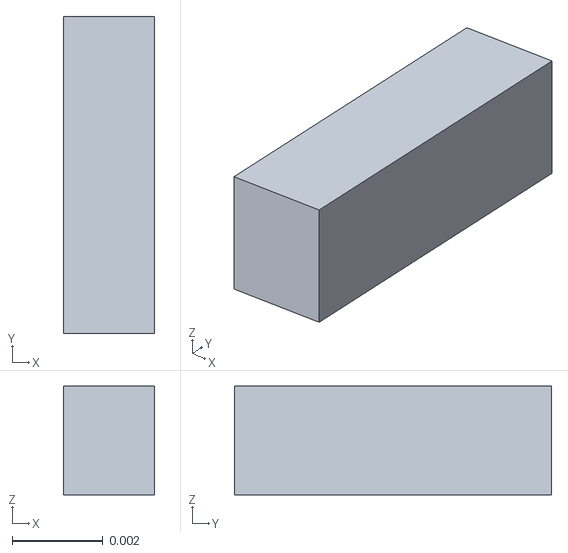
[picture p96: CAD file, 2026-10-03]
prototype/assembly_uart/assets/cube_uart_electronics_carrier_0112.obj
0.002 x 0.007 x 0.0024
