meganetaaan/microduck-stackchan/prototype/portrait_print/assets/collision_1034.obj

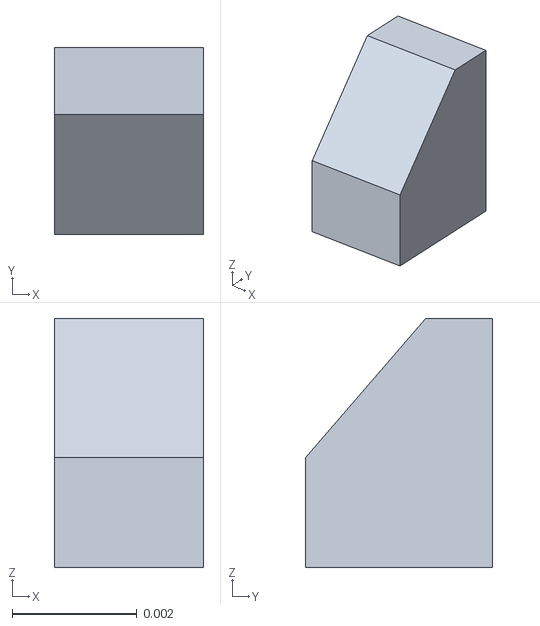
[picture p97: CAD file, 2026-10-03]
prototype/portrait_print/assets/collision_1034.obj
0.0024 x 0.003 x 0.004
