meganetaaan/microduck-stackchan/prototype/portrait_print_v1/assets/collision_0634.obj

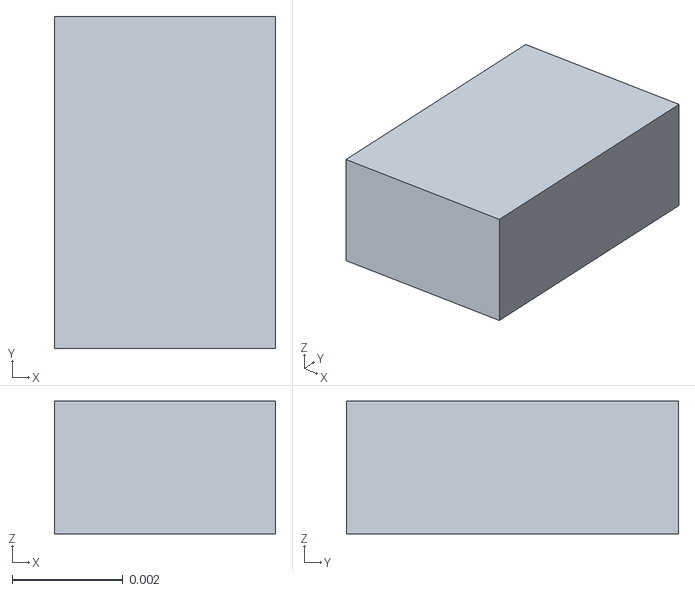
[picture p98: CAD file, 2026-10-03]
prototype/portrait_print_v1/assets/collision_0634.obj
0.004 x 0.006 x 0.0024
