meganetaaan/microduck-stackchan/prototype/rounded/assets/collision_172.obj

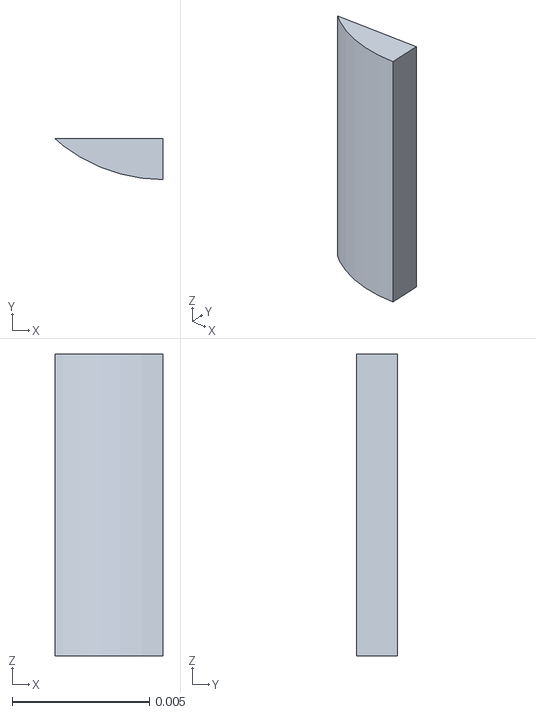
[picture p99: CAD file, 2026-10-03]
prototype/rounded/assets/collision_172.obj
0.00395 x 0.0015 x 0.011
