meganetaaan/microduck-stackchan/design/arms/Chunky_Flap_Arm_Concepts_v1/assets/base_007_upper_leg_left.stl

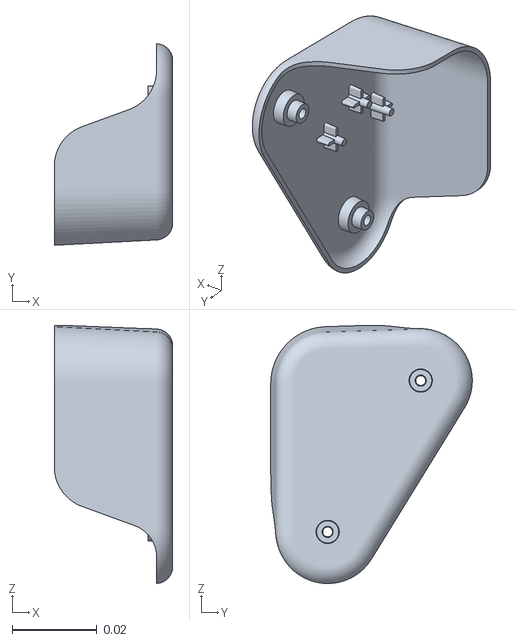
[picture p100: CAD file, 2026-10-03]
design/arms/Chunky_Flap_Arm_Concepts_v1/assets/base_007_upper_leg_left.stl
0.028 x 0.0477 x 0.061
