meganetaaan/microduck-stackchan/design/arms/MicroDuck_Stackchan_Arm_Concepts_v1/assets/01_paddle_stowed_L_paddle.obj

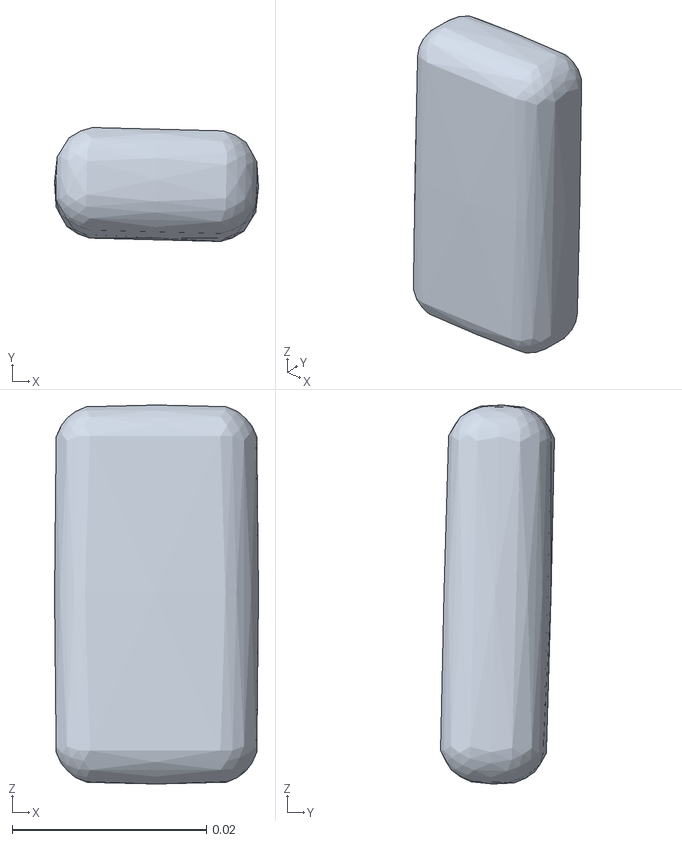
[picture p101: CAD file, 2026-10-03]
design/arms/MicroDuck_Stackchan_Arm_Concepts_v1/assets/01_paddle_stowed_L_paddle.obj
0.021 x 0.0117 x 0.039
