meganetaaan/microduck-stackchan/prototype/portrait_print/assets/collision_0797.obj

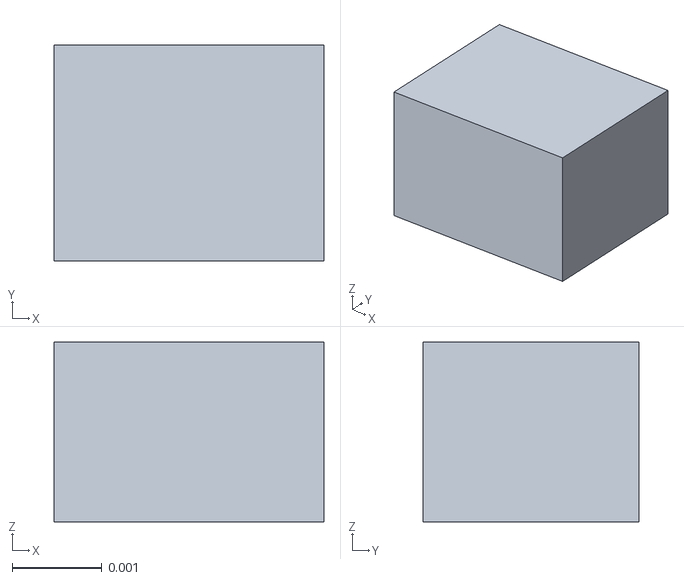
[picture p102: CAD file, 2026-10-03]
prototype/portrait_print/assets/collision_0797.obj
0.003 x 0.0024 x 0.002
