meganetaaan/microduck-stackchan/prototype/portrait_print_v1/assets/collision_0110.obj

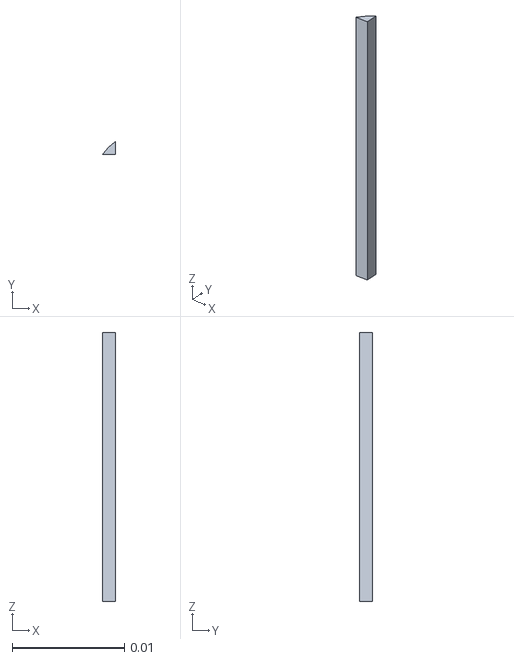
[picture p103: CAD file, 2026-10-03]
prototype/portrait_print_v1/assets/collision_0110.obj
0.00117 x 0.00117 x 0.024
