meganetaaan/microduck-stackchan/prototype/rounded/assets/collision_498.obj

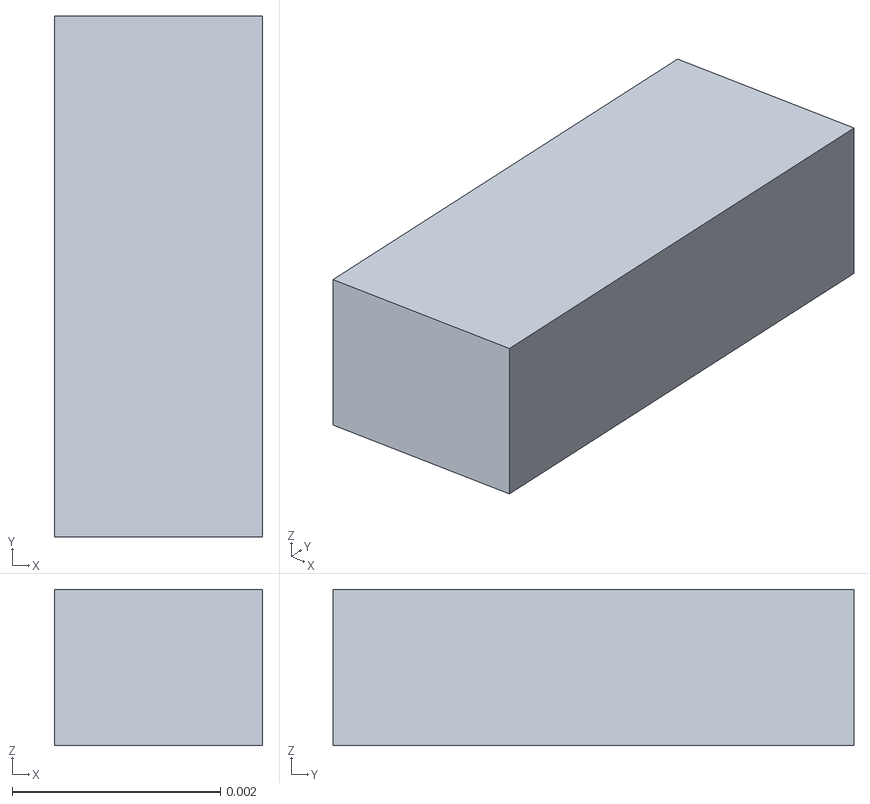
[picture p104: CAD file, 2026-10-03]
prototype/rounded/assets/collision_498.obj
0.002 x 0.005 x 0.0015
