meganetaaan/microduck-stackchan/design/arms/Chunky_Flap_Arm_Concepts_v1/assets/A_slim_flap_display_R_hinge_band_-0.021.obj

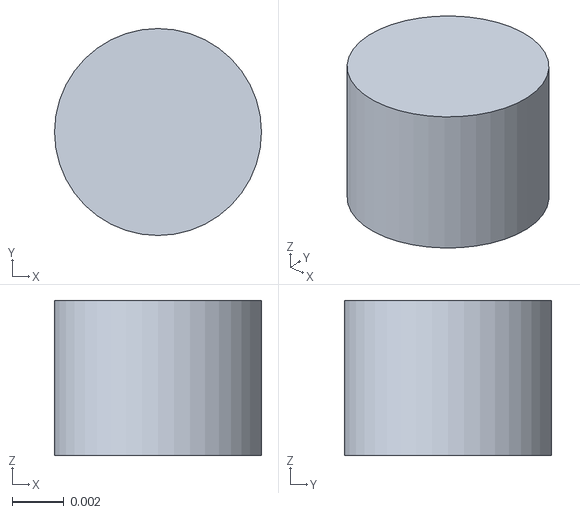
[picture p105: CAD file, 2026-10-03]
design/arms/Chunky_Flap_Arm_Concepts_v1/assets/A_slim_flap_display_R_hinge_band_-0.021.obj
0.008 x 0.008 x 0.006
