meganetaaan/microduck-stackchan/design/arms/MicroDuck_Stackchan_Arm_Concepts_v1/assets/base_098_under_saddle.obj

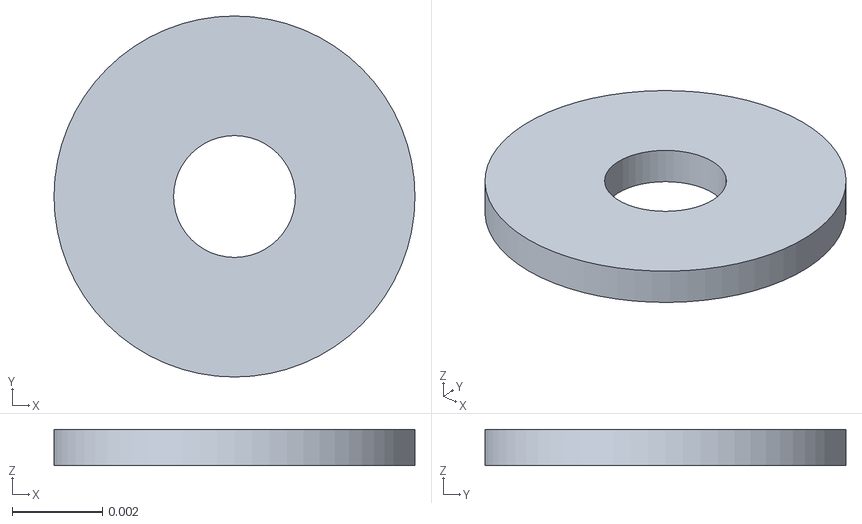
[picture p106: CAD file, 2026-10-03]
design/arms/MicroDuck_Stackchan_Arm_Concepts_v1/assets/base_098_under_saddle.obj
0.008 x 0.008 x 0.0008
