meganetaaan/microduck-stackchan/prototype/assembly_uart/assets/cube_uart_electronics_carrier_0012.obj

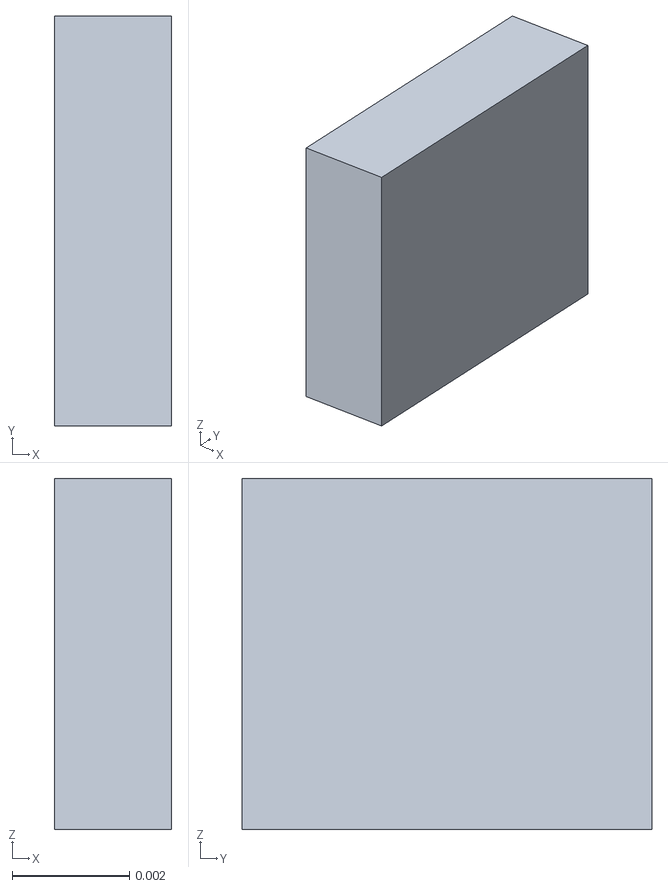
[picture p107: CAD file, 2026-10-03]
prototype/assembly_uart/assets/cube_uart_electronics_carrier_0012.obj
0.002 x 0.007 x 0.006
