meganetaaan/microduck-stackchan/prototype/portrait_print/assets/collision_0519.obj

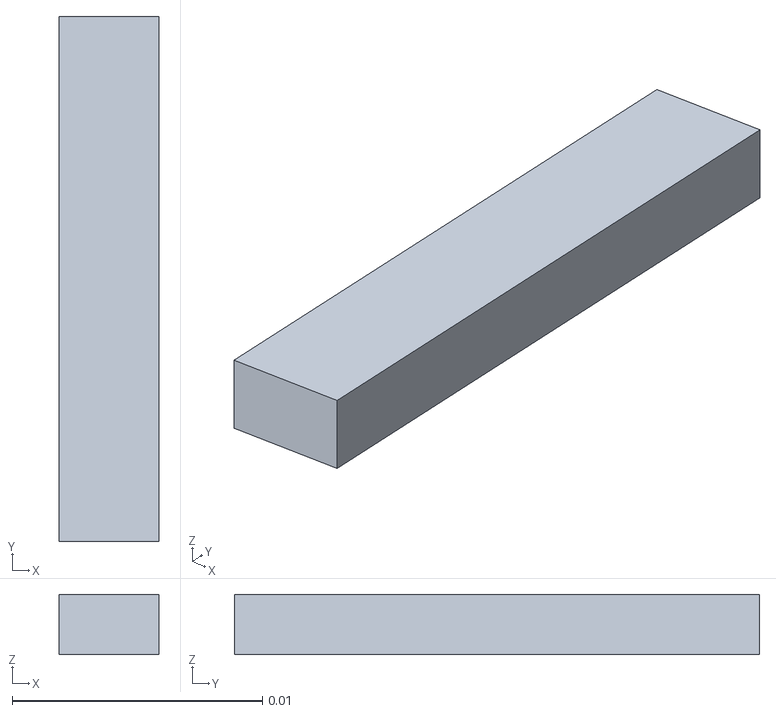
[picture p108: CAD file, 2026-10-03]
prototype/portrait_print/assets/collision_0519.obj
0.004 x 0.021 x 0.0024
