meganetaaan/microduck-stackchan/design/arms/Chunky_Flap_Arm_Concepts_v1/assets/B_rounded_armor_stowed_R_joint_band_-0.022.obj

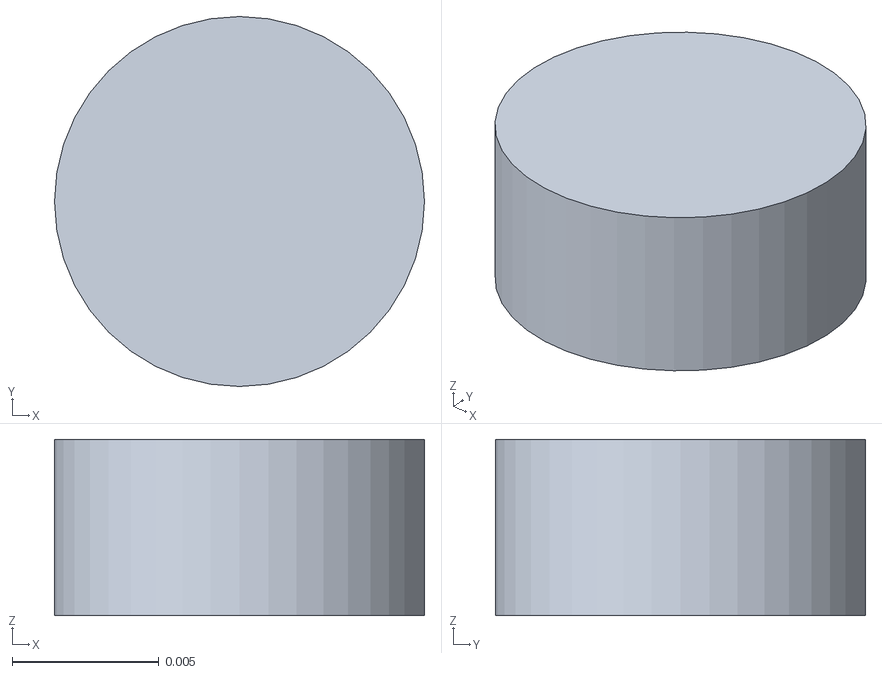
[picture p110: CAD file, 2026-10-03]
design/arms/Chunky_Flap_Arm_Concepts_v1/assets/B_rounded_armor_stowed_R_joint_band_-0.022.obj
0.0126 x 0.0126 x 0.006
