meganetaaan/microduck-stackchan/design/arms/MicroDuck_Stackchan_Arm_Concepts_v1/assets/base_008_seeed_bearing__configuration__22x16x4.stl

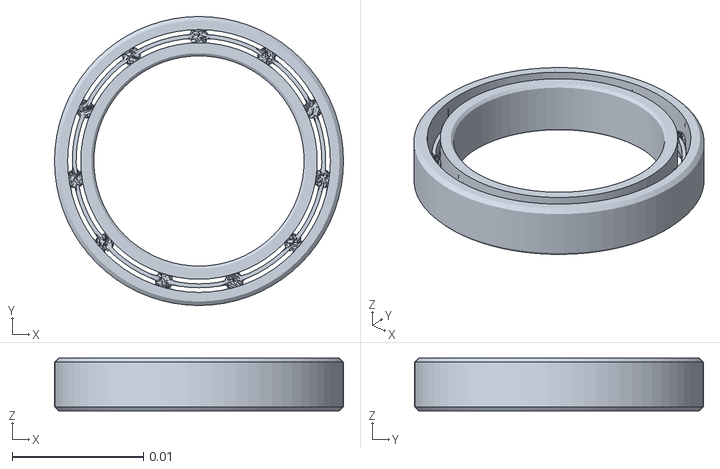
[picture p111: CAD file, 2026-10-03]
design/arms/MicroDuck_Stackchan_Arm_Concepts_v1/assets/base_008_seeed_bearing__configuration__22x16x4.stl
0.022 x 0.022 x 0.004
