meganetaaan/microduck-stackchan/prototype/assembly_uart/assets/cube_uart_electronics_carrier_0208.obj

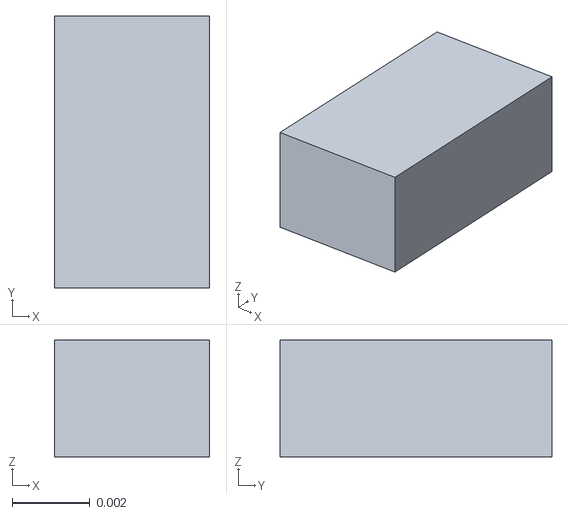
[picture p112: CAD file, 2026-10-03]
prototype/assembly_uart/assets/cube_uart_electronics_carrier_0208.obj
0.004 x 0.007 x 0.003
