meganetaaan/microduck-stackchan/prototype/portrait_print/assets/collision_0194.obj

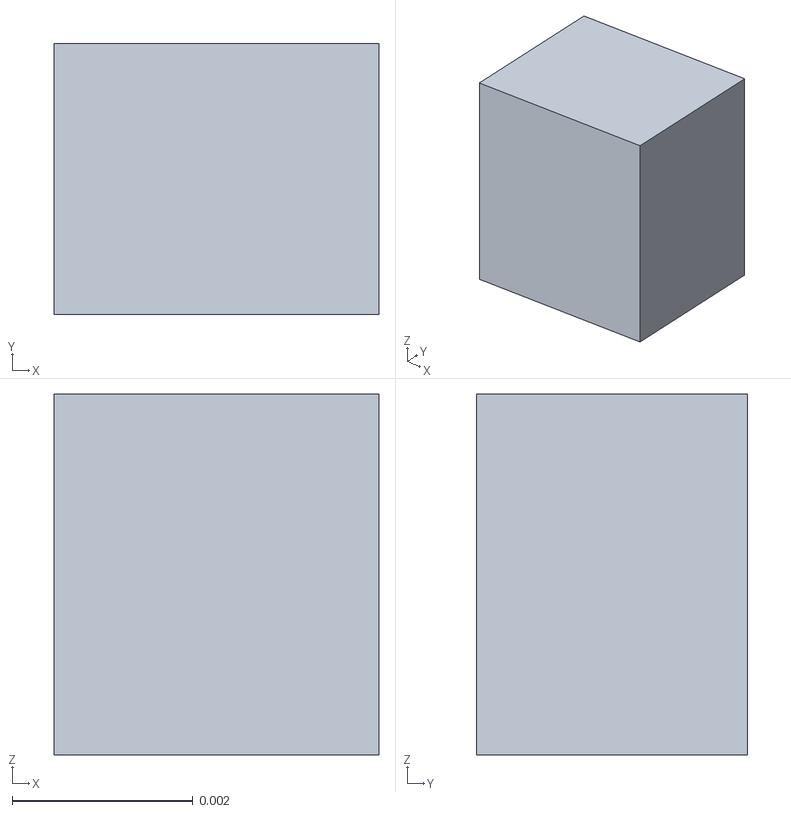
[picture p113: CAD file, 2026-10-03]
prototype/portrait_print/assets/collision_0194.obj
0.0036 x 0.003 x 0.004
