meganetaaan/microduck-stackchan/prototype/portrait_print_v1/assets/collision_1049.obj

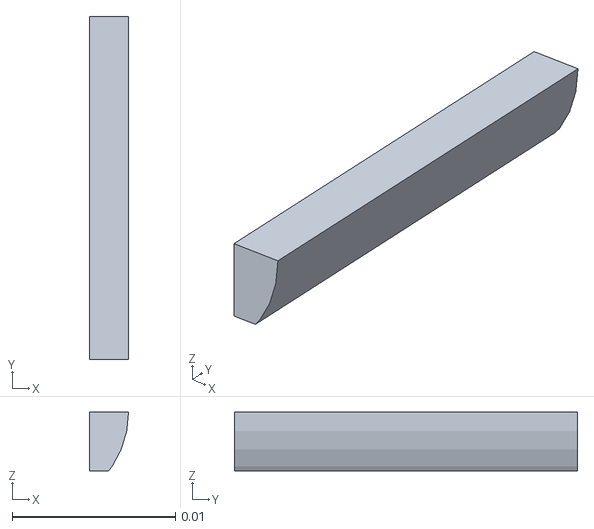
[picture p114: CAD file, 2026-10-03]
prototype/portrait_print_v1/assets/collision_1049.obj
0.0024 x 0.021 x 0.0036
