meganetaaan/microduck-stackchan/prototype/rounded/assets/collision_101.obj

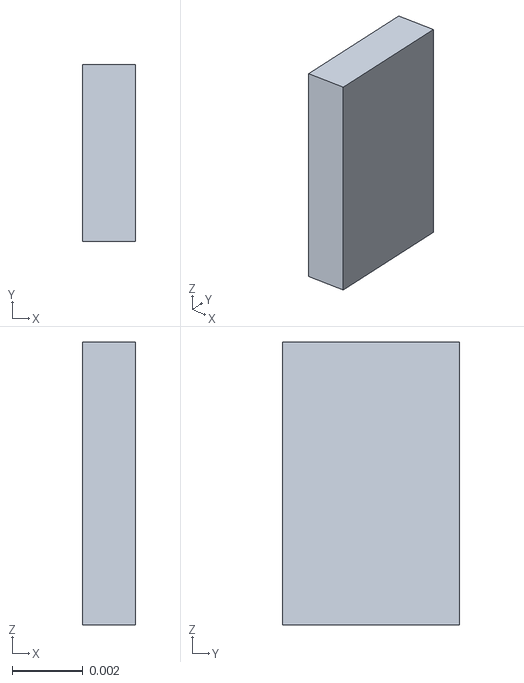
[picture p115: CAD file, 2026-10-03]
prototype/rounded/assets/collision_101.obj
0.0015 x 0.005 x 0.008
