meganetaaan/microduck-stackchan/design/arms/Chunky_Flap_Arm_Concepts_v1/assets/base_1606_radxa_M2p5_1.obj

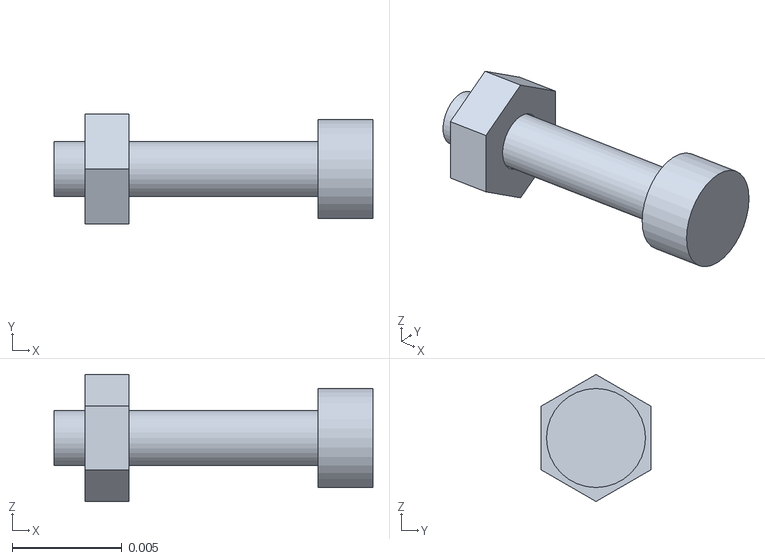
[picture p116: CAD file, 2026-10-03]
design/arms/Chunky_Flap_Arm_Concepts_v1/assets/base_1606_radxa_M2p5_1.obj
0.0145 x 0.005 x 0.00577
