meganetaaan/microduck-stackchan/prototype/rounded/assets/collision_002.obj

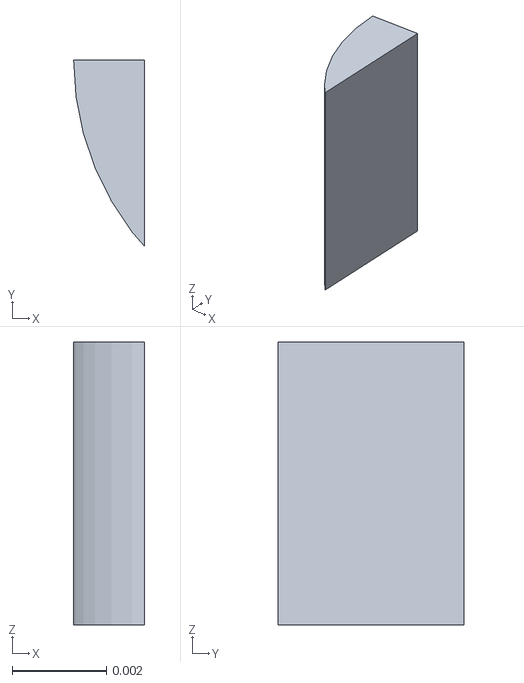
[picture p117: CAD file, 2026-10-03]
prototype/rounded/assets/collision_002.obj
0.0015 x 0.00395 x 0.006
