meganetaaan/microduck-stackchan/design/arms/Chunky_Flap_Arm_Concepts_v1/assets/C_chunky_armor_display_R_joint_band_-0.022.obj

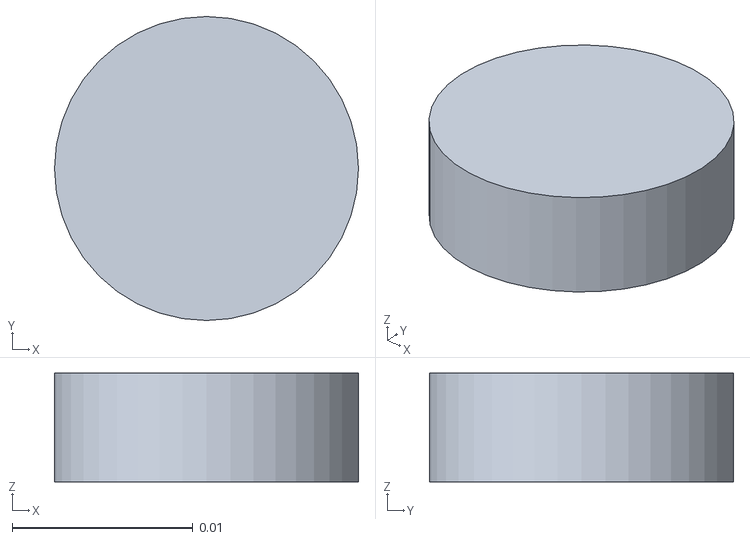
[picture p118: CAD file, 2026-10-03]
design/arms/Chunky_Flap_Arm_Concepts_v1/assets/C_chunky_armor_display_R_joint_band_-0.022.obj
0.0168 x 0.0168 x 0.006
