meganetaaan/microduck-stackchan/design/arms/MicroDuck_Stackchan_Arm_Concepts_v1/assets/base_1612_carrier_M2_0.obj

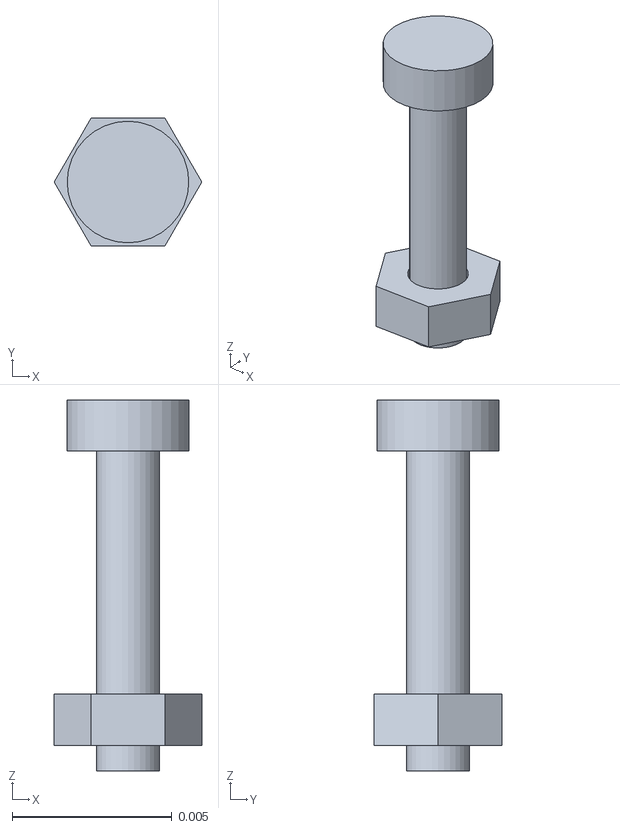
[picture p119: CAD file, 2026-10-03]
design/arms/MicroDuck_Stackchan_Arm_Concepts_v1/assets/base_1612_carrier_M2_0.obj
0.00462 x 0.004 x 0.0116
