meganetaaan/microduck-stackchan/prototype/assembly_uart/assets/cube_uart_body_cage_1083.obj

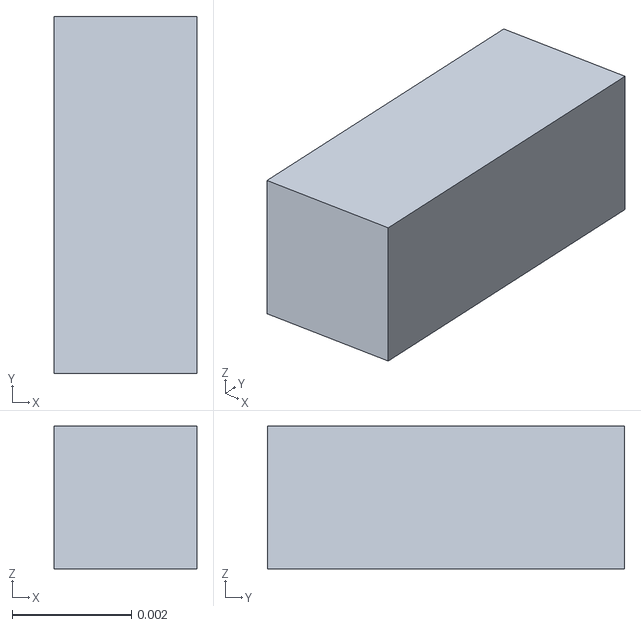
[picture p120: CAD file, 2026-10-03]
prototype/assembly_uart/assets/cube_uart_body_cage_1083.obj
0.0024 x 0.006 x 0.0024
