meganetaaan/microduck-stackchan/prototype/portrait_print/assets/collision_0252.obj

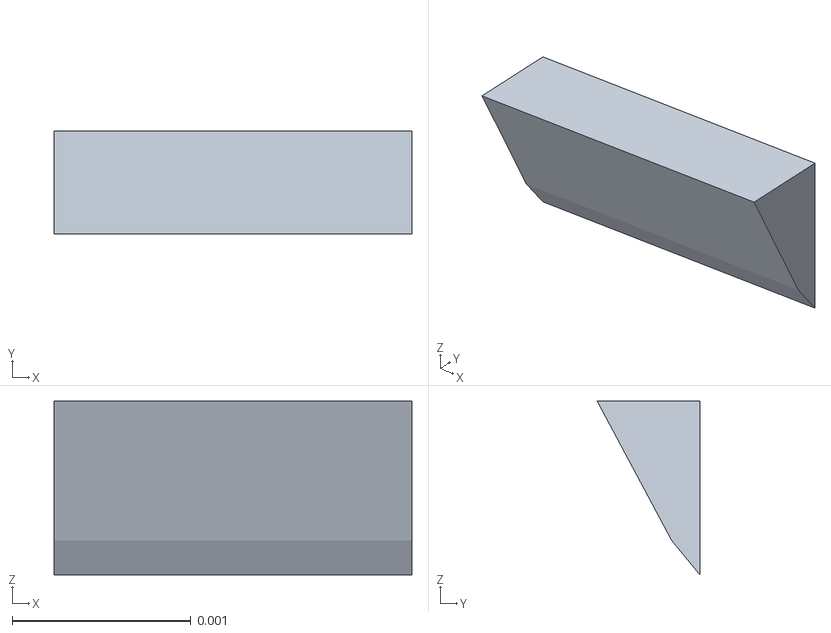
[picture p121: CAD file, 2026-10-03]
prototype/portrait_print/assets/collision_0252.obj
0.002 x 0.000573 x 0.00097
