meganetaaan/microduck-stackchan/prototype/portrait_print_v1/assets/collision_0816.obj

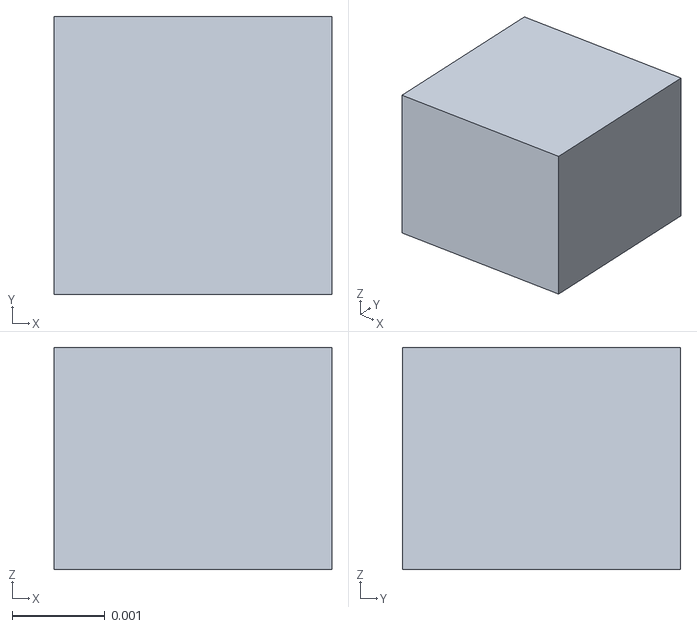
[picture p122: CAD file, 2026-10-03]
prototype/portrait_print_v1/assets/collision_0816.obj
0.003 x 0.003 x 0.0024
