meganetaaan/microduck-stackchan/prototype/rounded/assets/collision_174.obj

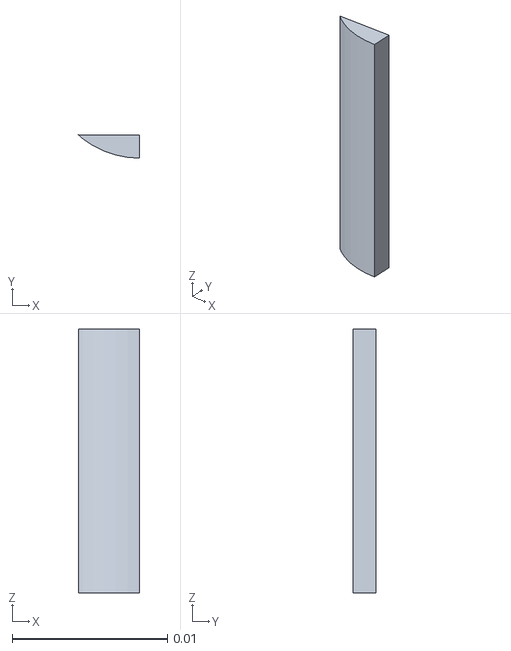
[picture p123: CAD file, 2026-10-03]
prototype/rounded/assets/collision_174.obj
0.00395 x 0.0015 x 0.017
