meganetaaan/microduck-stackchan/design/arms/Chunky_Flap_Arm_Concepts_v1/assets/base_1673_uart_loom.obj

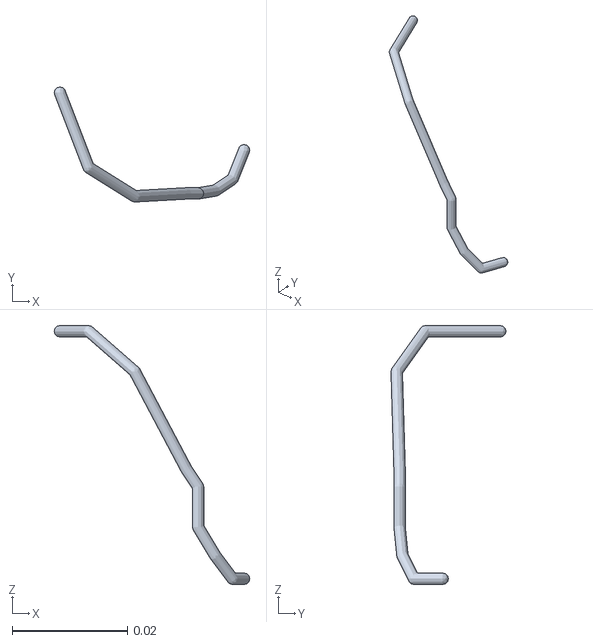
[picture p124: CAD file, 2026-10-03]
design/arms/Chunky_Flap_Arm_Concepts_v1/assets/base_1673_uart_loom.obj
0.034 x 0.02 x 0.045
