meganetaaan/microduck-stackchan/design/arms/MicroDuck_Stackchan_Arm_Concepts_v1/assets/base_019_sole_left.stl

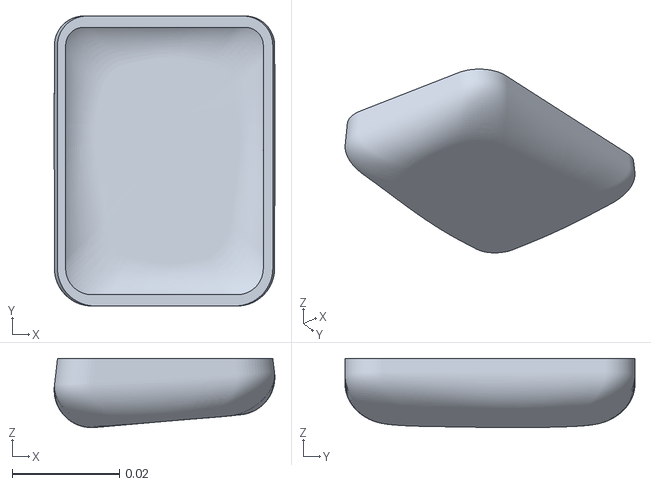
[picture p125: CAD file, 2026-10-03]
design/arms/MicroDuck_Stackchan_Arm_Concepts_v1/assets/base_019_sole_left.stl
0.0411 x 0.054 x 0.0129
