meganetaaan/microduck-stackchan/prototype/assembly_uart/assets/cube_uart_body_cage_0758.obj

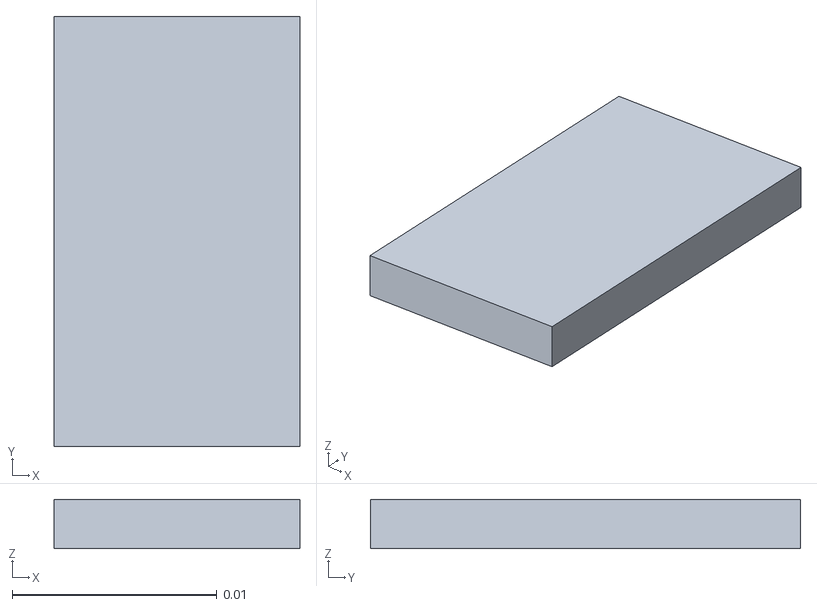
[picture p126: CAD file, 2026-10-03]
prototype/assembly_uart/assets/cube_uart_body_cage_0758.obj
0.012 x 0.021 x 0.0024
