meganetaaan/microduck-stackchan/prototype/portrait_print_v1/assets/collision_0561.obj

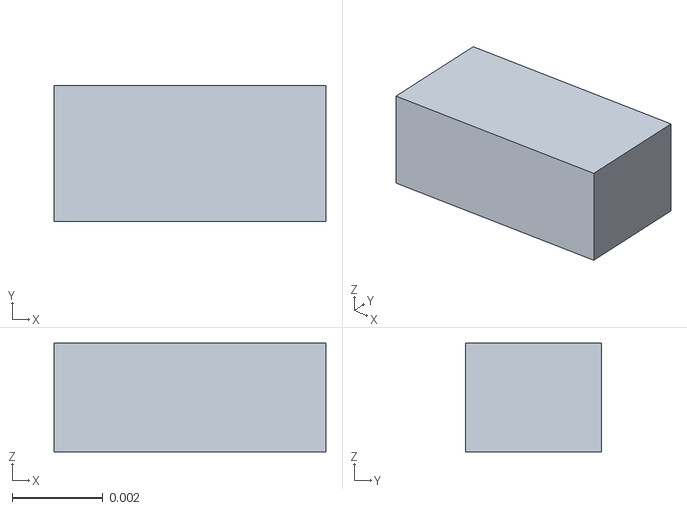
[picture p127: CAD file, 2026-10-03]
prototype/portrait_print_v1/assets/collision_0561.obj
0.006 x 0.003 x 0.0024
