meganetaaan/microduck-stackchan/design/arms/Chunky_Flap_Arm_Concepts_v1/assets/base_1624_protection_mount_pad.obj

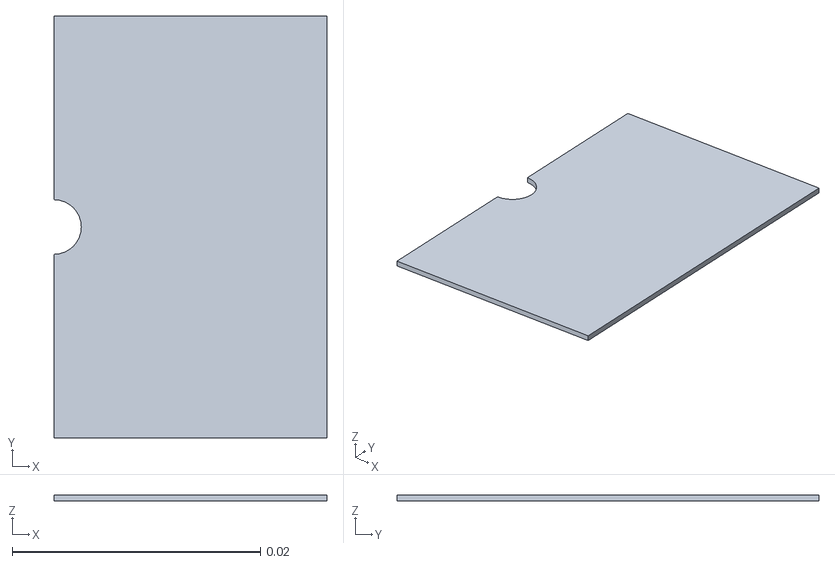
[picture p128: CAD file, 2026-10-03]
design/arms/Chunky_Flap_Arm_Concepts_v1/assets/base_1624_protection_mount_pad.obj
0.022 x 0.034 x 0.0005
