meganetaaan/microduck-stackchan/design/arms/MicroDuck_Stackchan_Arm_Concepts_v1/assets/base_005_trunk_base.stl

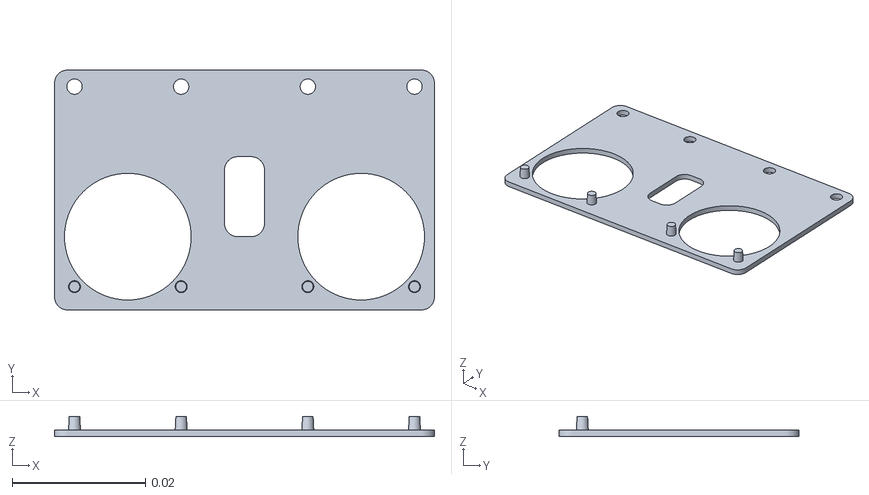
[picture p129: CAD file, 2026-10-03]
design/arms/MicroDuck_Stackchan_Arm_Concepts_v1/assets/base_005_trunk_base.stl
0.057 x 0.036 x 0.003
