meganetaaan/microduck-stackchan/prototype/rounded/assets/collision_334.obj

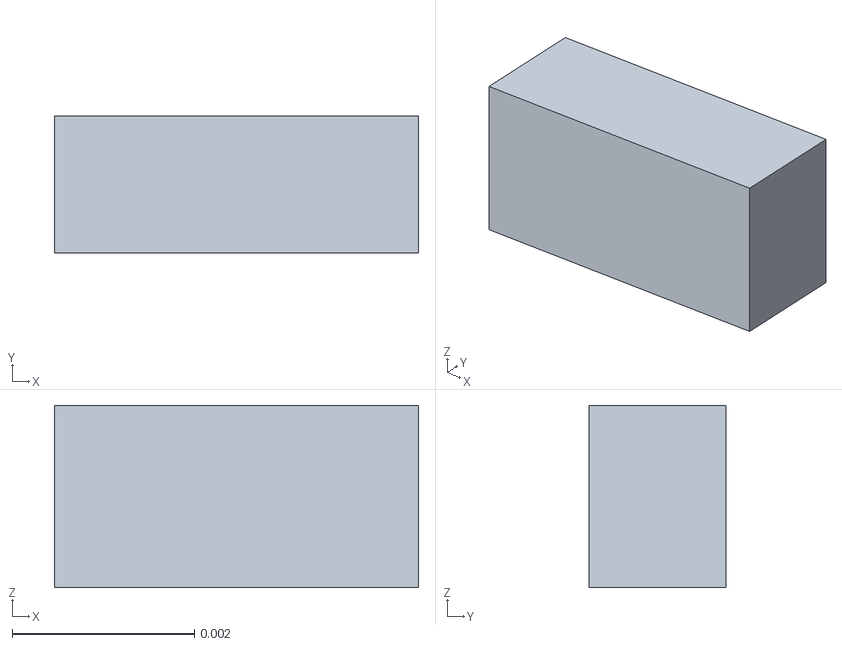
[picture p130: CAD file, 2026-10-03]
prototype/rounded/assets/collision_334.obj
0.004 x 0.0015 x 0.002
