meganetaaan/microduck-stackchan/design/arms/Chunky_Flap_Arm_Concepts_v1/assets/C_chunky_armor_stowed_R_vertical_joint.obj

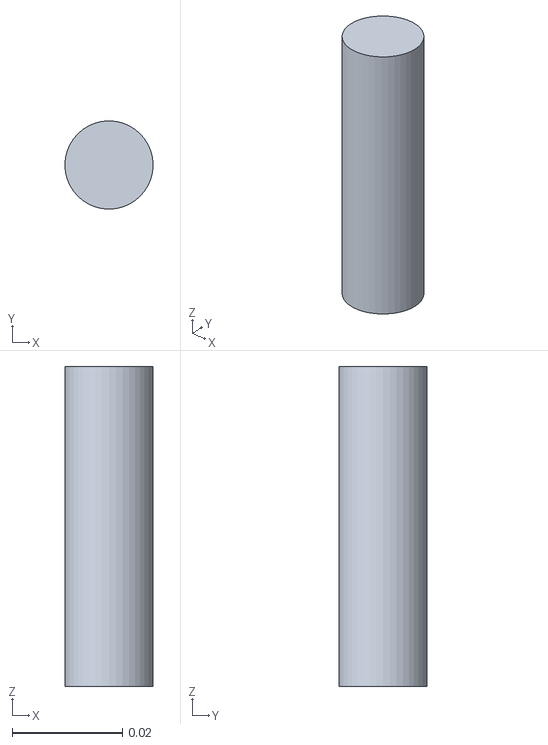
[picture p131: CAD file, 2026-10-03]
design/arms/Chunky_Flap_Arm_Concepts_v1/assets/C_chunky_armor_stowed_R_vertical_joint.obj
0.016 x 0.016 x 0.058
