meganetaaan/microduck-stackchan/design/arms/MicroDuck_Stackchan_Arm_Concepts_v1/assets/03_mitten_display_L_short_link.obj

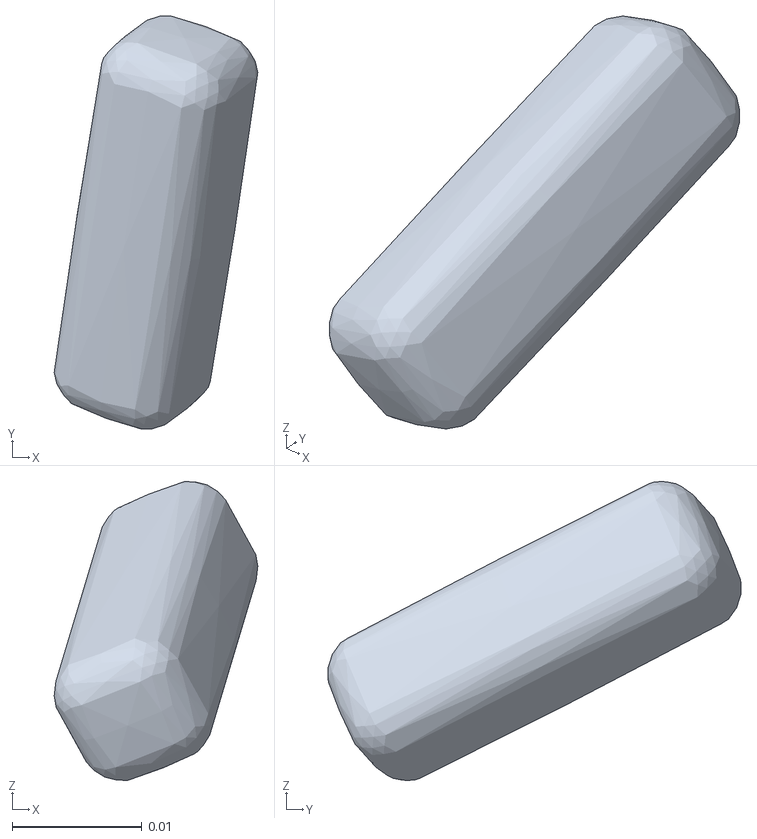
[picture p132: CAD file, 2026-10-03]
design/arms/MicroDuck_Stackchan_Arm_Concepts_v1/assets/03_mitten_display_L_short_link.obj
0.0157 x 0.0318 x 0.0231
