meganetaaan/microduck-stackchan/prototype/portrait_print/assets/collision_0700.obj

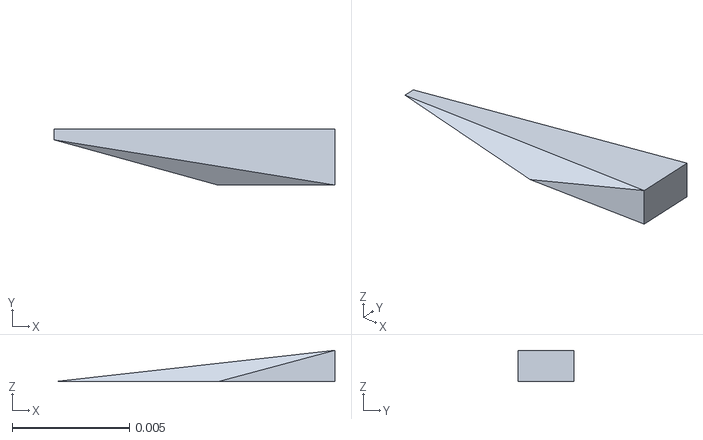
[picture p133: CAD file, 2026-10-03]
prototype/portrait_print/assets/collision_0700.obj
0.012 x 0.0024 x 0.00134
