meganetaaan/microduck-stackchan/prototype/portrait_print_v1/assets/collision_0760.obj

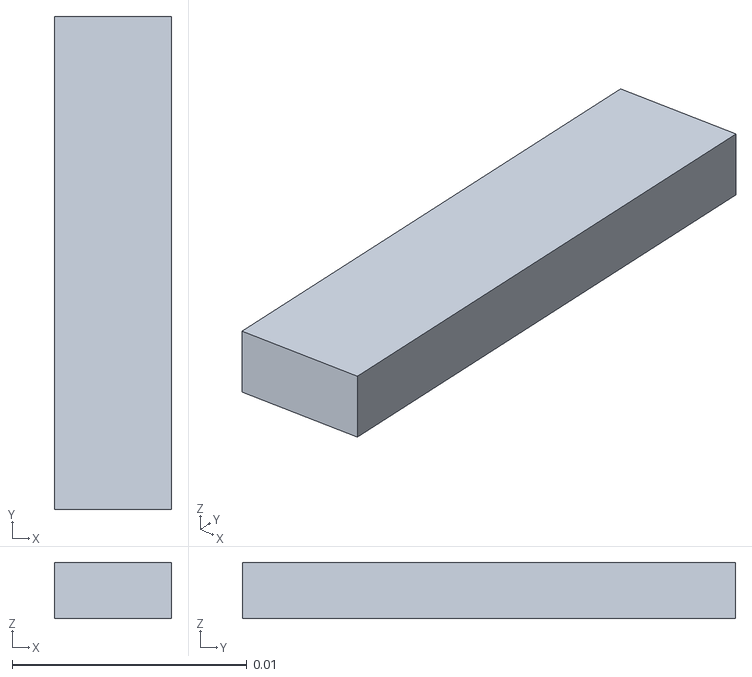
[picture p134: CAD file, 2026-10-03]
prototype/portrait_print_v1/assets/collision_0760.obj
0.005 x 0.021 x 0.0024
