meganetaaan/microduck-stackchan/prototype/rounded/assets/collision_627.obj

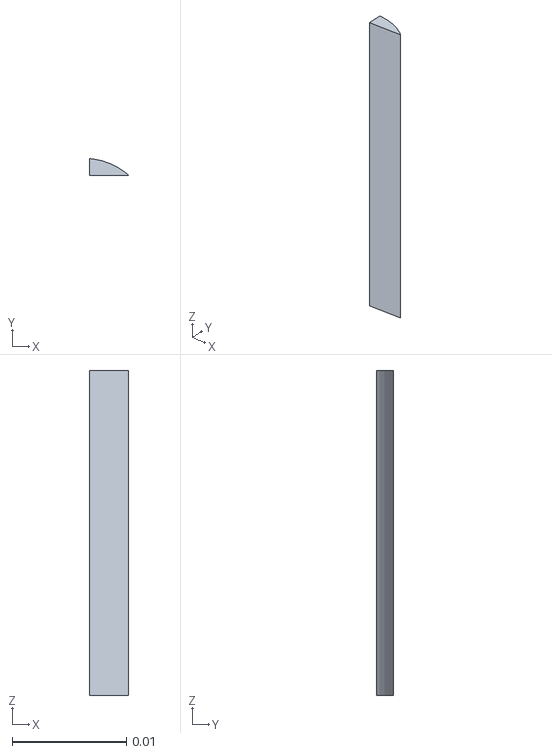
[picture p135: CAD file, 2026-10-03]
prototype/rounded/assets/collision_627.obj
0.00345 x 0.00147 x 0.0285
