meganetaaan/microduck-stackchan/design/arms/Chunky_Flap_Arm_Concepts_v1/assets/base_002_right_shell.stl

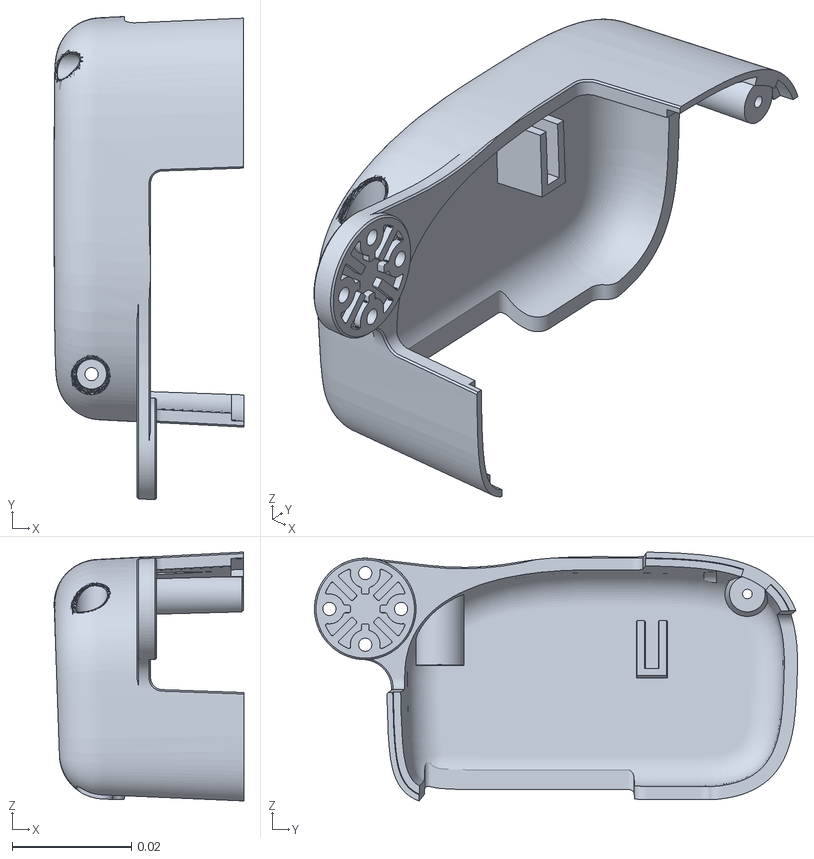
[picture p136: CAD file, 2026-10-03]
design/arms/Chunky_Flap_Arm_Concepts_v1/assets/base_002_right_shell.stl
0.0318 x 0.0809 x 0.0417
