meganetaaan/microduck-stackchan/design/arms/MicroDuck_Stackchan_Arm_Concepts_v1/assets/02_elbow_display_R_mount.obj

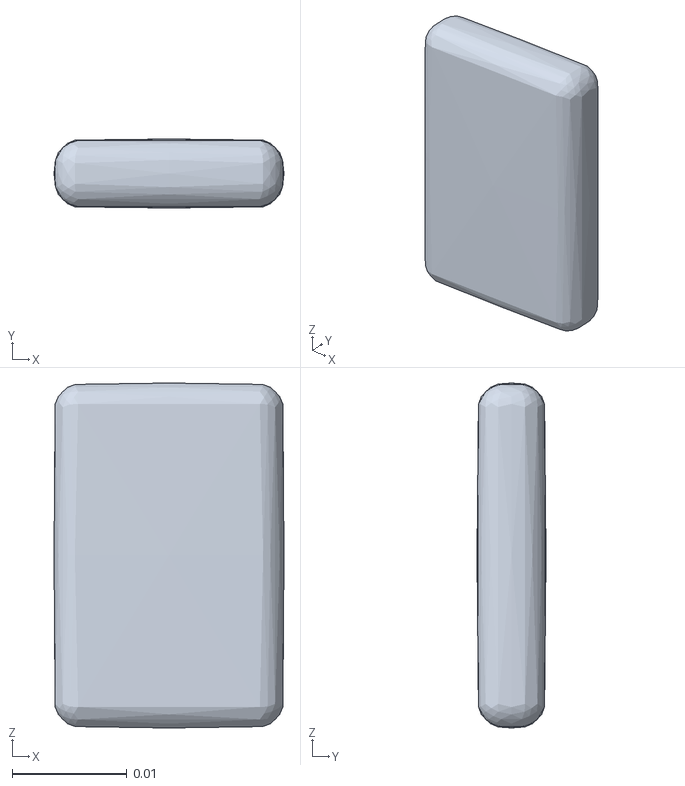
[picture p137: CAD file, 2026-10-03]
design/arms/MicroDuck_Stackchan_Arm_Concepts_v1/assets/02_elbow_display_R_mount.obj
0.02 x 0.006 x 0.03
