meganetaaan/microduck-stackchan/prototype/assembly_uart/assets/cube_uart_body_cage_0035.obj

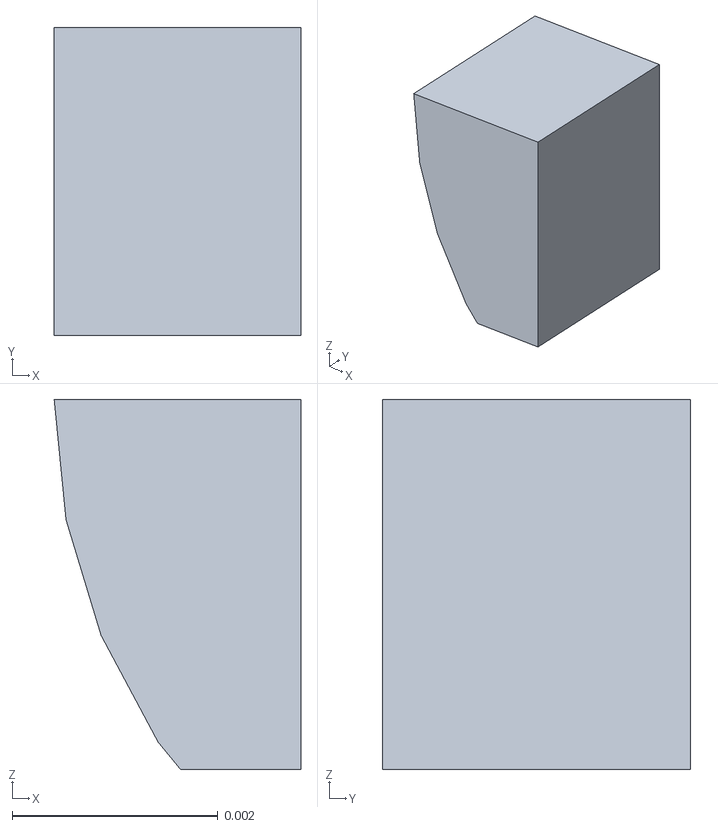
[picture p138: CAD file, 2026-10-03]
prototype/assembly_uart/assets/cube_uart_body_cage_0035.obj
0.0024 x 0.003 x 0.0036
