meganetaaan/microduck-stackchan/(list of files, cad)

Other CAD files:
design/arms/Chunky_Flap_Arm_Concepts_v1/assets/C_chunky_armor_display_L_main_armor.obj
design/arms/Chunky_Flap_Arm_Concepts_v1/assets/C_chunky_armor_stowed_L_main_armor.obj
prototype/assembly_uart/stl_print_oriented/protection_tray_print_mm.stl
prototype/portrait_print/assets/collision_0381.obj
prototype/portrait_print/stl/body_cage_mm.stl
prototype/portrait_print_v1/stl_print_oriented/body_cage_print_mm.stl
prototype/assembly_uart/stl_print_oriented/rear_cover_print_mm.stl
prototype/portrait_print/stl/central_mount_mm.stl
prototype/portrait_print/stl_print_oriented/body_cage_print_mm.stl
prototype/portrait_print_v1/stl/compute_pedestal_mm.stl
prototype/assembly_uart/stl/body_cage_mm.stl
prototype/assembly_uart/stl_print_oriented/central_mount_print_mm.stl
prototype/portrait_print/stl/compute_pedestal_mm.stl
prototype/portrait_print/stl_print_oriented/rear_cover_print_mm.stl
prototype/portrait_print_v1/stl/central_mount_mm.stl
prototype/portrait_print_v1/stl_print_oriented/rear_cover_print_mm.stl
design/arms/MicroDuck_Stackchan_Arm_Concepts_v1/assets/04_flap_display_L_orange_edge.obj
prototype/assembly_uart/stl_print_oriented/electronics_carrier_print_mm.stl
prototype/assembly_uart/assets/cube_uart_body_cage_0812.obj
prototype/portrait_print/assets/collision_0587.obj
design/arms/Chunky_Flap_Arm_Concepts_v1/assets/B_rounded_armor_stowed_L_orange_tip.obj
design/arms/MicroDuck_Stackchan_Arm_Concepts_v1/assets/02_elbow_stowed_R_cap_center.obj
prototype/assembly_uart/assets/cube_uart_body_cage_0087.obj
prototype/portrait_print_v1/assets/collision_1061.obj
design/arms/MicroDuck_Stackchan_Arm_Concepts_v1/assets/01_paddle_stowed_R_paddle.obj
prototype/assembly_uart/assets/radxa_M2p5_3.obj
prototype/portrait_print/assets/collision_0577.obj
prototype/portrait_print_v1/assets/collision_0935.obj
prototype/portrait_print/assets/collision_0058.obj
prototype/rounded/assets/collision_245.obj
prototype/assembly_uart/assets/cube_uart_body_cage_0056.obj
prototype/portrait_print/assets/collision_0057.obj
prototype/portrait_print_v1/assets/collision_1024.obj
prototype/assembly_uart/assets/cube_uart_body_cage_0847.obj
prototype/portrait_print/assets/collision_0544.obj
design/arms/Chunky_Flap_Arm_Concepts_v1/assets/A_slim_flap_display_L_hinge_band_-0.021.obj
design/arms/Chunky_Flap_Arm_Concepts_v1/assets/A_slim_flap_display_L_hinge_band_0.021.obj
design/arms/Chunky_Flap_Arm_Concepts_v1/assets/A_slim_flap_display_L_hinge_mount.obj
design/arms/Chunky_Flap_Arm_Concepts_v1/assets/A_slim_flap_display_L_orange_edge.obj
design/arms/Chunky_Flap_Arm_Concepts_v1/assets/A_slim_flap_display_L_panel_inset.obj
design/arms/Chunky_Flap_Arm_Concepts_v1/assets/A_slim_flap_display_L_side_flap.obj
design/arms/Chunky_Flap_Arm_Concepts_v1/assets/A_slim_flap_display_L_vertical_hinge.obj
design/arms/Chunky_Flap_Arm_Concepts_v1/assets/A_slim_flap_display_R_hinge_band_0.021.obj
design/arms/Chunky_Flap_Arm_Concepts_v1/assets/A_slim_flap_display_R_hinge_mount.obj
design/arms/Chunky_Flap_Arm_Concepts_v1/assets/A_slim_flap_display_R_panel_inset.obj
design/arms/Chunky_Flap_Arm_Concepts_v1/assets/A_slim_flap_display_R_side_flap.obj
design/arms/Chunky_Flap_Arm_Concepts_v1/assets/A_slim_flap_stowed_L_hinge_band_-0.021.obj
design/arms/Chunky_Flap_Arm_Concepts_v1/assets/A_slim_flap_stowed_L_hinge_band_0.021.obj
design/arms/Chunky_Flap_Arm_Concepts_v1/assets/A_slim_flap_stowed_L_hinge_mount.obj
design/arms/Chunky_Flap_Arm_Concepts_v1/assets/A_slim_flap_stowed_L_orange_edge.obj
design/arms/Chunky_Flap_Arm_Concepts_v1/assets/A_slim_flap_stowed_L_panel_inset.obj
design/arms/Chunky_Flap_Arm_Concepts_v1/assets/A_slim_flap_stowed_L_side_flap.obj
design/arms/Chunky_Flap_Arm_Concepts_v1/assets/A_slim_flap_stowed_L_vertical_hinge.obj
design/arms/Chunky_Flap_Arm_Concepts_v1/assets/A_slim_flap_stowed_R_hinge_band_0.021.obj
design/arms/Chunky_Flap_Arm_Concepts_v1/assets/A_slim_flap_stowed_R_hinge_mount.obj
design/arms/Chunky_Flap_Arm_Concepts_v1/assets/A_slim_flap_stowed_R_orange_edge.obj
design/arms/Chunky_Flap_Arm_Concepts_v1/assets/A_slim_flap_stowed_R_panel_inset.obj
design/arms/Chunky_Flap_Arm_Concepts_v1/assets/B_rounded_armor_display_L_joint_band_-0.022.obj
design/arms/Chunky_Flap_Arm_Concepts_v1/assets/B_rounded_armor_display_L_joint_band_0.022.obj
design/arms/Chunky_Flap_Arm_Concepts_v1/assets/B_rounded_armor_display_L_lower_rib_-1.obj
design/arms/Chunky_Flap_Arm_Concepts_v1/assets/B_rounded_armor_display_L_lower_rib_1.obj
design/arms/Chunky_Flap_Arm_Concepts_v1/assets/B_rounded_armor_display_L_recess_-1.obj
design/arms/Chunky_Flap_Arm_Concepts_v1/assets/B_rounded_armor_display_L_recess_1.obj
design/arms/Chunky_Flap_Arm_Concepts_v1/assets/B_rounded_armor_display_L_round_armor.obj
design/arms/Chunky_Flap_Arm_Concepts_v1/assets/B_rounded_armor_display_L_rounded_tip.obj
design/arms/Chunky_Flap_Arm_Concepts_v1/assets/B_rounded_armor_display_L_side_mount.obj
design/arms/Chunky_Flap_Arm_Concepts_v1/assets/B_rounded_armor_display_L_upper_rib_-1.obj
design/arms/Chunky_Flap_Arm_Concepts_v1/assets/B_rounded_armor_display_L_upper_rib_1.obj
design/arms/Chunky_Flap_Arm_Concepts_v1/assets/B_rounded_armor_display_L_vertical_joint.obj
design/arms/Chunky_Flap_Arm_Concepts_v1/assets/B_rounded_armor_display_R_joint_band_0.022.obj
design/arms/Chunky_Flap_Arm_Concepts_v1/assets/B_rounded_armor_display_R_lower_rib_-1.obj
design/arms/Chunky_Flap_Arm_Concepts_v1/assets/B_rounded_armor_display_R_lower_rib_1.obj
design/arms/Chunky_Flap_Arm_Concepts_v1/assets/B_rounded_armor_display_R_orange_tip.obj
design/arms/Chunky_Flap_Arm_Concepts_v1/assets/B_rounded_armor_display_R_recess_-1.obj
design/arms/Chunky_Flap_Arm_Concepts_v1/assets/B_rounded_armor_display_R_recess_1.obj
design/arms/Chunky_Flap_Arm_Concepts_v1/assets/B_rounded_armor_display_R_round_armor.obj
design/arms/Chunky_Flap_Arm_Concepts_v1/assets/B_rounded_armor_display_R_rounded_tip.obj
design/arms/Chunky_Flap_Arm_Concepts_v1/assets/B_rounded_armor_display_R_side_mount.obj
design/arms/Chunky_Flap_Arm_Concepts_v1/assets/B_rounded_armor_display_R_upper_rib_-1.obj
design/arms/Chunky_Flap_Arm_Concepts_v1/assets/B_rounded_armor_display_R_upper_rib_1.obj
design/arms/Chunky_Flap_Arm_Concepts_v1/assets/B_rounded_armor_display_R_vertical_joint.obj
design/arms/Chunky_Flap_Arm_Concepts_v1/assets/B_rounded_armor_stowed_L_joint_band_-0.022.obj
design/arms/Chunky_Flap_Arm_Concepts_v1/assets/B_rounded_armor_stowed_L_joint_band_0.022.obj
design/arms/Chunky_Flap_Arm_Concepts_v1/assets/B_rounded_armor_stowed_L_lower_rib_-1.obj
design/arms/Chunky_Flap_Arm_Concepts_v1/assets/B_rounded_armor_stowed_L_lower_rib_1.obj
design/arms/Chunky_Flap_Arm_Concepts_v1/assets/B_rounded_armor_stowed_L_recess_-1.obj
design/arms/Chunky_Flap_Arm_Concepts_v1/assets/B_rounded_armor_stowed_L_recess_1.obj
design/arms/Chunky_Flap_Arm_Concepts_v1/assets/B_rounded_armor_stowed_L_round_armor.obj
design/arms/Chunky_Flap_Arm_Concepts_v1/assets/B_rounded_armor_stowed_L_rounded_tip.obj
design/arms/Chunky_Flap_Arm_Concepts_v1/assets/B_rounded_armor_stowed_L_side_mount.obj
design/arms/Chunky_Flap_Arm_Concepts_v1/assets/B_rounded_armor_stowed_L_upper_rib_-1.obj
design/arms/Chunky_Flap_Arm_Concepts_v1/assets/B_rounded_armor_stowed_L_upper_rib_1.obj
design/arms/Chunky_Flap_Arm_Concepts_v1/assets/B_rounded_armor_stowed_L_vertical_joint.obj
design/arms/Chunky_Flap_Arm_Concepts_v1/assets/B_rounded_armor_stowed_R_joint_band_0.022.obj
design/arms/Chunky_Flap_Arm_Concepts_v1/assets/B_rounded_armor_stowed_R_lower_rib_1.obj
design/arms/Chunky_Flap_Arm_Concepts_v1/assets/B_rounded_armor_stowed_R_recess_-1.obj
design/arms/Chunky_Flap_Arm_Concepts_v1/assets/B_rounded_armor_stowed_R_recess_1.obj
design/arms/Chunky_Flap_Arm_Concepts_v1/assets/B_rounded_armor_stowed_R_round_armor.obj
design/arms/Chunky_Flap_Arm_Concepts_v1/assets/B_rounded_armor_stowed_R_rounded_tip.obj
design/arms/Chunky_Flap_Arm_Concepts_v1/assets/B_rounded_armor_stowed_R_side_mount.obj
design/arms/Chunky_Flap_Arm_Concepts_v1/assets/B_rounded_armor_stowed_R_upper_rib_-1.obj
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
