meganetaaan/microduck-stackchan/prototype/portrait_print/idle_10s.csv

time_s | x_m | y_m | z_m | tilt_deg | left_contact | right_contact | max_abs_torque_nm
0.02 | -1.4707474432799332e-06 | -1.0896825038645874e-05 | 0.122557842394821 | 0.01507933473911233 | 0 | 0 | 0.07312964096531836
0.04 | -1.741664072140931e-05 | -2.554011437118205e-05 | 0.11620920459510951 | 0.04668601739603627 | 1 | 1 | 0.038676845190584244
0.05999999999999999 | 0.0003203733406967722 | 4.272426690846159e-05 | 0.11491723645428316 | 0.31665065070150744 | 1 | 1 | 0.04609894204169509
0.08 | 0.0010057392220303883 | 0.0001347875107110871 | 0.11564414519921824 | 0.6035872747402407 | 1 | 1 | 0.05903905916582285
0.10000000000000002 | 0.0015668481959963034 | 0.00016189234275841457 | 0.11622177581329422 | 0.8693091432422472 | 1 | 1 | 0.05376660031979629
0.12000000000000004 | 0.0019703123179048 | 0.00019221021097183416 | 0.11652747003875799 | 1.078543050595129 | 1 | 1 | 0.05416549340109982
0.14000000000000004 | 0.0022543878098354913 | 0.00021095148489017618 | 0.11663750323564274 | 1.236363344215087 | 1 | 1 | 0.053586945207769875
0.16000000000000006 | 0.0024479946423746606 | 0.00021384599270500278 | 0.11665817391394308 | 1.3485081627794075 | 1 | 1 | 0.052625119359079466
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
