meganetaaan/microduck-stackchan/prototype/portrait_print/walking_demo.csv

time_s | x_m | y_m | z_m | tilt_deg | left_contact | right_contact | max_abs_torque_nm
0.02 | -1.4707474432799332e-06 | -1.0896825038645874e-05 | 0.122557842394821 | 0.01507933473911233 | 0 | 0 | 0.07312964096531836
0.04 | -1.6749195119402523e-05 | -2.5395710795060868e-05 | 0.11620852946665909 | 0.046015595705085836 | 1 | 1 | 0.04205732480815391
0.05999999999999999 | 0.000334827580185596 | 3.8932351369692517e-05 | 0.1149035988724289 | 0.30910007420850927 | 1 | 1 | 0.051465781582374345
0.08 | 0.0010970248876180917 | 0.00013945999574214673 | 0.11560466413434575 | 0.5768386651530906 | 1 | 1 | 0.054436356518787976
0.10000000000000002 | 0.0018080671302062035 | 0.00021090868185331808 | 0.11615689729704669 | 0.8357731188007085 | 1 | 1 | 0.04931891038158599
0.12000000000000004 | 0.0023798446719046017 | 0.0002864237212373412 | 0.11643402272156739 | 1.0751184618943994 | 1 | 1 | 0.049338453814577694
0.14000000000000004 | 0.0028852241776426532 | 0.00035471031543916366 | 0.11651370677516106 | 1.2701533374641178 | 1 | 1 | 0.04934176529994086
0.16000000000000006 | 0.003351773738053237 | 0.0004164143928642716 | 0.11650049145540713 | 1.414283483573284 | 1 | 1 | 0.048794711530397494
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
