meganetaaan/microduck-stackchan/prototype/portrait_print_v1/idle_10s.csv

time_s | x_m | y_m | z_m | tilt_deg | left_contact | right_contact | max_abs_torque_nm
0.02 | -1.4531858051601695e-06 | -1.0869188050458059e-05 | 0.12255785812288722 | 0.01512488000458898 | 0 | 0 | 0.07312962440467169
0.04 | -1.7350963453707888e-05 | -2.54861343664452e-05 | 0.11620924683126337 | 0.046795091951562326 | 1 | 1 | 0.03867183390285995
0.05999999999999999 | 0.0003184325354628671 | 4.286199428994924e-05 | 0.11491858632473542 | 0.3119072471140247 | 1 | 1 | 0.045860998519433496
0.08 | 0.000997334319864571 | 0.00013518071595011453 | 0.11564658258644064 | 0.594266619218063 | 1 | 1 | 0.058483112089384864
0.10000000000000002 | 0.0015516826448968536 | 0.00016262992129461887 | 0.1162239177787754 | 0.8560305752777764 | 1 | 1 | 0.05334307992552864
0.12000000000000004 | 0.001953297507119666 | 0.00019846013809396814 | 0.1165325310160031 | 1.0636320851874055 | 1 | 1 | 0.053679978247602025
0.14000000000000004 | 0.0022372154892481523 | 0.0002191892173398994 | 0.11664201347954639 | 1.2208411203909129 | 1 | 1 | 0.05349178846264669
0.16000000000000006 | 0.002429030107401248 | 0.0002193722318703661 | 0.11666129272668724 | 1.3321351416996559 | 1 | 1 | 0.05219505460874465
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
