meganetaaan/microduck-stackchan/prototype/portrait_print_v1/walk_10s.csv

time_s | x_m | y_m | z_m | tilt_deg | left_contact | right_contact | max_abs_torque_nm
0.02 | -1.4531858051601695e-06 | -1.0869188050458059e-05 | 0.12255785812288722 | 0.01512488000458898 | 0 | 0 | 0.07312962440467169
0.04 | -1.6682403280602943e-05 | -2.5339591810103306e-05 | 0.11620857010833167 | 0.04612595998878589 | 1 | 1 | 0.04205236058805066
0.05999999999999999 | 0.000332902788850517 | 3.9055275709986645e-05 | 0.11490493131828491 | 0.30433630445301246 | 1 | 1 | 0.05145789579675452
0.08 | 0.0010885951486862325 | 0.00014025262991528996 | 0.11560707663321527 | 0.5674285669692543 | 1 | 1 | 0.0538599601406716
0.10000000000000002 | 0.0017924742698038612 | 0.0002120797371987282 | 0.11615906859929205 | 0.821789874994172 | 1 | 1 | 0.04887332017911245
0.12000000000000004 | 0.0023537073632305954 | 0.0002829762049334569 | 0.11643623212870458 | 1.0566457863832115 | 1 | 1 | 0.04878567538158649
0.14000000000000004 | 0.0028555516660856844 | 0.00035394258512378774 | 0.1165166858721962 | 1.2463971350649838 | 1 | 1 | 0.04862002893450065
0.16000000000000006 | 0.003319367545136901 | 0.0004160809432141703 | 0.11650241799425715 | 1.3858078348950285 | 1 | 1 | 0.04809861445063011
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
