meganetaaan/microduck-stackchan/prototype/assembly_uart/assembly_service_view.png

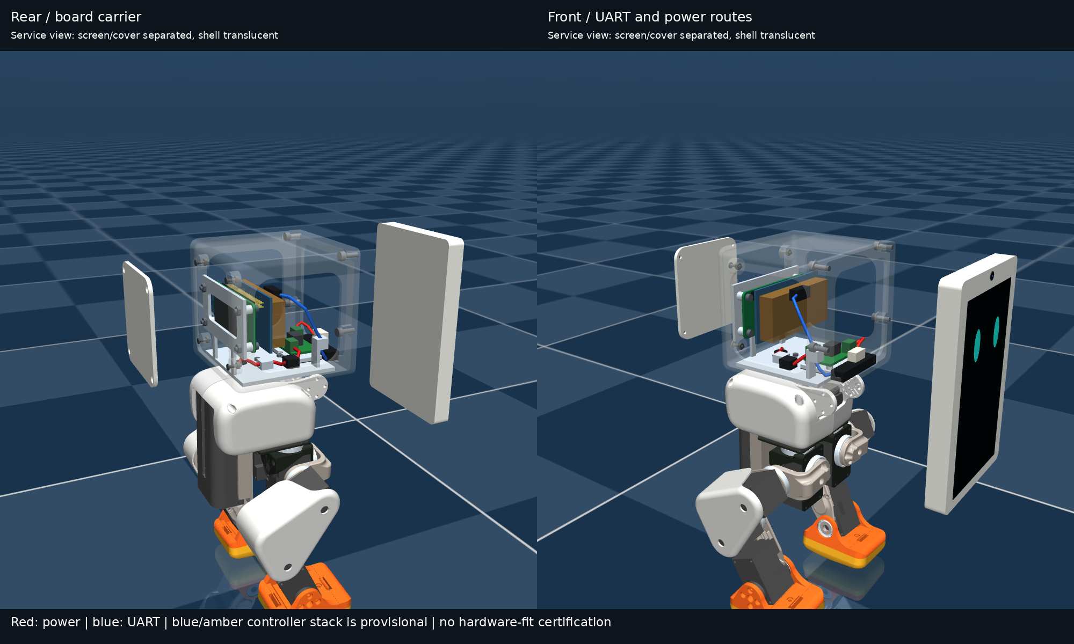
prototype/assembly_uart/assembly_service_view.png
