meganetaaan/microduck-stackchan/prototype/assembly_uart/assembly_views.png

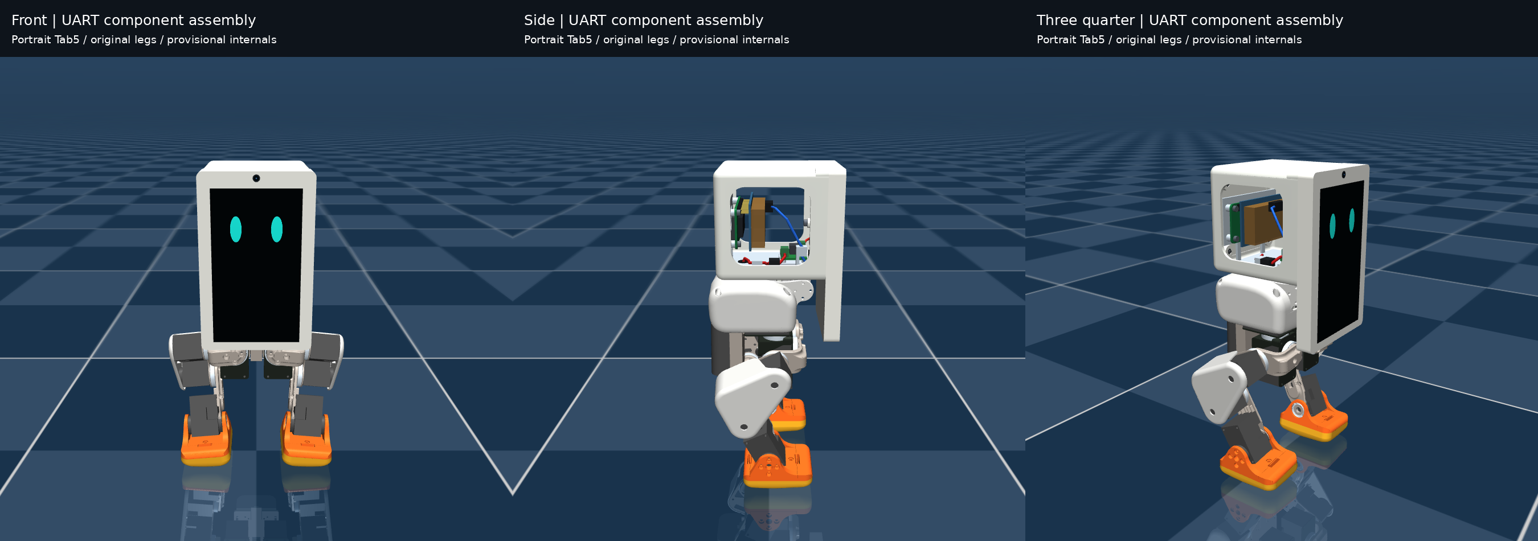
prototype/assembly_uart/assembly_views.png
