meganetaaan/microduck-stackchan/prototype/assembly_uart/screen_visual/screen_closeup.png

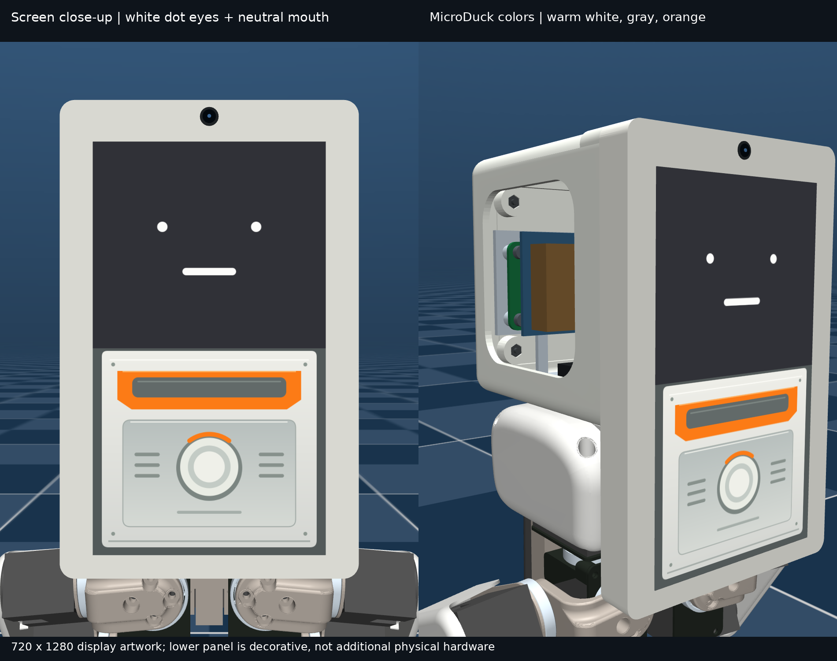
prototype/assembly_uart/screen_visual/screen_closeup.png
