meganetaaan/microduck-stackchan/prototype/assembly_uart/screen_visual/screen_robot_views.png

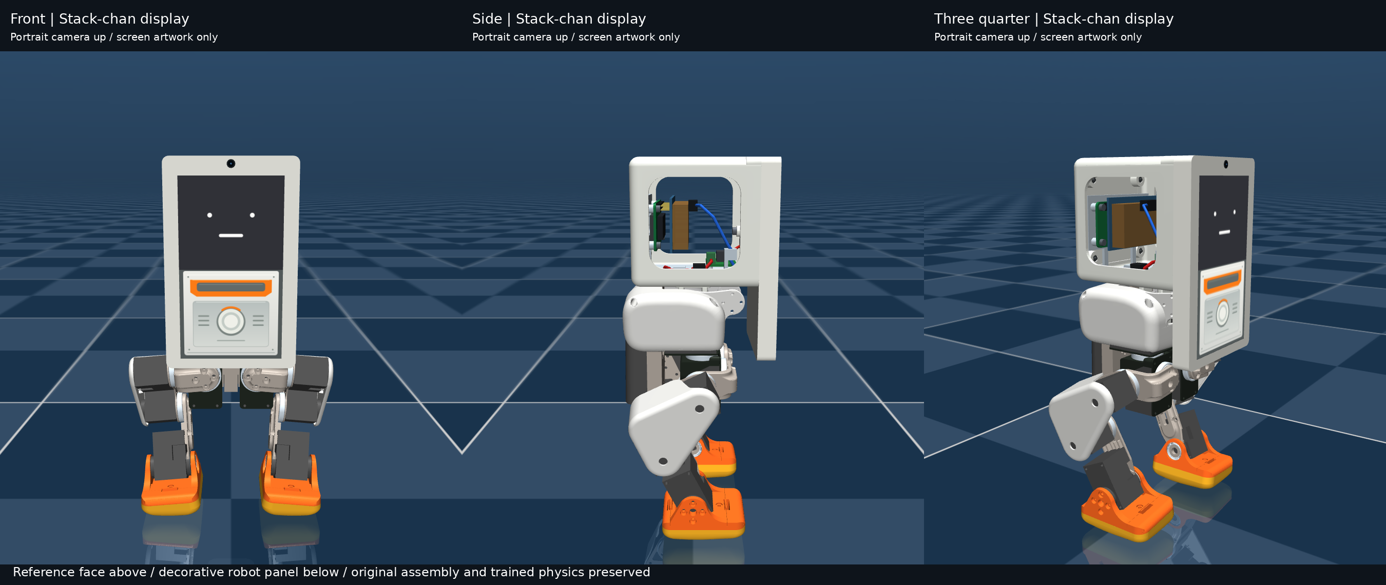
prototype/assembly_uart/screen_visual/screen_robot_views.png
