meganetaaan/microduck-stackchan/prototype/portrait_print/exploded_assembly.png

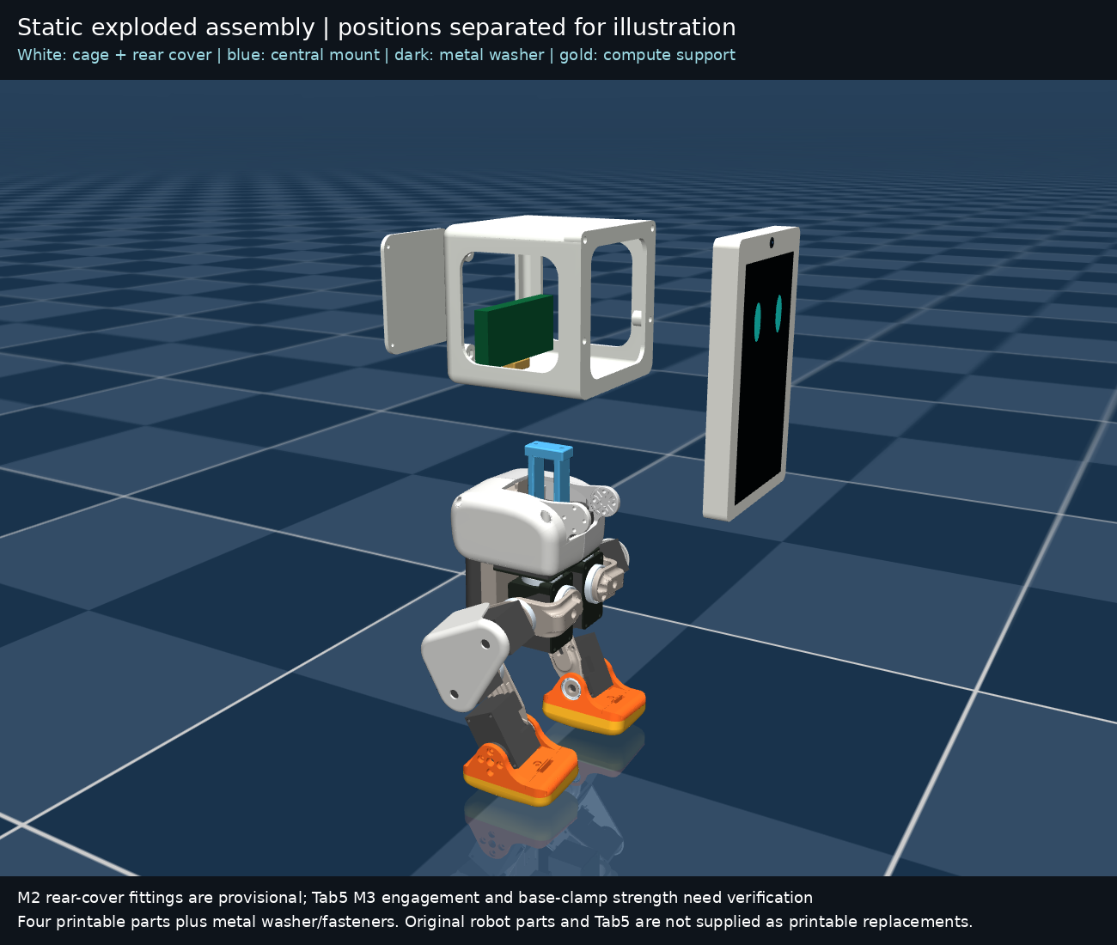
prototype/portrait_print/exploded_assembly.png
