meganetaaan/microduck-stackchan/prototype/portrait_print/flush_interface_comparison.png

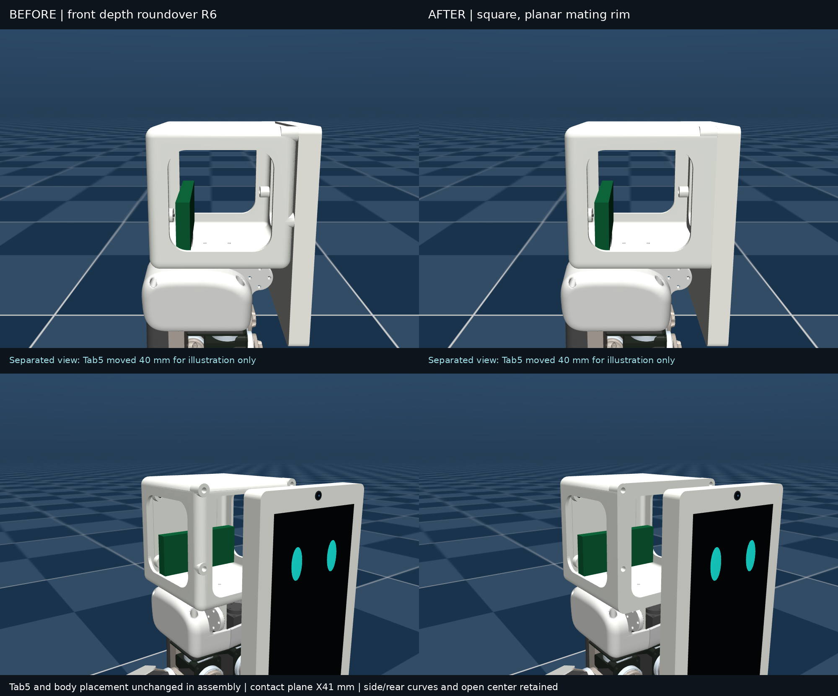
prototype/portrait_print/flush_interface_comparison.png
