meganetaaan/microduck-stackchan/prototype/portrait_print/print_comparison.png

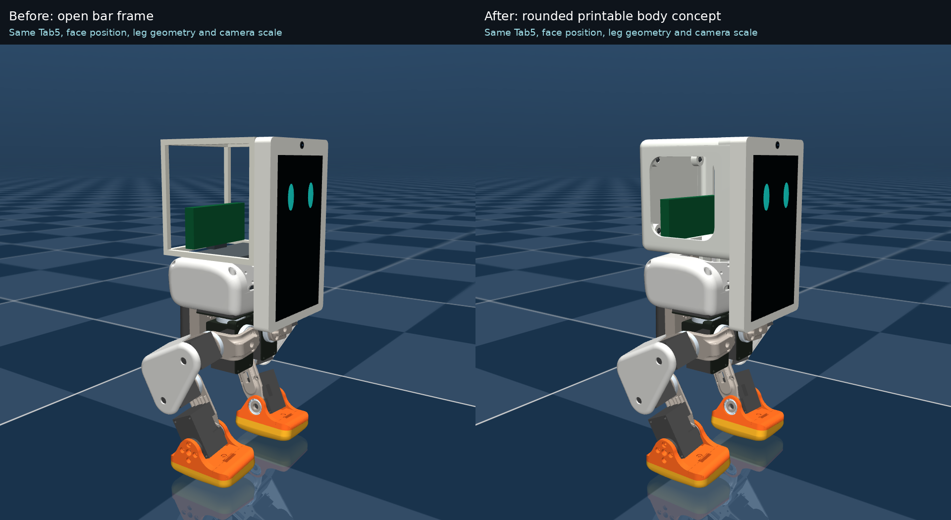
prototype/portrait_print/print_comparison.png
