meganetaaan/microduck-stackchan/prototype/portrait_print/style_reference.png

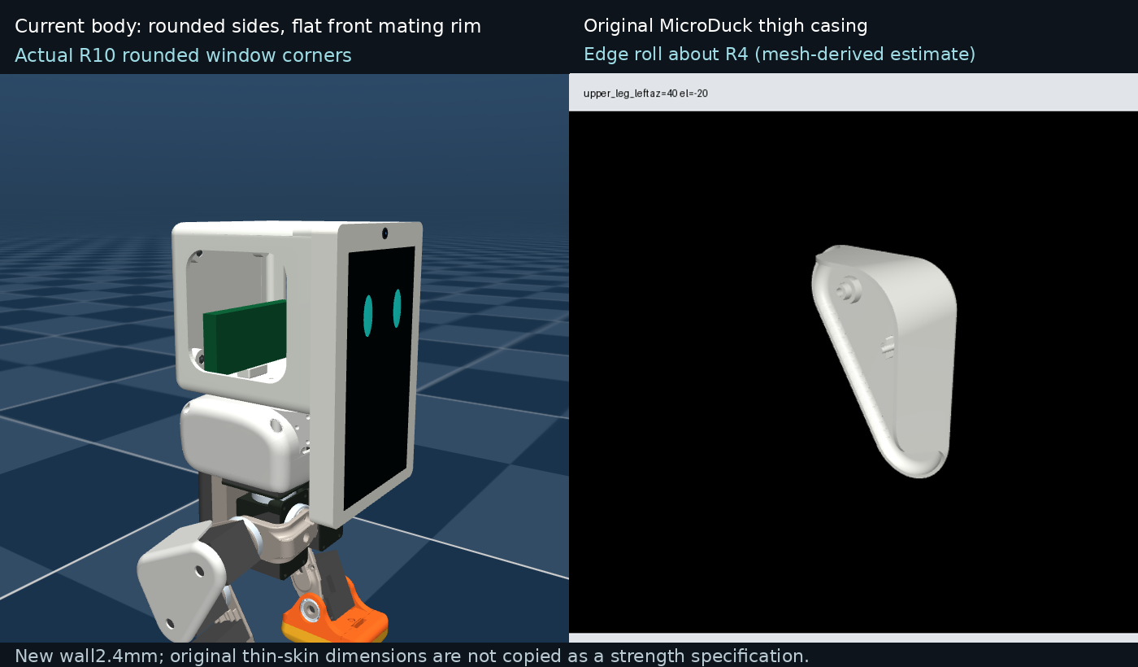
prototype/portrait_print/style_reference.png
