meganetaaan/microduck-stackchan/prototype/portrait_print/walking_frame3s.png

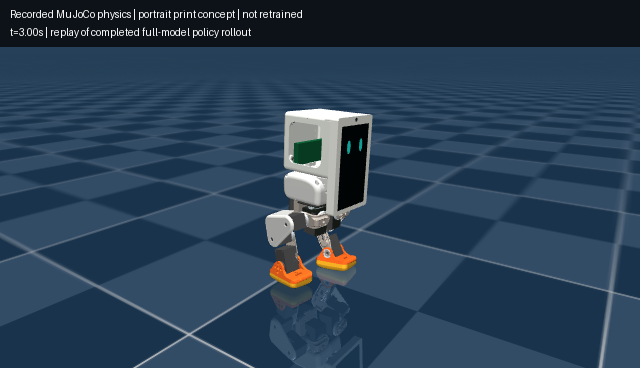
prototype/portrait_print/walking_frame3s.png
