meganetaaan/microduck-stackchan/prototype/results/baseline_velstand_030.csv

time_s | x_m | y_m | z_m | tilt_deg | left_contact | right_contact | max_abs_torque_nm
0.02 | -1.6984412658666358e-05 | -6.707068829203899e-06 | 0.12256041888347227 | 0.04010842378536666 | 0 | 0 | 0.09142579858848887
0.04 | -9.677988391181629e-05 | -1.35188191998027e-05 | 0.11621172753908598 | 0.13254219350521723 | 1 | 1 | 0.05030013170030999
0.05999999999999999 | 0.0003072885298019524 | 3.250993564874603e-05 | 0.11489390065935505 | 0.11448179906379559 | 1 | 1 | 0.0625241148519255
0.08 | 0.0010313142268320908 | 0.00010960904792622728 | 0.1156272914993387 | 0.3209495932916012 | 1 | 1 | 0.06491102254213024
0.10000000000000002 | 0.0018125937921534179 | 8.198684665040739e-05 | 0.11619130742309197 | 0.5302844678985349 | 1 | 1 | 0.05624704828743057
0.12000000000000004 | 0.0024888884843688084 | 2.9705960166886575e-05 | 0.11648870819396957 | 0.7580562365249817 | 1 | 1 | 0.05228737309496645
0.14000000000000004 | 0.0030273980428772583 | 2.456879539727981e-05 | 0.11660410399943931 | 0.9590032741724296 | 1 | 1 | 0.05253584959354774
0.16000000000000006 | 0.0034815251411975797 | 5.3308446317497695e-05 | 0.11661714120476097 | 1.1275182600636566 | 1 | 1 | 0.05483343305909972
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
