meganetaaan/microduck-stackchan/prototype/results/baseline_walk.csv

time_s | x_m | y_m | z_m | tilt_deg | left_contact | right_contact | max_abs_torque_nm
0.02 | -4.3259493146483366e-05 | -1.0942760385910672e-05 | 0.12255115102752707 | 0.050888949608109815 | 0 | 0 | 0.07215586973238707
0.04 | -0.00017844361930716398 | -2.7212510574947924e-05 | 0.11618451406619403 | 0.18125534296275075 | 1 | 1 | 0.0392080521191634
0.05999999999999999 | 0.00025328161259562717 | 1.047108584084239e-05 | 0.11481271437168972 | 0.07874765643407196 | 1 | 1 | 0.056909733807308724
0.08 | 0.0010386039985877979 | 9.383904984132998e-05 | 0.11552385937773403 | 0.28509112407904114 | 1 | 1 | 0.07008023562898626
0.10000000000000002 | 0.0016424203547096223 | 0.0001643815472883166 | 0.1161176235273705 | 0.5321824129320539 | 1 | 1 | 0.05766890301277966
0.12000000000000004 | 0.0020086232211467513 | 0.00022912425937228145 | 0.11644276717310398 | 0.7132511292786642 | 1 | 1 | 0.058934268696808206
0.14000000000000004 | 0.0022348680804062885 | 0.00023633927291828356 | 0.11659015449707072 | 0.8165245083859776 | 1 | 1 | 0.06116844257850052
0.16000000000000006 | 0.0023875706072003944 | 0.0002060002822063613 | 0.11664144954386962 | 0.8782852086761409 | 1 | 1 | 0.06180979429889129
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
