meganetaaan/microduck-stackchan/prototype/results/baseline_walk_030.csv

time_s | x_m | y_m | z_m | tilt_deg | left_contact | right_contact | max_abs_torque_nm
0.02 | -4.3259493146483366e-05 | -1.0942760385910672e-05 | 0.12255115102752707 | 0.050888949608109815 | 0 | 0 | 0.07215586973238707
0.04 | -0.00017820222770421375 | -2.7331848152142384e-05 | 0.11618401679900996 | 0.18188890632872737 | 1 | 1 | 0.0400100831128294
0.05999999999999999 | 0.00026339950205087753 | 8.797900068428757e-06 | 0.11480659479122016 | 0.07655682728079014 | 1 | 1 | 0.056762966855913095
0.08 | 0.001074900007807114 | 9.65225248440765e-05 | 0.1155117982256419 | 0.2770435638760955 | 1 | 1 | 0.07004927131585763
0.10000000000000002 | 0.001805623804440585 | 0.0001639414315432038 | 0.11607992101794003 | 0.5083020740569671 | 1 | 1 | 0.05860289196995164
0.12000000000000004 | 0.002277291965939633 | 0.000257550305409827 | 0.11637972897965716 | 0.7108934432019788 | 1 | 1 | 0.055299082199860836
0.14000000000000004 | 0.002634825058091161 | 0.0003544474131670809 | 0.11647990033404758 | 0.854570522737264 | 1 | 1 | 0.05947509764617308
0.16000000000000006 | 0.0029383119823215946 | 0.0004394771544585109 | 0.11648756358831892 | 0.9448480756318571 | 1 | 1 | 0.06218340636167953
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
