meganetaaan/microduck-stackchan/prototype/results/baseline_walk_fastcheck.csv

time_s | x_m | y_m | z_m | tilt_deg | left_contact | right_contact | max_abs_torque_nm
0.02 | -4.3259493146483366e-05 | -1.0942760385910672e-05 | 0.12255115102752707 | 0.050888949608109815 | 0 | 0 | 0.07215586973238707
0.04 | -0.00017837876591460478 | -2.7318137646829622e-05 | 0.11618426326771591 | 0.18154808602493508 | 1 | 1 | 0.03923927663933006
0.05999999999999999 | 0.000257483547366034 | 9.39348202000759e-06 | 0.1148098539760005 | 0.0776948392876497 | 1 | 1 | 0.05686737138328391
0.08 | 0.0010539227542167233 | 9.400004882520029e-05 | 0.11551874415085875 | 0.2818213879364168 | 1 | 1 | 0.07017296094777721
0.10000000000000002 | 0.001733767568548456 | 0.0001491119071697426 | 0.11609657895659933 | 0.5251133174259278 | 1 | 1 | 0.058700357072599935
0.12000000000000004 | 0.0021500240263688866 | 0.00023023055090611117 | 0.1164090424557129 | 0.724036163131721 | 1 | 1 | 0.05745002967219853
0.14000000000000004 | 0.0024287933248087167 | 0.00029558639841509364 | 0.11653032848808315 | 0.8514748751817987 | 1 | 1 | 0.06065265264431838
0.16000000000000006 | 0.002629862707024953 | 0.0003400179289596493 | 0.11655710322576011 | 0.928746518395382 | 1 | 1 | 0.06262561173724014
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
