meganetaaan/microduck-stackchan/prototype/results/hold_bare_seed1.csv

time_s | x_m | y_m | z_m | tilt_deg | left_contact | right_contact | max_abs_torque_nm
0.02 | 8.122054202091117e-09 | 1.4161693476233114e-08 | 0.12254750792025637 | 1.7245382313122805e-05 | 0 | 0 | 0.004328552500221746
0.04 | 1.628669404416255e-08 | 2.839806141292713e-08 | 0.11617101588220176 | 3.45330068522745e-05 | 1 | 1 | 0.004327273459386368
0.05999999999999999 | 0.00013606060393447705 | -1.372327118696344e-05 | 0.11471811102837577 | 0.2004067395337955 | 1 | 1 | 0.040940326356299565
0.08 | 0.0005138340539691381 | -4.39945591667134e-06 | 0.11525844091169052 | 0.48401090475919417 | 1 | 1 | 0.03604598666559722
0.10000000000000002 | 0.0009015464454323961 | 3.109717785462697e-05 | 0.11566438182716031 | 0.8312167050816347 | 1 | 1 | 0.03387644424319359
0.12000000000000004 | 0.0012270995083269484 | 5.521319765812241e-05 | 0.11583424213141473 | 1.1670023455255394 | 1 | 1 | 0.035433772419819445
0.14000000000000004 | 0.0015087308207747847 | 6.948966231203014e-05 | 0.11584983067430597 | 1.4656508052853825 | 1 | 1 | 0.03700484103778857
0.16000000000000006 | 0.0017532570461740666 | 8.04389103921265e-05 | 0.1157992052037964 | 1.7265428761255097 | 1 | 1 | 0.03821518261416243
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
