meganetaaan/microduck-stackchan/prototype/results/hold_bare_seed2.csv

time_s | x_m | y_m | z_m | tilt_deg | left_contact | right_contact | max_abs_torque_nm
0.02 | -3.1726561847305368e-09 | 7.4303084417173116e-09 | 0.12254748530525678 | 1.1229639039294082e-05 | 0 | 0 | 0.005411933775586304
0.04 | -6.361520684016517e-09 | 1.4900038894571103e-08 | 0.11617097053281457 | 2.2556434745889217e-05 | 1 | 1 | 0.005410381454536473
0.05999999999999999 | -0.0010989953783403753 | -0.00017211847450806196 | 0.11425647092475058 | 0.24197579687207174 | 1 | 1 | 0.06650913724262976
0.08 | -0.0017438350508401578 | -0.0001949716753008254 | 0.11499409453644545 | 0.3124802458321344 | 1 | 1 | 0.05728315753696915
0.10000000000000002 | -0.002031064545939937 | -0.00013111599476198633 | 0.11557403578360943 | 0.28458383110093405 | 1 | 1 | 0.03857951172214618
0.12000000000000004 | -0.0020356944039507927 | -6.45485818625622e-05 | 0.11587303789693236 | 0.2405339319868353 | 1 | 1 | 0.027499018290984504
0.14000000000000004 | -0.0018178432535553722 | -3.3927122841443305e-05 | 0.11596516406279153 | 0.2576168798429042 | 1 | 1 | 0.025779946528459143
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
