meganetaaan/microduck-stackchan/prototype/results/lowcube_bare_front.png

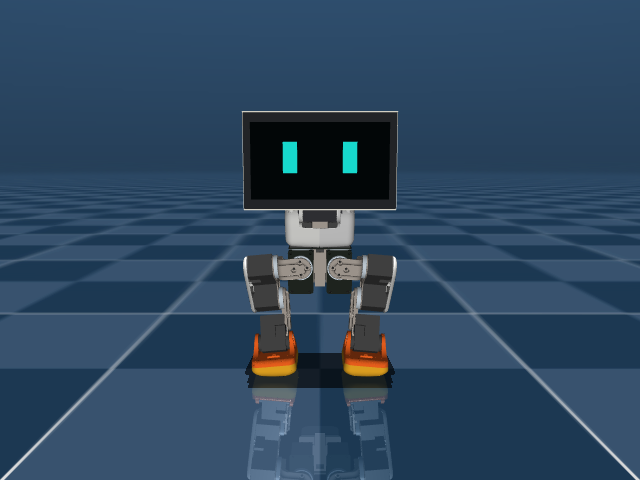
prototype/results/lowcube_bare_front.png
