meganetaaan/microduck-stackchan/prototype/results/lowcube_bare_side.png

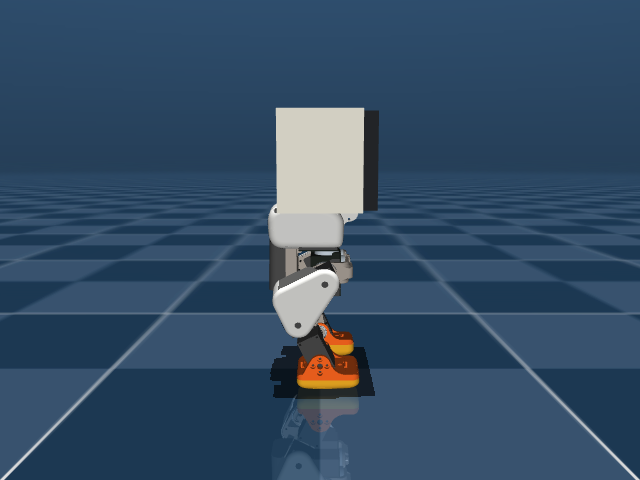
prototype/results/lowcube_bare_side.png
