meganetaaan/microduck-stackchan/prototype/results/lowcube_bare_threequarter.png

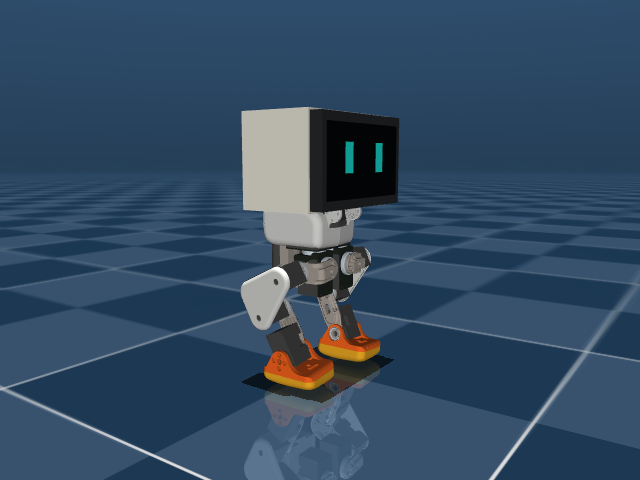
prototype/results/lowcube_bare_threequarter.png
