meganetaaan/microduck-stackchan/prototype/results/lowcube_before_after.png

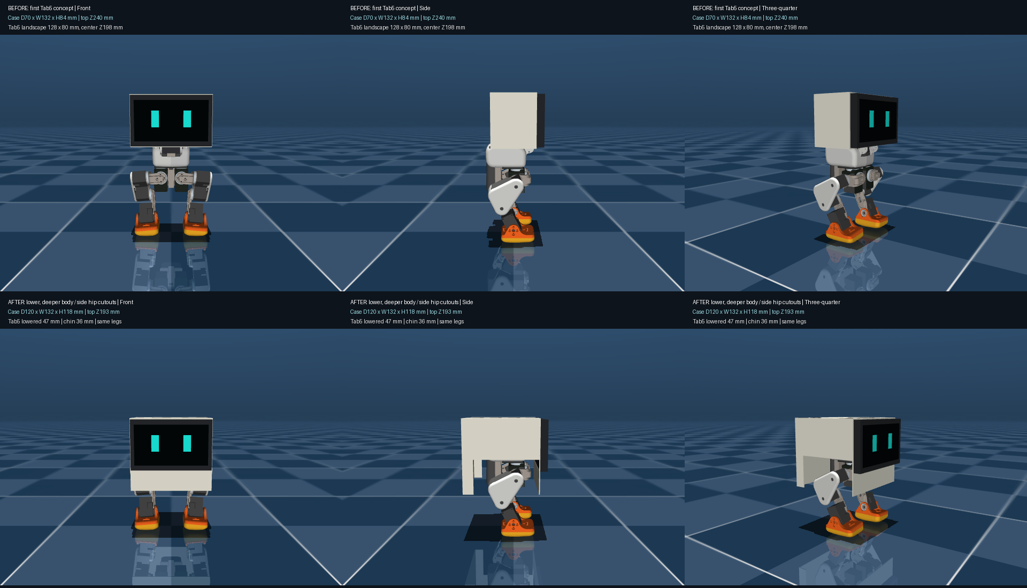
prototype/results/lowcube_before_after.png
