meganetaaan/microduck-stackchan/prototype/results/lowcube_lowcube_front.png

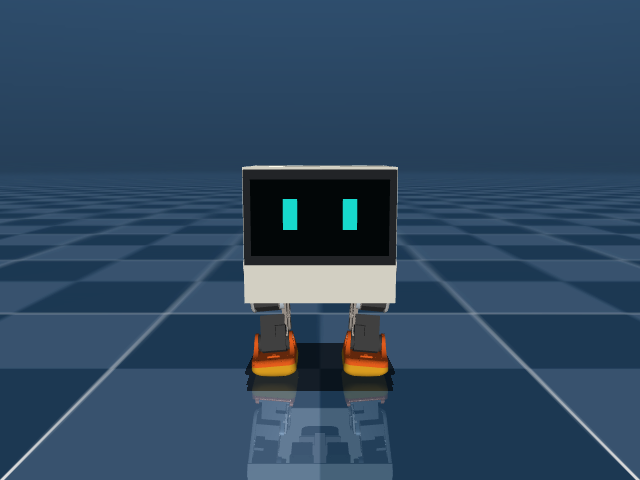
prototype/results/lowcube_lowcube_front.png
