meganetaaan/microduck-stackchan/prototype/results/lowcube_walking_demo_initial.png

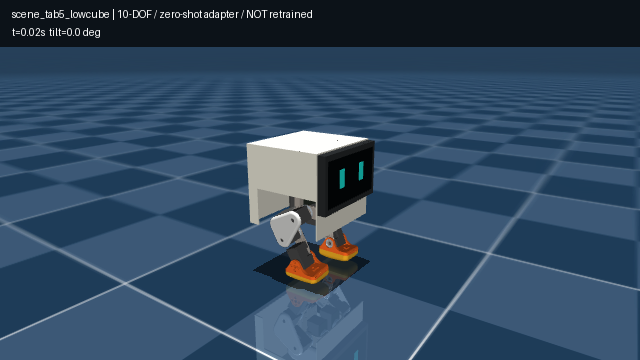
prototype/results/lowcube_walking_demo_initial.png
