meganetaaan/microduck-stackchan/prototype/results/walking_contact_sheet.png

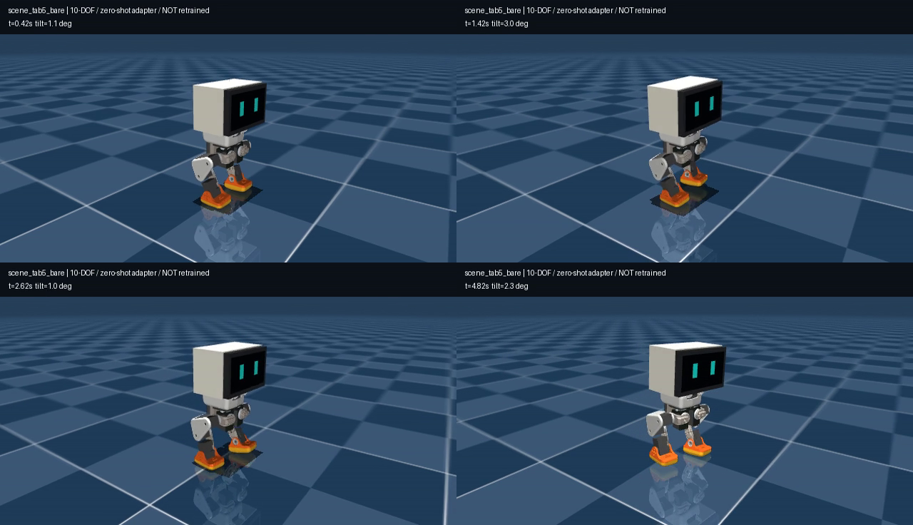
prototype/results/walking_contact_sheet.png
