meganetaaan/microduck-stackchan/training/tab5_gaits/results/training/learning_curves.png

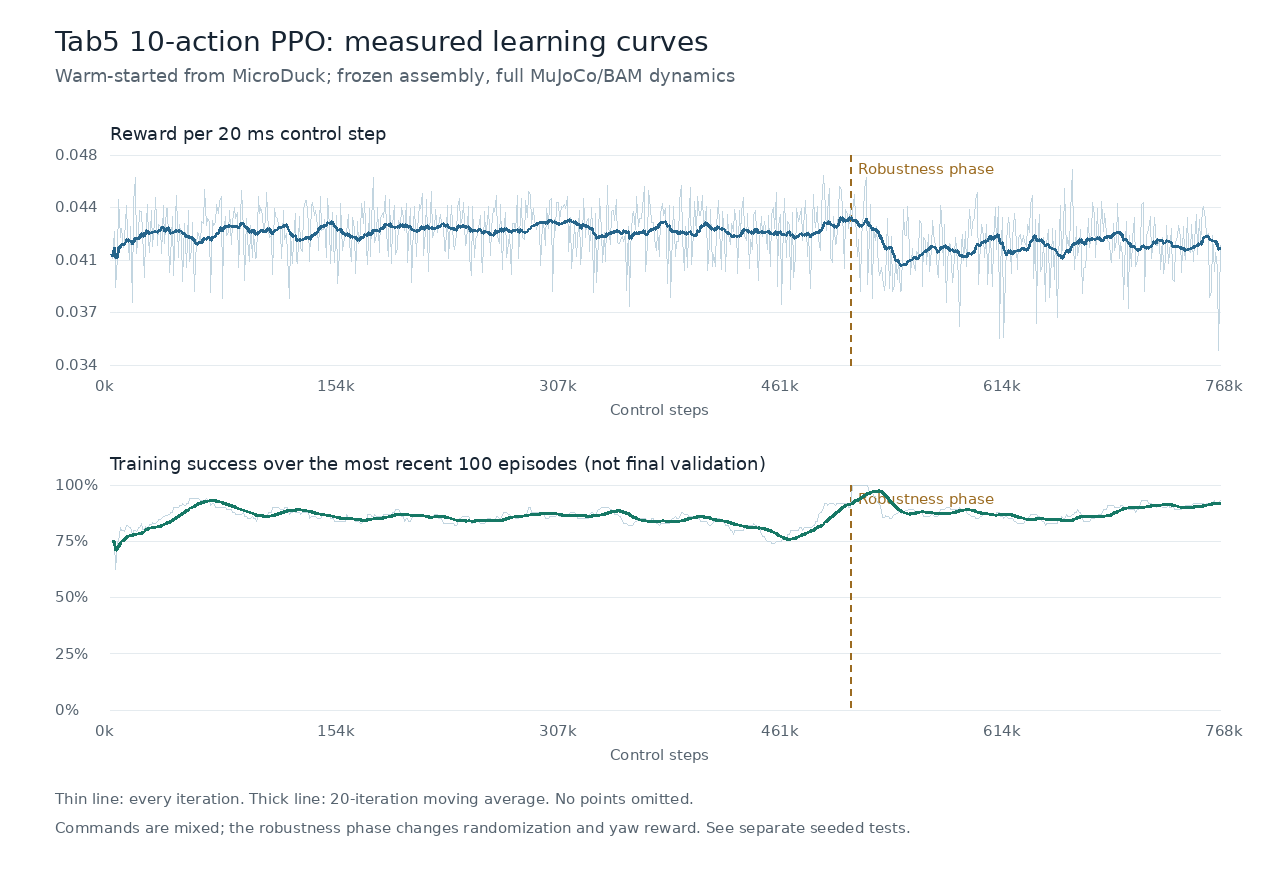
training/tab5_gaits/results/training/learning_curves.png
