meganetaaan/microduck-stackchan/training/tab5_gaits/results/video/backward.png

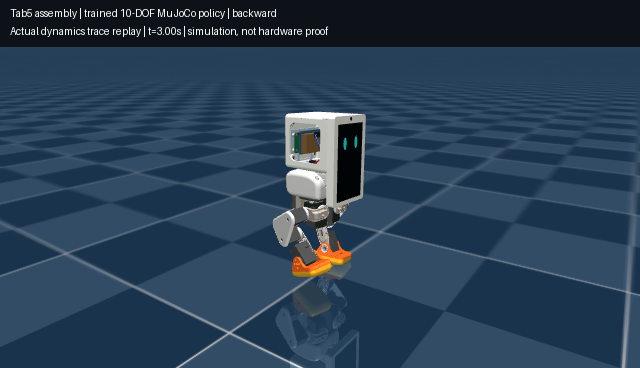
training/tab5_gaits/results/video/backward.png
