meganetaaan/microduck-stackchan/training/tab5_gaits/results/video/forward.png

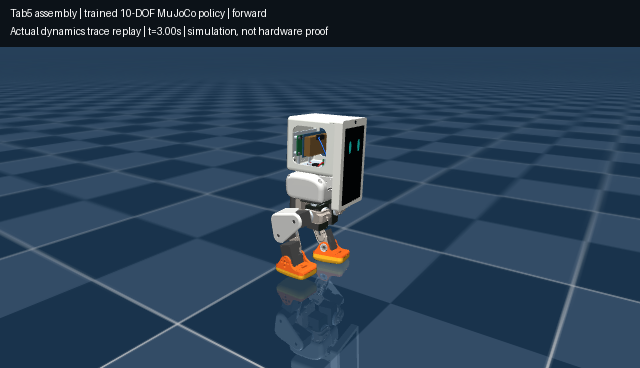
training/tab5_gaits/results/video/forward.png
