meganetaaan/microduck-stackchan/training/tab5_gaits/results/video/forward_slow.png

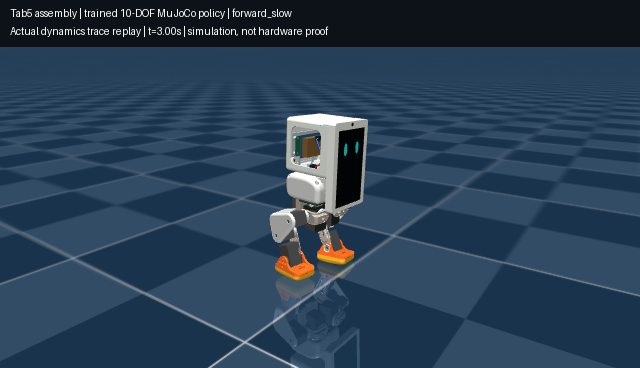
training/tab5_gaits/results/video/forward_slow.png
