meganetaaan/microduck-stackchan/training/tab5_gaits/results/video/left.png

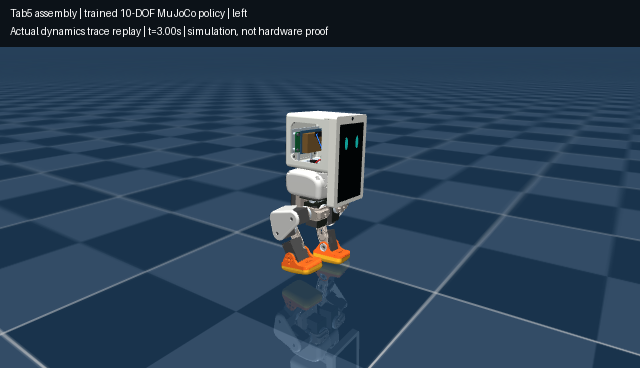
training/tab5_gaits/results/video/left.png
