meganetaaan/microduck-stackchan/training/tab5_gaits/results/video/right.png

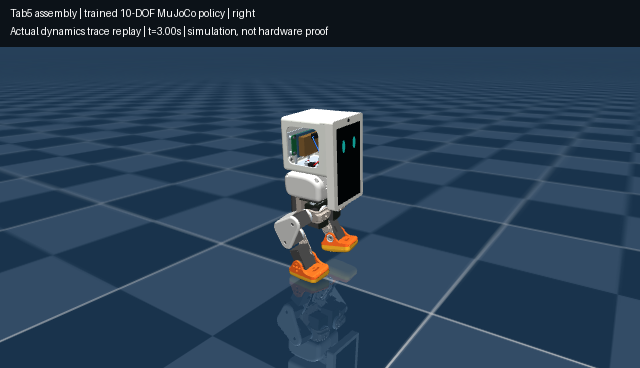
training/tab5_gaits/results/video/right.png
