meganetaaan/microduck-stackchan/training/tab5_gaits/results/video/stand.png

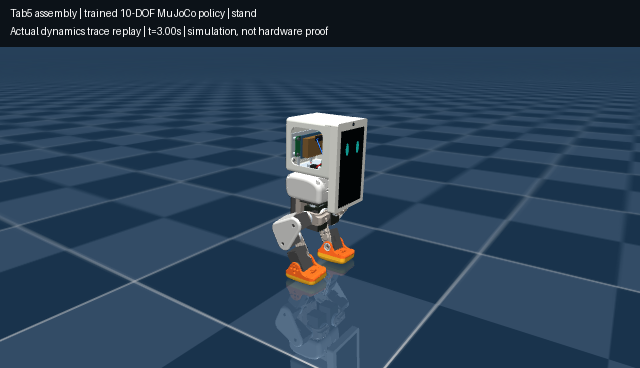
training/tab5_gaits/results/video/stand.png
