meganetaaan/microduck-stackchan/training/tab5_gaits/results/video/turn_left.png

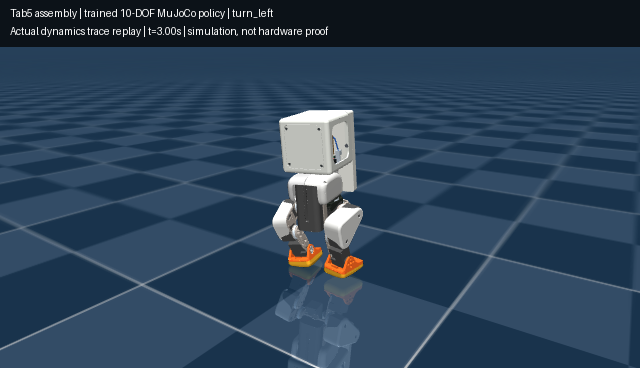
training/tab5_gaits/results/video/turn_left.png
