meganetaaan/microduck-stackchan/web/test-results/screen-orientation-proof.png

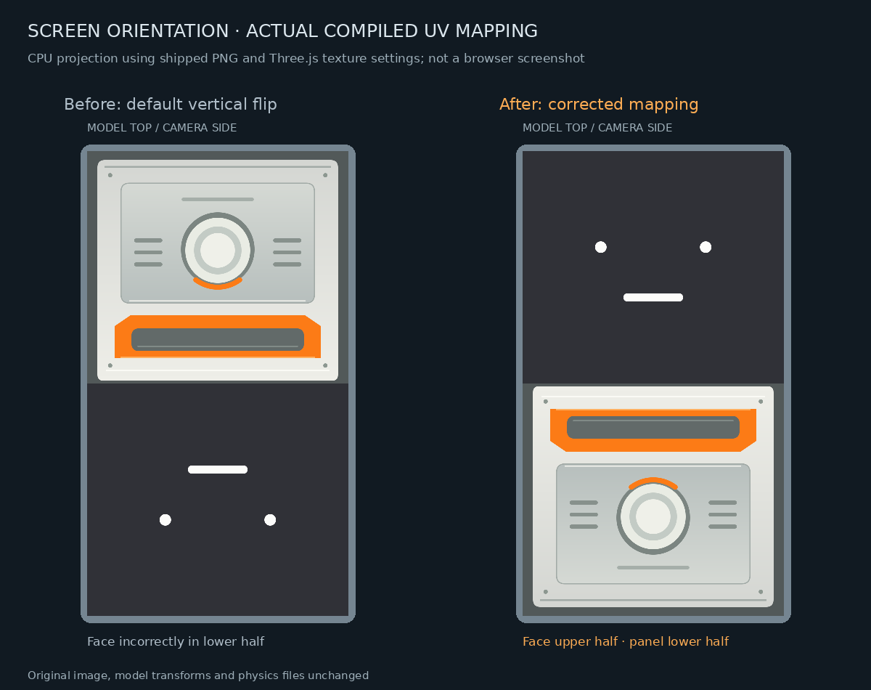
web/test-results/screen-orientation-proof.png
