meganetaaan/microduck-stackchan/HISTORY-MEDIA.md

# Historical media

Earlier renders and videos are retained under their original `prototype/` variant paths. Historical documents record the conditions and limitations of those revisions. These recordings are simulation, not physical robot trials.

The current integrated repository includes gait checkpoints, evaluations and videos under `training/tab5_gaits/`; their tests are distinct from mechanical geometry checks.
