meganetaaan/microduck-stackchan/(commit log)

2026-10-03 Import reviewed models, thin-flap designs, gait training and web simulator
    [01_paddle_display_L_cap_center.obj, 01_paddle_display_L_mount.obj, 01_paddle_display_L_orange_cap.obj, 01_paddle_display_L_paddle.obj, 01_paddle_display_L_shoulder.obj, 01_paddle_display_L_tip_accent.obj, 01_paddle_display_R_cap_center.obj, 01_paddle_display_R_mount.obj]
2026-10-03 Show the Tab5 face in the default camera and record browser verification
