meganetaaan/microduck-stackchan/(notices)

Notices in the files:
web/src/licenses/MODEL-LICENSE.md:
https://github.com/pollen-robotics/microduck_rl/blob/8d0db74916a4f833d1d9b95d6a1d7f4d13b9d5ec/README.md#license
